HW-Lab-Hardware-Design-Agency/jetson-orin-baseboard/3Dlib/PCM12SMTR.step

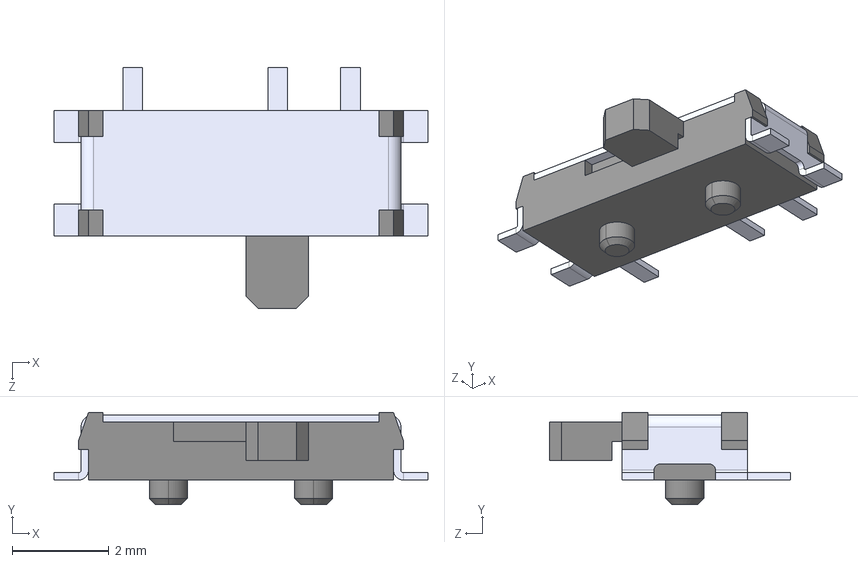
[picture p1: CAD file, 2025-03-19]
3Dlib/PCM12SMTR.step
7.72 x 1.91 x 4.98 mm
