HW-Lab-Hardware-Design-Agency/jetson-orin-baseboard/pulsador.FCStd

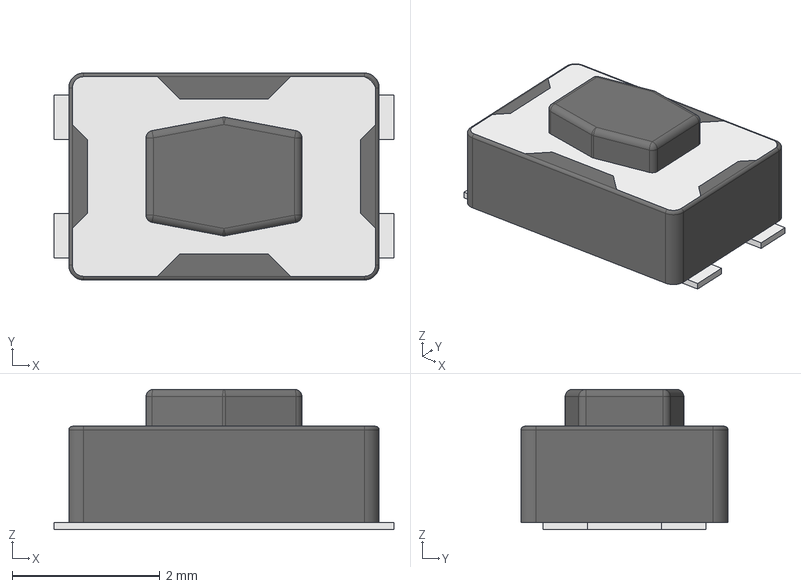
[picture p2: CAD file, 2025-02-21]
pulsador.FCStd
4.60 x 2.80 x 1.90 mm
