HW-Lab-Hardware-Design-Agency/jetson-orin-baseboard/3Dlib/USB4105-GF-A.STEP

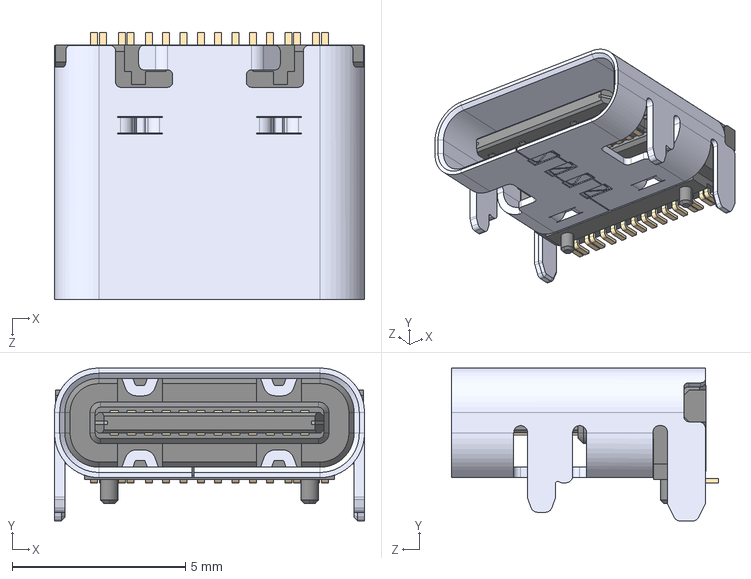
[picture p3: CAD file, 2025-03-05]
3Dlib/USB4105-GF-A.STEP
8.94 x 4.41 x 7.71 mm
