HW-Lab-Hardware-Design-Agency/jetson-orin-baseboard/3Dlib/TUSB1046-DCIRNQT.STEP

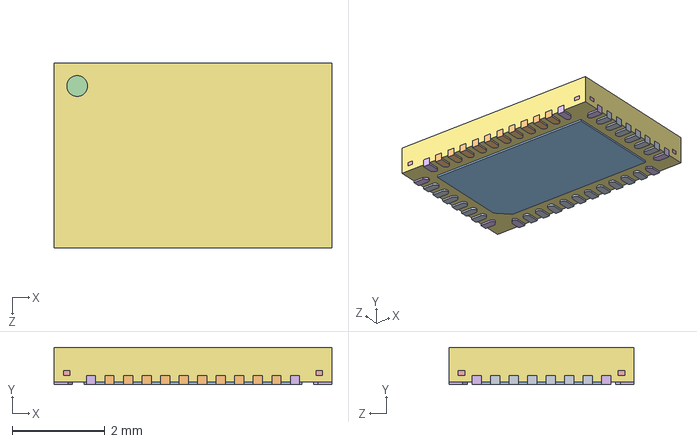
[picture p4: CAD file, 2025-03-05]
3Dlib/TUSB1046-DCIRNQT.STEP
6.00 x 0.8 x 4.00 mm
