HW-Lab-Hardware-Design-Agency/jetson-orin-baseboard/3Dlib/NTS0102GT,115.stp

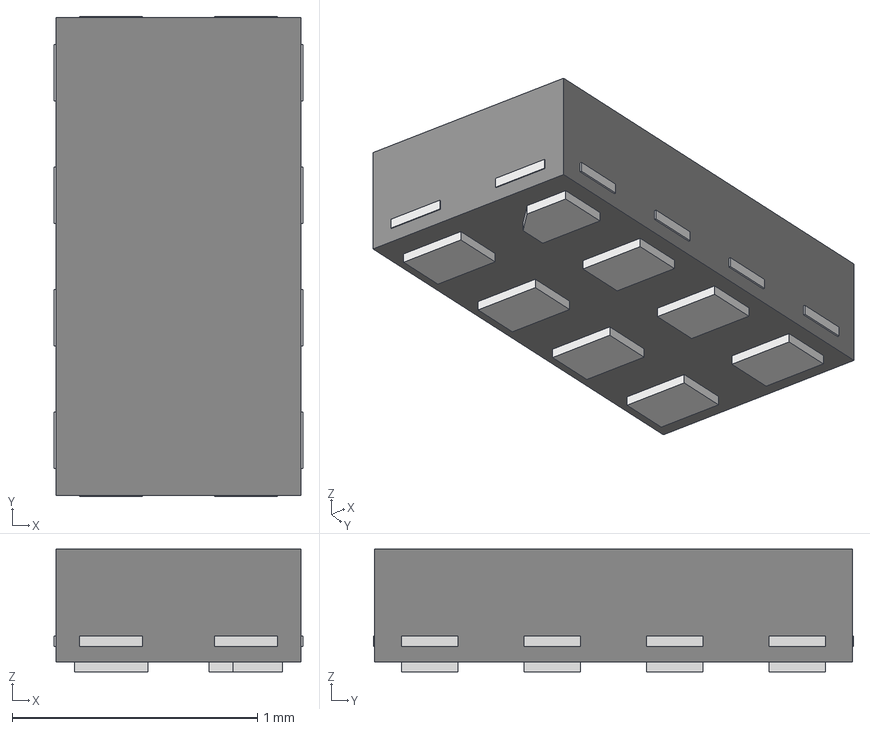
[picture p5: CAD file, 2025-02-21]
3Dlib/NTS0102GT,115.stp
1.02 x 1.96 x 0.5 mm
