HW-Lab-Hardware-Design-Agency/jetson-orin-baseboard/3Dlib/33FXRH-SM1-GAN-TF.STEP

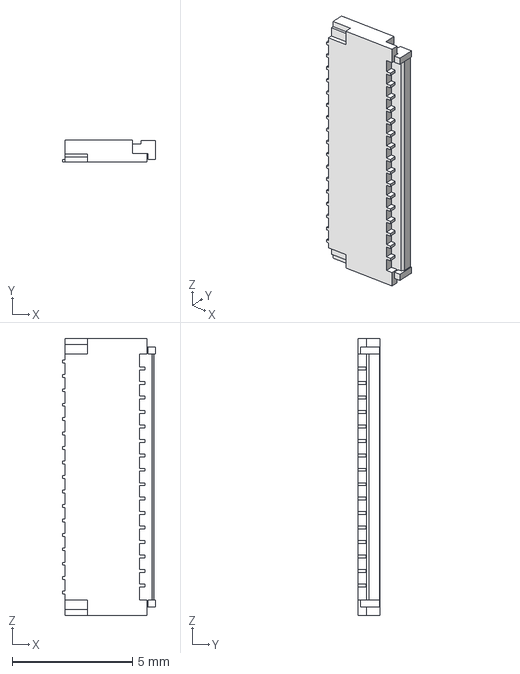
[picture p6: CAD file, 2025-02-21]
3Dlib/33FXRH-SM1-GAN-TF.STEP
3.85 x 0.9 x 11.5 mm
