HW-Lab-Hardware-Design-Agency/jetson-orin-baseboard/3Dlib/Crystal_SMD_3225-4Pin_3.2x2.5mm.step

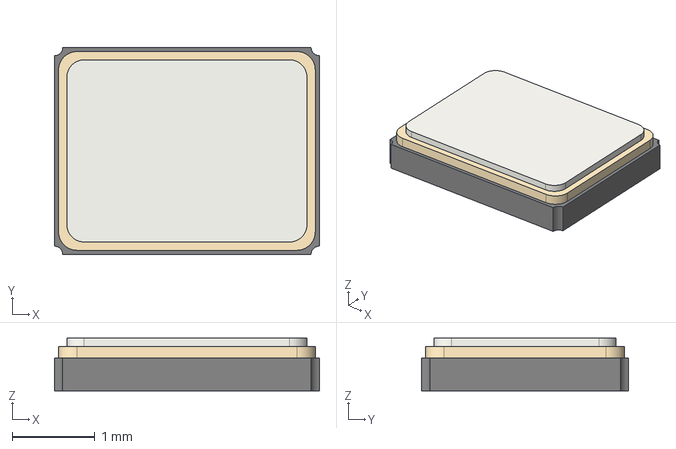
[picture p7: CAD file, 2025-02-21]
3Dlib/Crystal_SMD_3225-4Pin_3.2x2.5mm.step
3.20 x 2.50 x 0.64 mm
