HW-Lab-Hardware-Design-Agency/jetson-orin-baseboard/3Dlib/5-2337992-8.stp

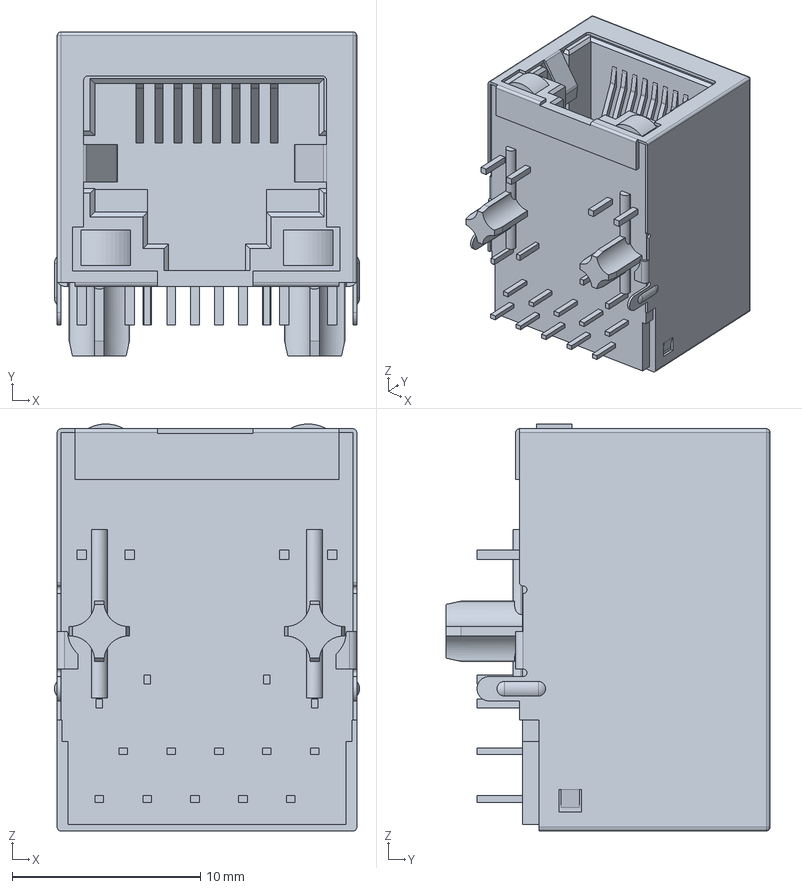
[picture p8: CAD file, 2025-02-21]
3Dlib/5-2337992-8.stp
16.2 x 17.2 x 21.6 mm
