HW-Lab-Hardware-Design-Agency/jetson-orin-baseboard/3Dlib/D_SMA.step

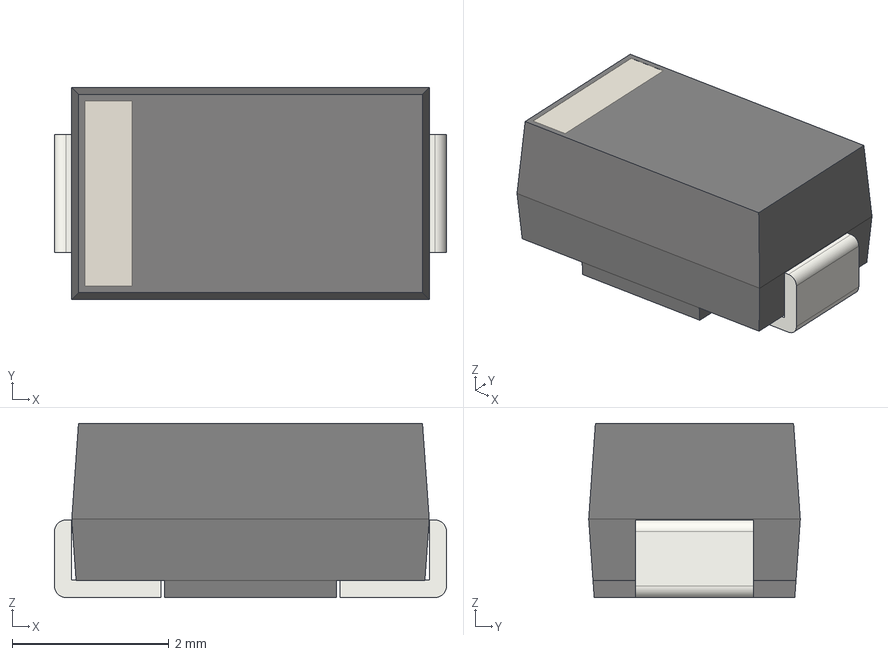
[picture p9: CAD file, 2025-02-21]
3Dlib/D_SMA.step
5.00 x 2.70 x 2.22 mm
