HW-Lab-Hardware-Design-Agency/jetson-orin-baseboard/3Dlib/ESP32-S3R8.stp

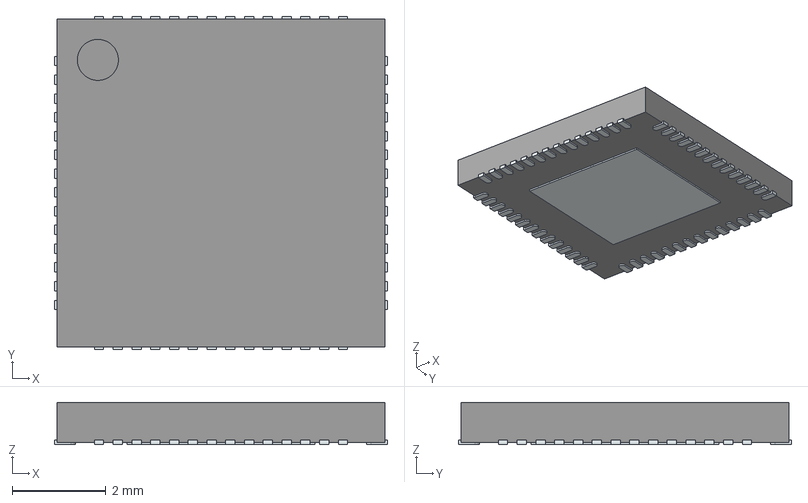
[picture p10: CAD file, 2025-02-21]
3Dlib/ESP32-S3R8.stp
7.10 x 7.10 x 0.9 mm
ThermalPin
PinsArrayLR
PinsArrayTB
