HW-Lab-Hardware-Design-Agency/jetson-orin-baseboard/3Dlib/L_1206_3216Metric.step

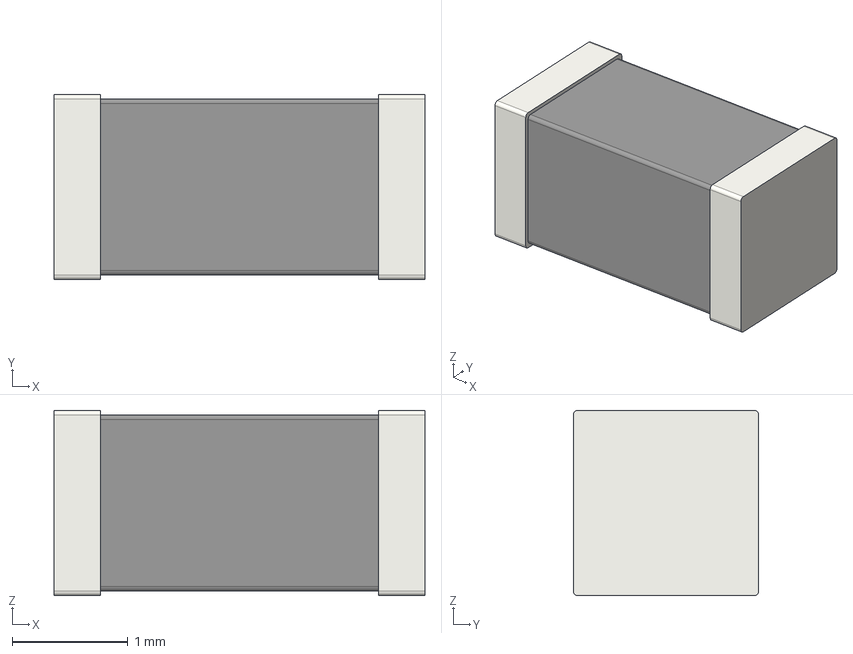
[picture p11: CAD file, 2025-02-21]
3Dlib/L_1206_3216Metric.step
3.20 x 1.60 x 1.60 mm
