HW-Lab-Hardware-Design-Agency/jetson-orin-baseboard/3Dlib/r_0402_h040.step

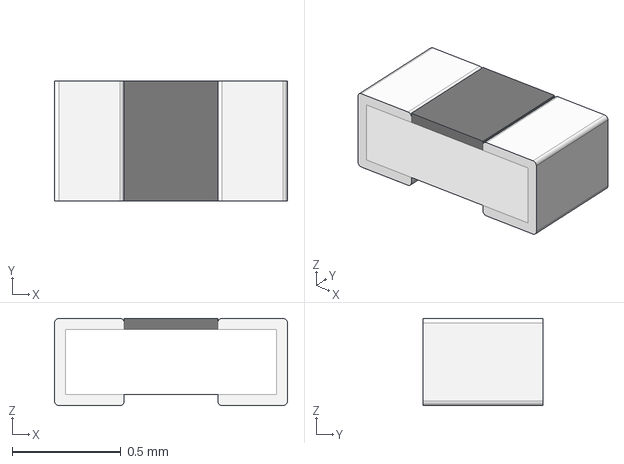
[picture p12: CAD file, 2025-02-21]
3Dlib/r_0402_h040.step
1.07 x 0.55 x 0.4 mm
