HW-Lab-Hardware-Design-Agency/jetson-orin-baseboard/3Dlib/SOT-23-6.step

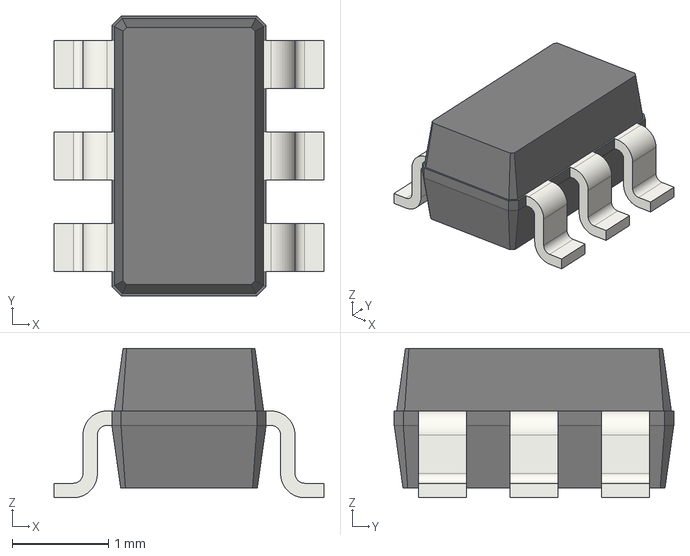
[picture p13: CAD file, 2025-02-21]
3Dlib/SOT-23-6.step
2.80 x 2.90 x 1.55 mm
