HW-Lab-Hardware-Design-Agency/jetson-orin-baseboard/3Dlib/c_1206_h078.step

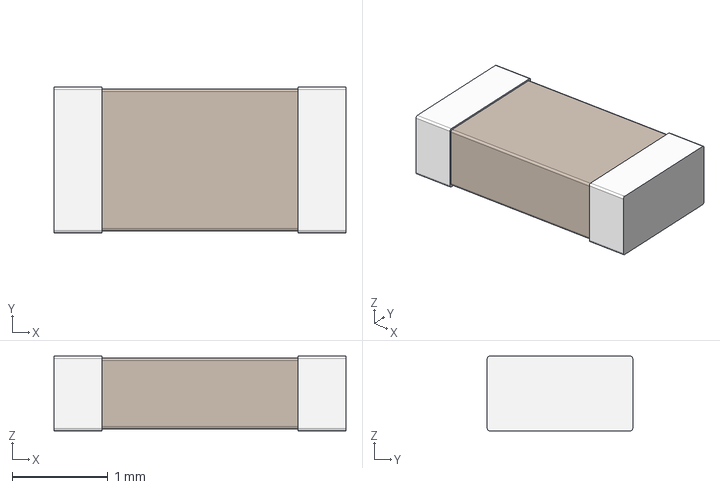
[picture p14: CAD file, 2025-02-21]
3Dlib/c_1206_h078.step
3.05 x 1.52 x 0.78 mm
