HW-Lab-Hardware-Design-Agency/jetson-orin-baseboard/3Dlib/USB_C_HC019-1E1H1A103-0HR.step

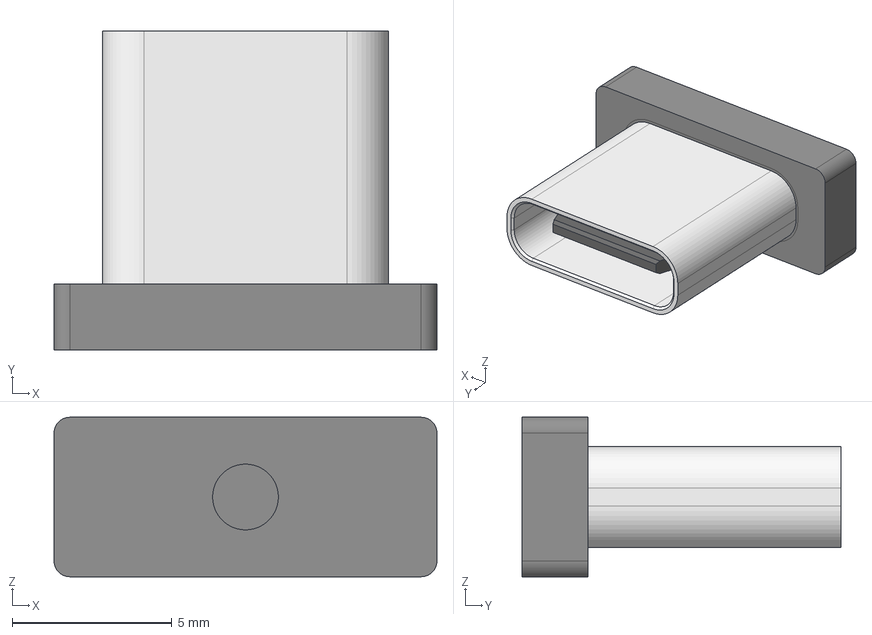
[picture p15: CAD file, 2025-02-21]
3Dlib/USB_C_HC019-1E1H1A103-0HR.step
12.0 x 10.0 x 5.00 mm
