HW-Lab-Hardware-Design-Agency/jetson-orin-baseboard/3Dlib/L_0402_1005Metric.step

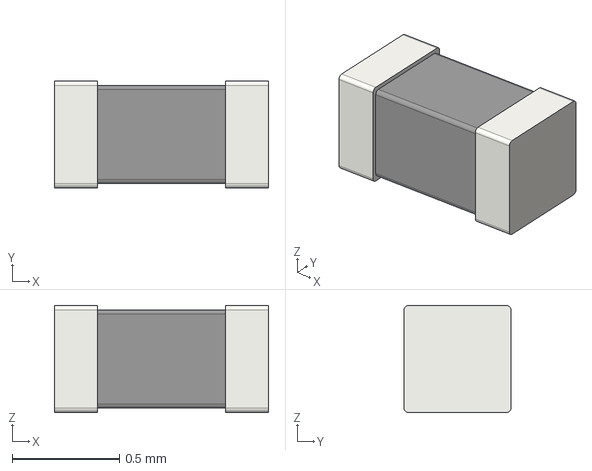
[picture p16: CAD file, 2025-02-21]
3Dlib/L_0402_1005Metric.step
1.00 x 0.5 x 0.5 mm
