HW-Lab-Hardware-Design-Agency/jetson-orin-baseboard/3Dlib/D_SOD-523.step

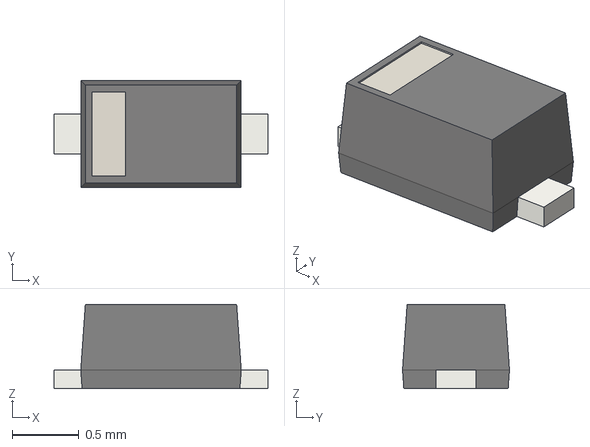
[picture p17: CAD file, 2025-02-21]
3Dlib/D_SOD-523.step
1.60 x 0.8 x 0.63 mm
