HW-Lab-Hardware-Design-Agency/jetson-orin-baseboard/3Dlib/SOT-223.step

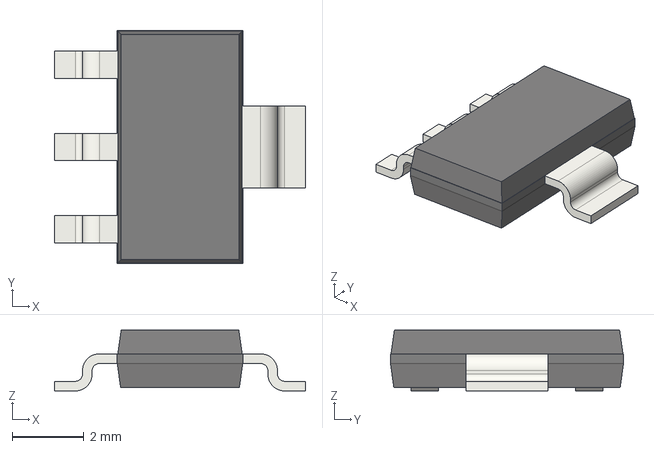
[picture p18: CAD file, 2025-02-21]
3Dlib/SOT-223.step
7.00 x 6.50 x 1.70 mm
