HW-Lab-Hardware-Design-Agency/jetson-orin-baseboard/3Dlib/TPD1E0B04DPYR.STEP

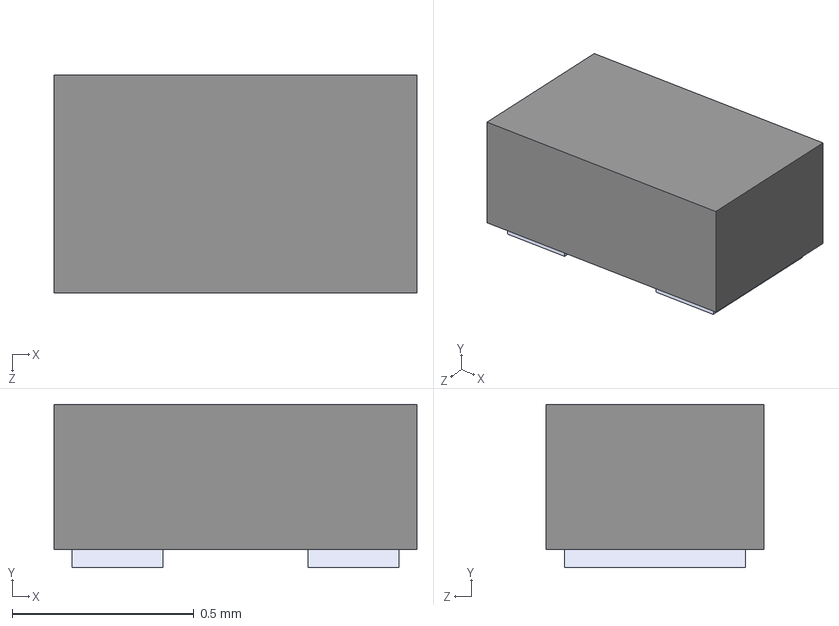
[picture p19: CAD file, 2025-02-21]
3Dlib/TPD1E0B04DPYR.STEP
1.00 x 0.45 x 0.6 mm
