HW-Lab-Hardware-Design-Agency/jetson-orin-baseboard/3Dlib/MS621FE-FL11E--3DModel-STEP-510211.STEP

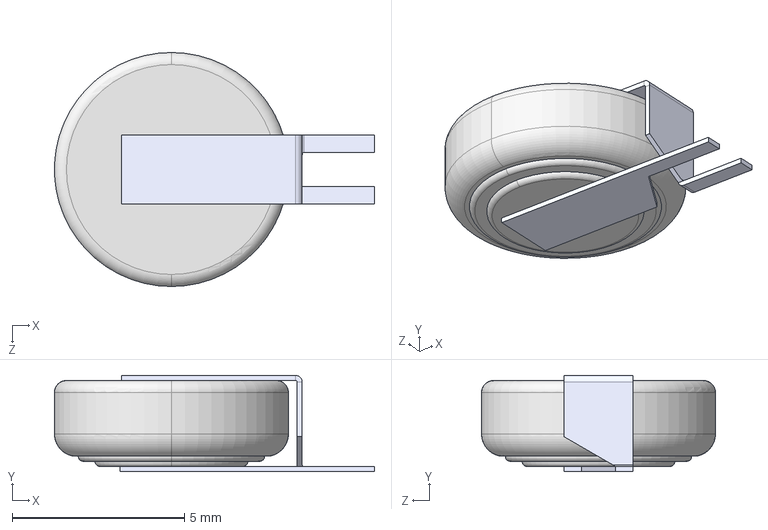
[picture p20: CAD file, 2025-02-21]
3Dlib/MS621FE-FL11E--3DModel-STEP-510211.STEP
9.30 x 2.80 x 6.80 mm
