HW-Lab-Hardware-Design-Agency/jetson-orin-baseboard/3Dlib/c_1210.step

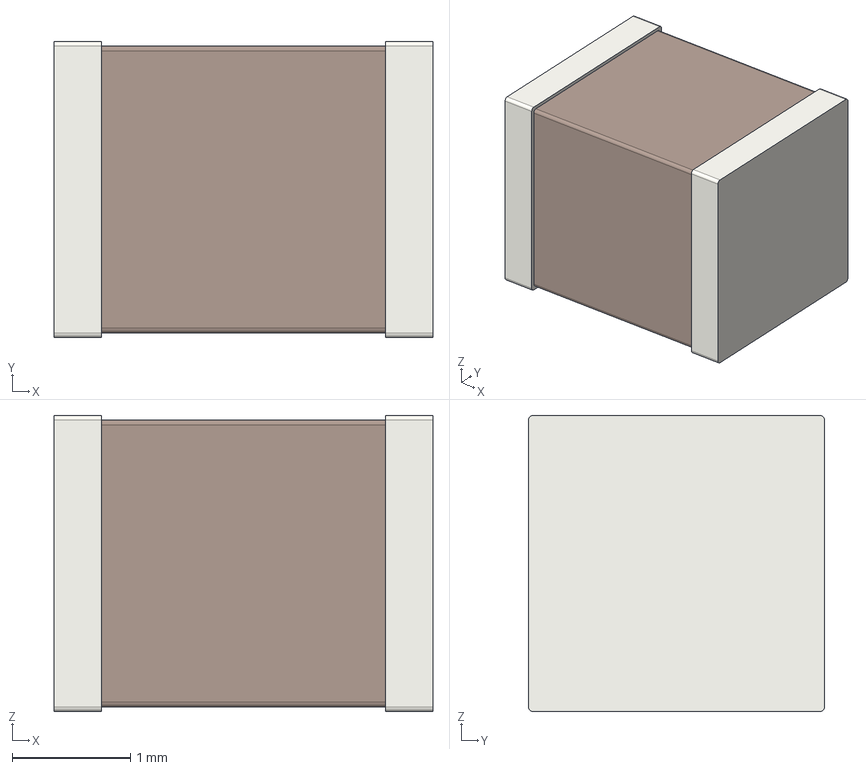
[picture p21: CAD file, 2025-02-21]
3Dlib/c_1210.step
3.20 x 2.50 x 2.50 mm
