HW-Lab-Hardware-Design-Agency/jetson-orin-baseboard/3Dlib/soic_8_39x49_p127.step

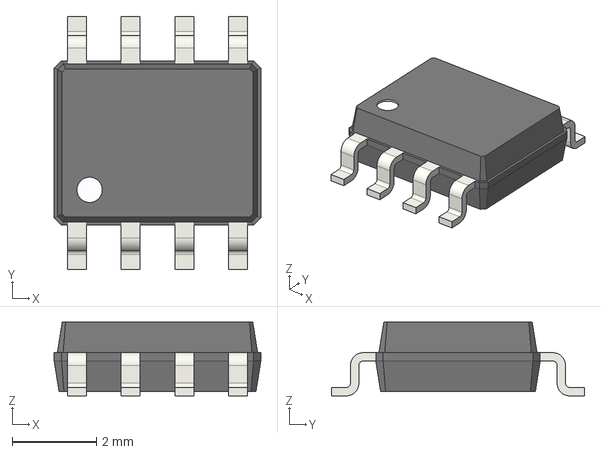
[picture p22: CAD file, 2025-02-21]
3Dlib/soic_8_39x49_p127.step
4.90 x 6.00 x 1.75 mm
