HW-Lab-Hardware-Design-Agency/jetson-orin-baseboard/3Dlib/MDA7030-220M.step

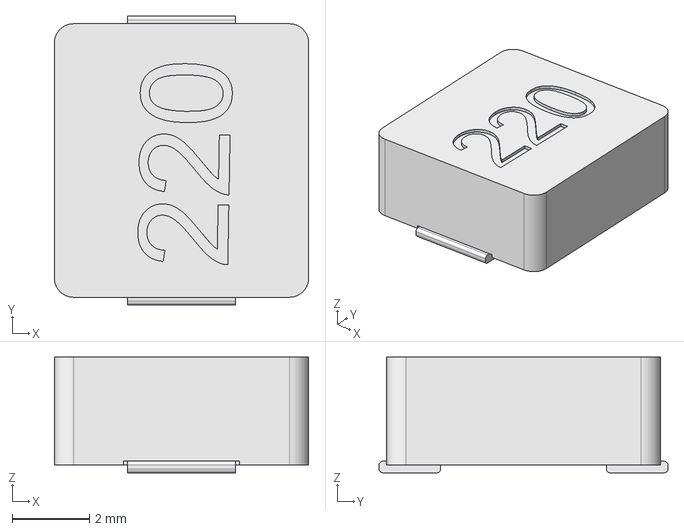
[picture p23: CAD file, 2025-02-21]
3Dlib/MDA7030-220M.step
6.60 x 7.50 x 3.00 mm
