HW-Lab-Hardware-Design-Agency/jetson-orin-baseboard/3Dlib/led_0603.step

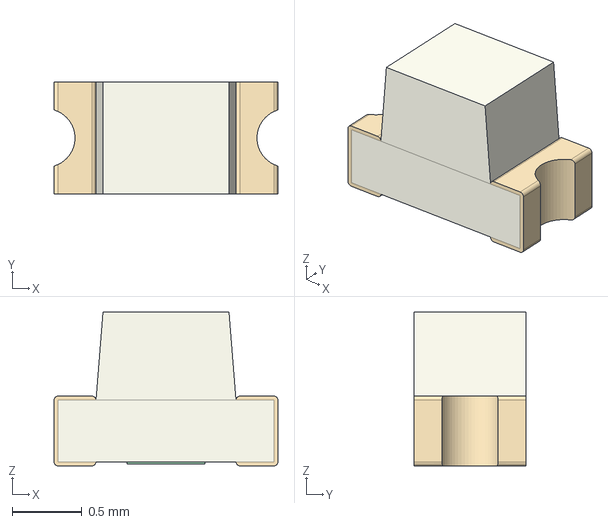
[picture p24: CAD file, 2025-02-21]
3Dlib/led_0603.step
1.60 x 0.8 x 1.10 mm
