HW-Lab-Hardware-Design-Agency/jetson-orin-baseboard/3Dlib/L_0201_0603Metric.step

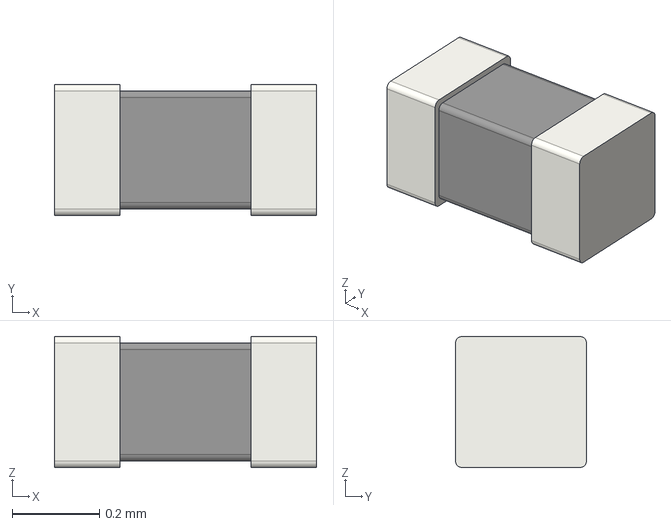
[picture p25: CAD file, 2025-02-21]
3Dlib/L_0201_0603Metric.step
0.6 x 0.3 x 0.3 mm
