HW-Lab-Hardware-Design-Agency/jetson-orin-baseboard/3Dlib/AXPM65611.step

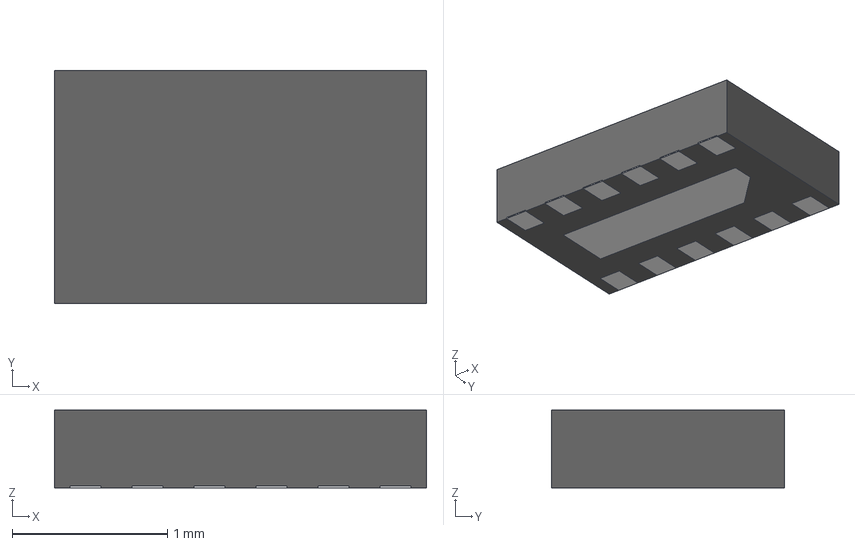
[picture p26: CAD file, 2025-02-21]
3Dlib/AXPM65611.step
2.40 x 1.50 x 0.5 mm
main_Body001
mainPad001
