HW-Lab-Hardware-Design-Agency/jetson-orin-baseboard/3Dlib/B3U_1000P.step

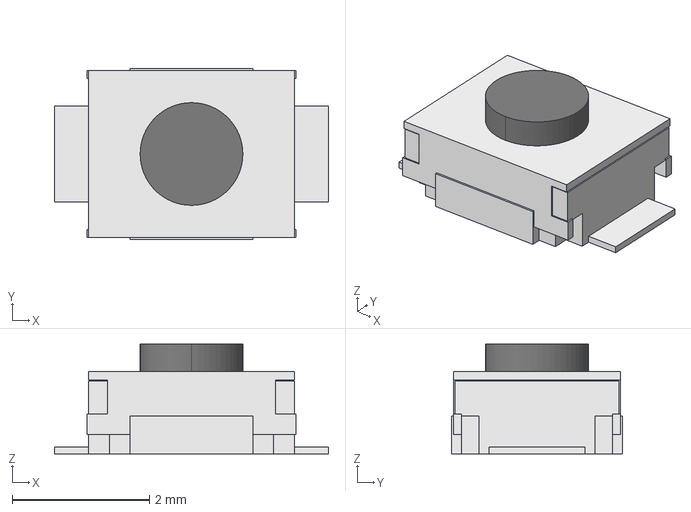
[picture p27: CAD file, 2025-02-21]
3Dlib/B3U_1000P.step
4.00 x 2.50 x 1.60 mm
