HW-Lab-Hardware-Design-Agency/jetson-orin-baseboard/3Dlib/sot23_3_25x30_p095.step

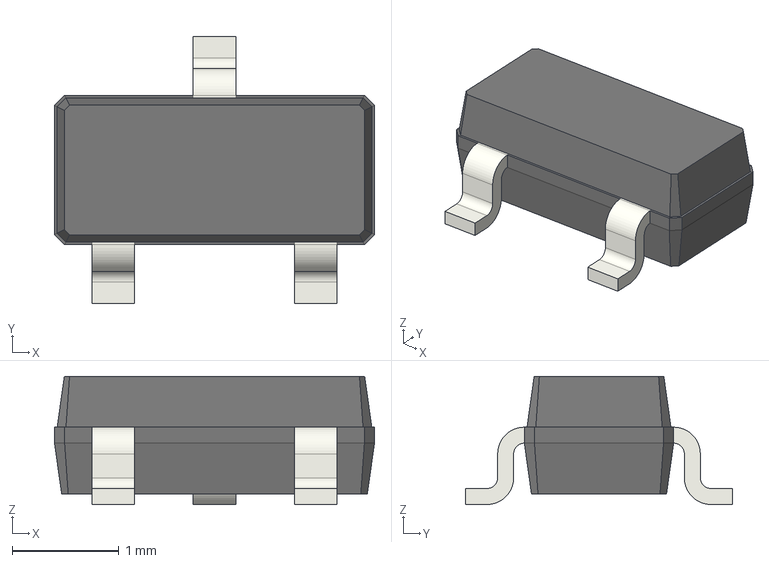
[picture p28: CAD file, 2025-02-21]
3Dlib/sot23_3_25x30_p095.step
3.00 x 2.50 x 1.20 mm
