HW-Lab-Hardware-Design-Agency/jetson-orin-baseboard/3Dlib/D_SOD-123.step

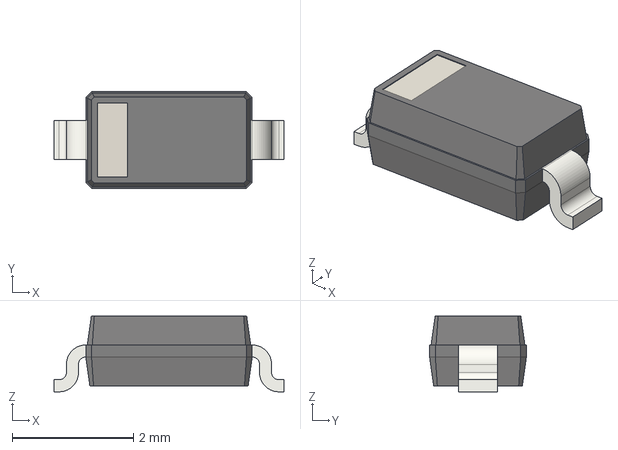
[picture p29: CAD file, 2025-02-21]
3Dlib/D_SOD-123.step
3.80 x 1.60 x 1.25 mm
