HW-Lab-Hardware-Design-Agency/jetson-orin-baseboard/3Dlib/c_0603_h078.step

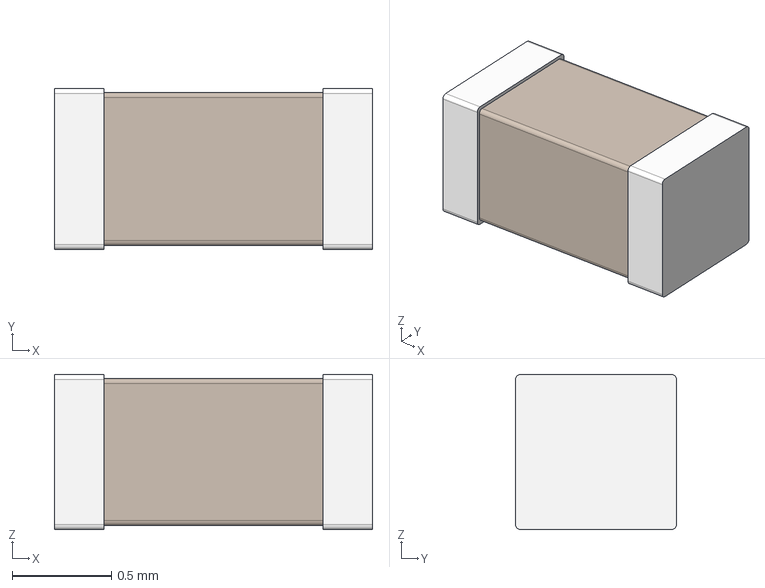
[picture p31: CAD file, 2025-02-21]
3Dlib/c_0603_h078.step
1.60 x 0.81 x 0.78 mm
