HW-Lab-Hardware-Design-Agency/jetson-orin-baseboard/3Dlib/BRFL2518T1R0M.STEP

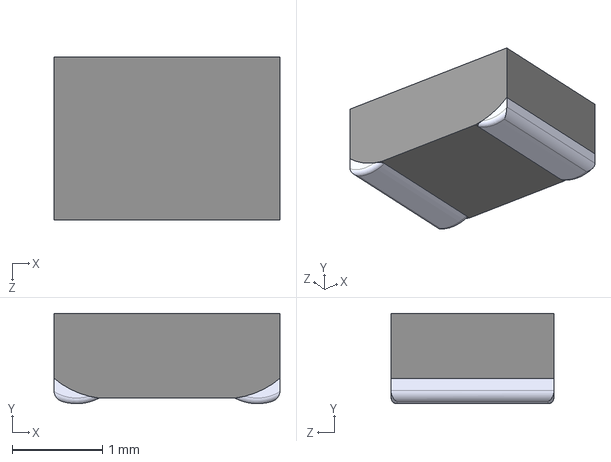
[picture p32: CAD file, 2025-02-21]
3Dlib/BRFL2518T1R0M.STEP
2.50 x 1 x 1.80 mm
