HW-Lab-Hardware-Design-Agency/jetson-orin-baseboard/3Dlib/c_0805_h078.step

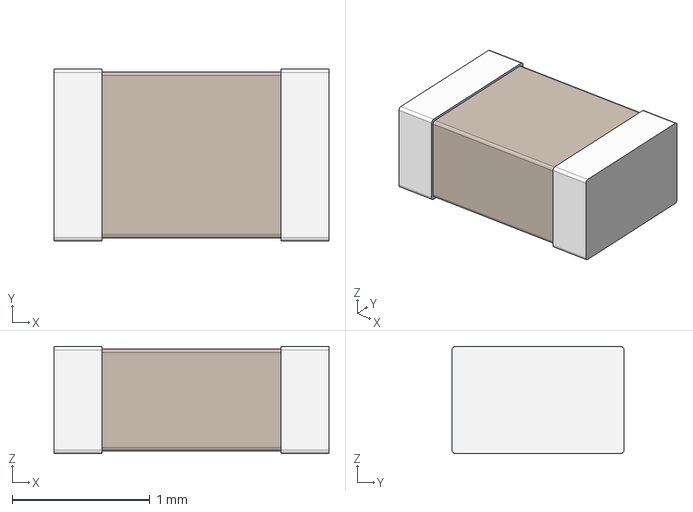
[picture p33: CAD file, 2025-02-21]
3Dlib/c_0805_h078.step
2.00 x 1.25 x 0.78 mm
