HW-Lab-Hardware-Design-Agency/jetson-orin-baseboard/3Dlib/T521D107M025ATE040.step

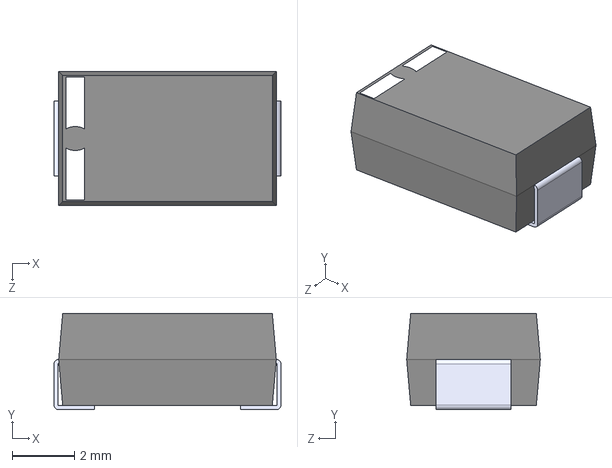
[picture p34: CAD file, 2025-02-21]
3Dlib/T521D107M025ATE040.step
7.30 x 3.10 x 4.30 mm
