HW-Lab-Hardware-Design-Agency/jetson-orin-baseboard/3Dlib/r_0603_h078.step

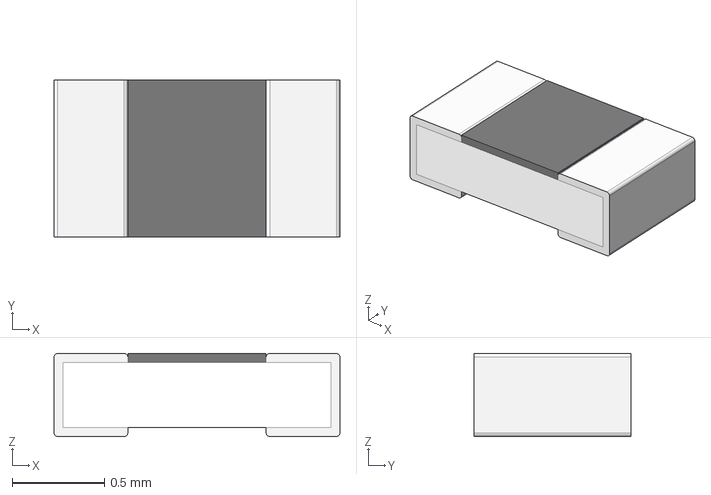
[picture p35: CAD file, 2025-02-21]
3Dlib/r_0603_h078.step
1.55 x 0.85 x 0.45 mm
