HW-Lab-Hardware-Design-Agency/jetson-orin-baseboard/3Dlib/SY8089A1AAC.stp

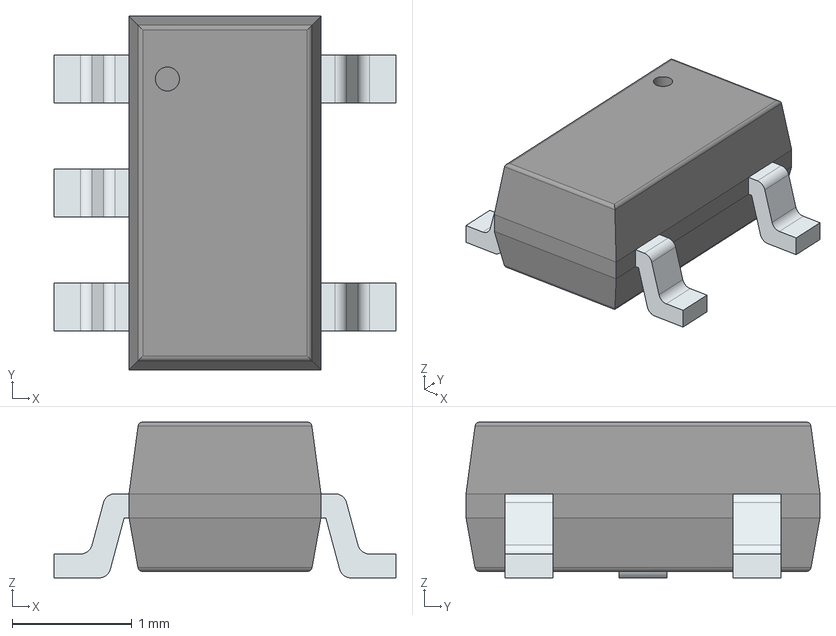
[picture p36: CAD file, 2025-02-21]
3Dlib/SY8089A1AAC.stp
2.85 x 2.95 x 1.30 mm
PinsArrayL
PinsArrayR
