HW-Lab-Hardware-Design-Agency/jetson-orin-baseboard/(list of files, cad)

Other CAD files:
3Dlib/c_1206_h160.step
3Dlib/C_0402_1005Metric.step
3Dlib/KMR211NGLFS.stp
3Dlib/C_0201_0603Metric.step
3Dlib/1054301202.stp
3Dlib/533980471.stp
3Dlib/632723300011.stp
3Dlib/685119136923.stp
3Dlib/68715014522.stp
3Dlib/9774065151.stp
3Dlib/DFE252012P-1R0M=P2.STEP
