HW-Lab-Hardware-Design-Agency/jetson-orin-baseboard/sheets/jetson-orin-baseboard.pdf

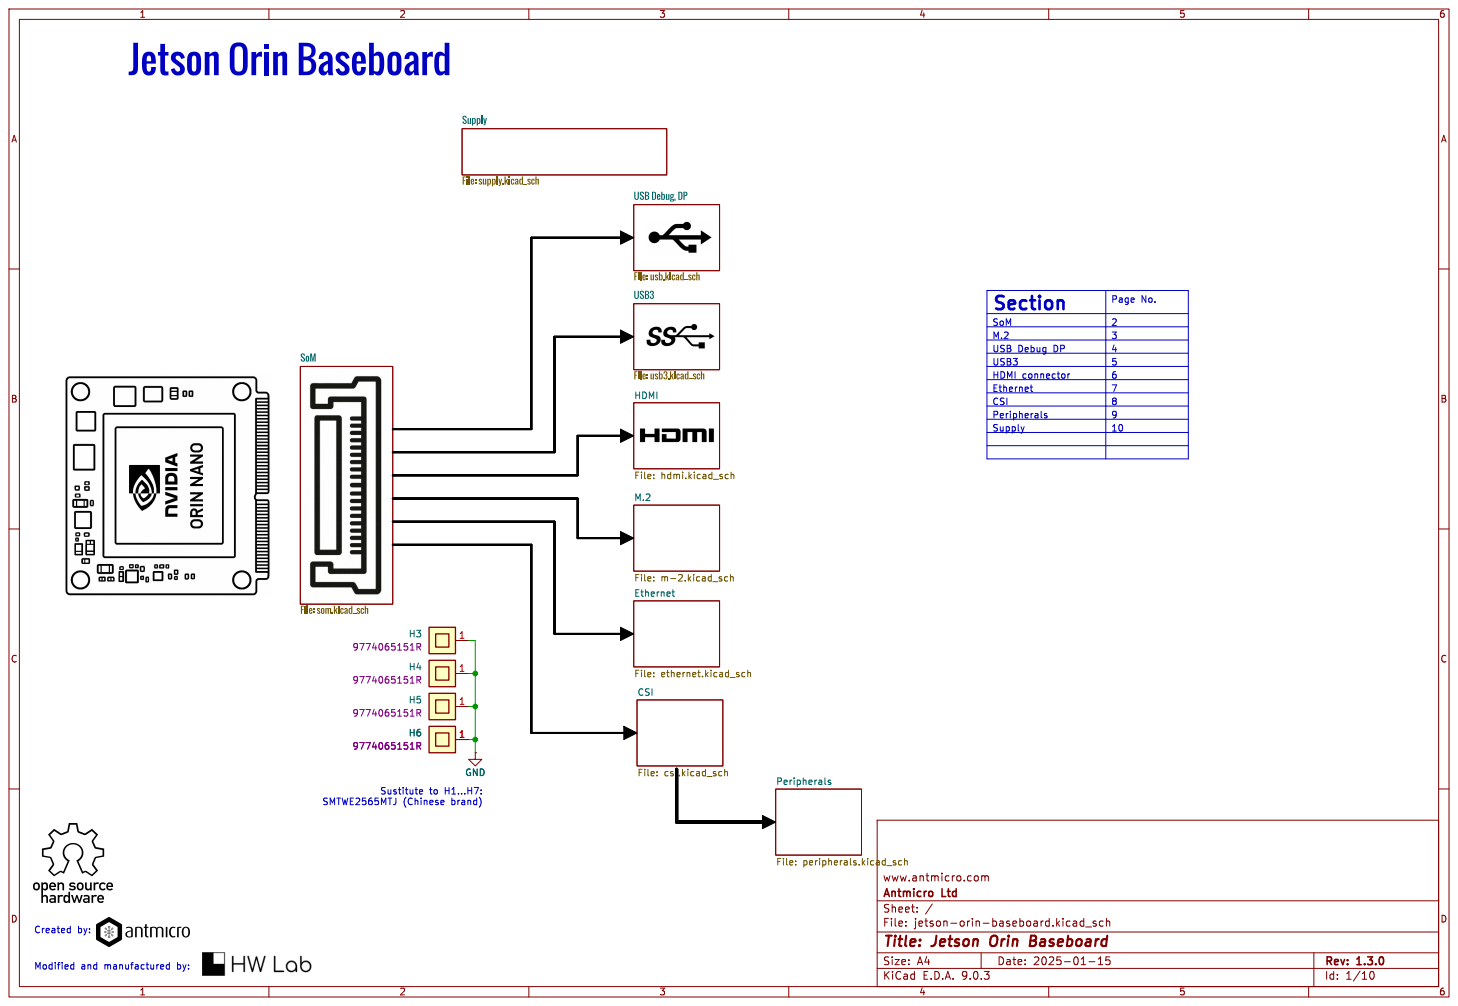
[picture p37: page 1]

Supply File:supply.kicad_sch SoM

Id: 1/10 Title: Jetson Orin Baseboard

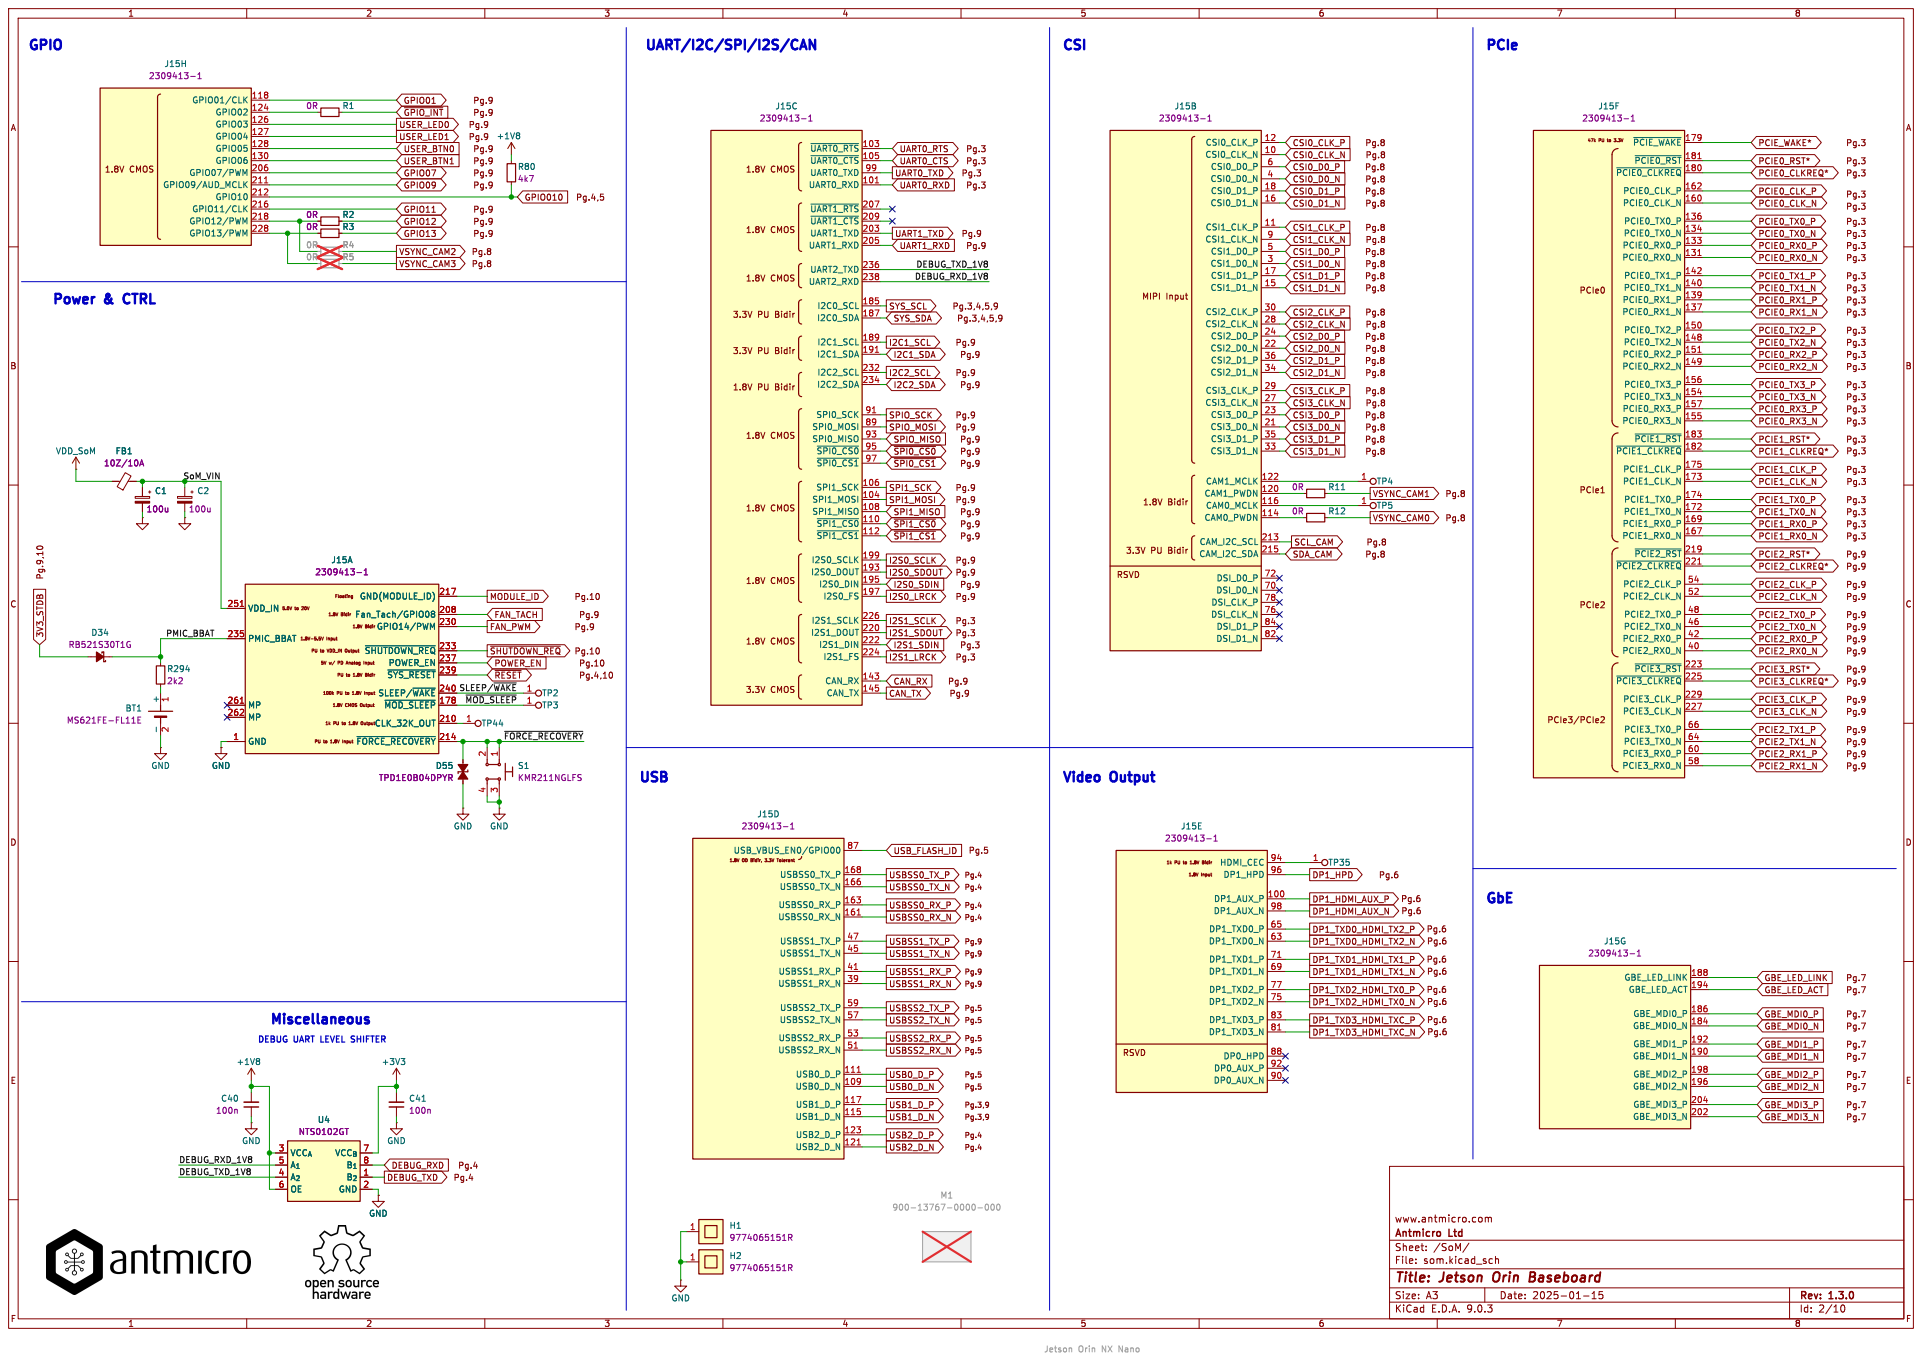
[picture p38: page 2]

1.8V CMOS
3.3V PU Bidir 3.3V PU Bidir 1.8V PU Bidir 1.8V CMOS
I2C2_SDA 234 SPI0_SCK 91 SPI0_MOSI 89 SPI0_MISO 93 ~{SPI0_CS0}95 ~{SPI0_CS1}97 SPI1_SCK 106 SPI1_MOSI 104 SPI1_MISO 108 ~{SPI1_CS0}110 ~{SPI1_CS1}112

DEBUG_RXD_1V8
MIPI Input 1.8V Bidir 3.3V PU Bidir RSVD

Video Output
1k PU to 1.8V Bidir 1.8V Input RSVD

DEBUG UART LEVEL SHIFTER Miscellaneous

Id: 2/10 Title: Jetson Orin Baseboard

Jetson Orin NX Nano

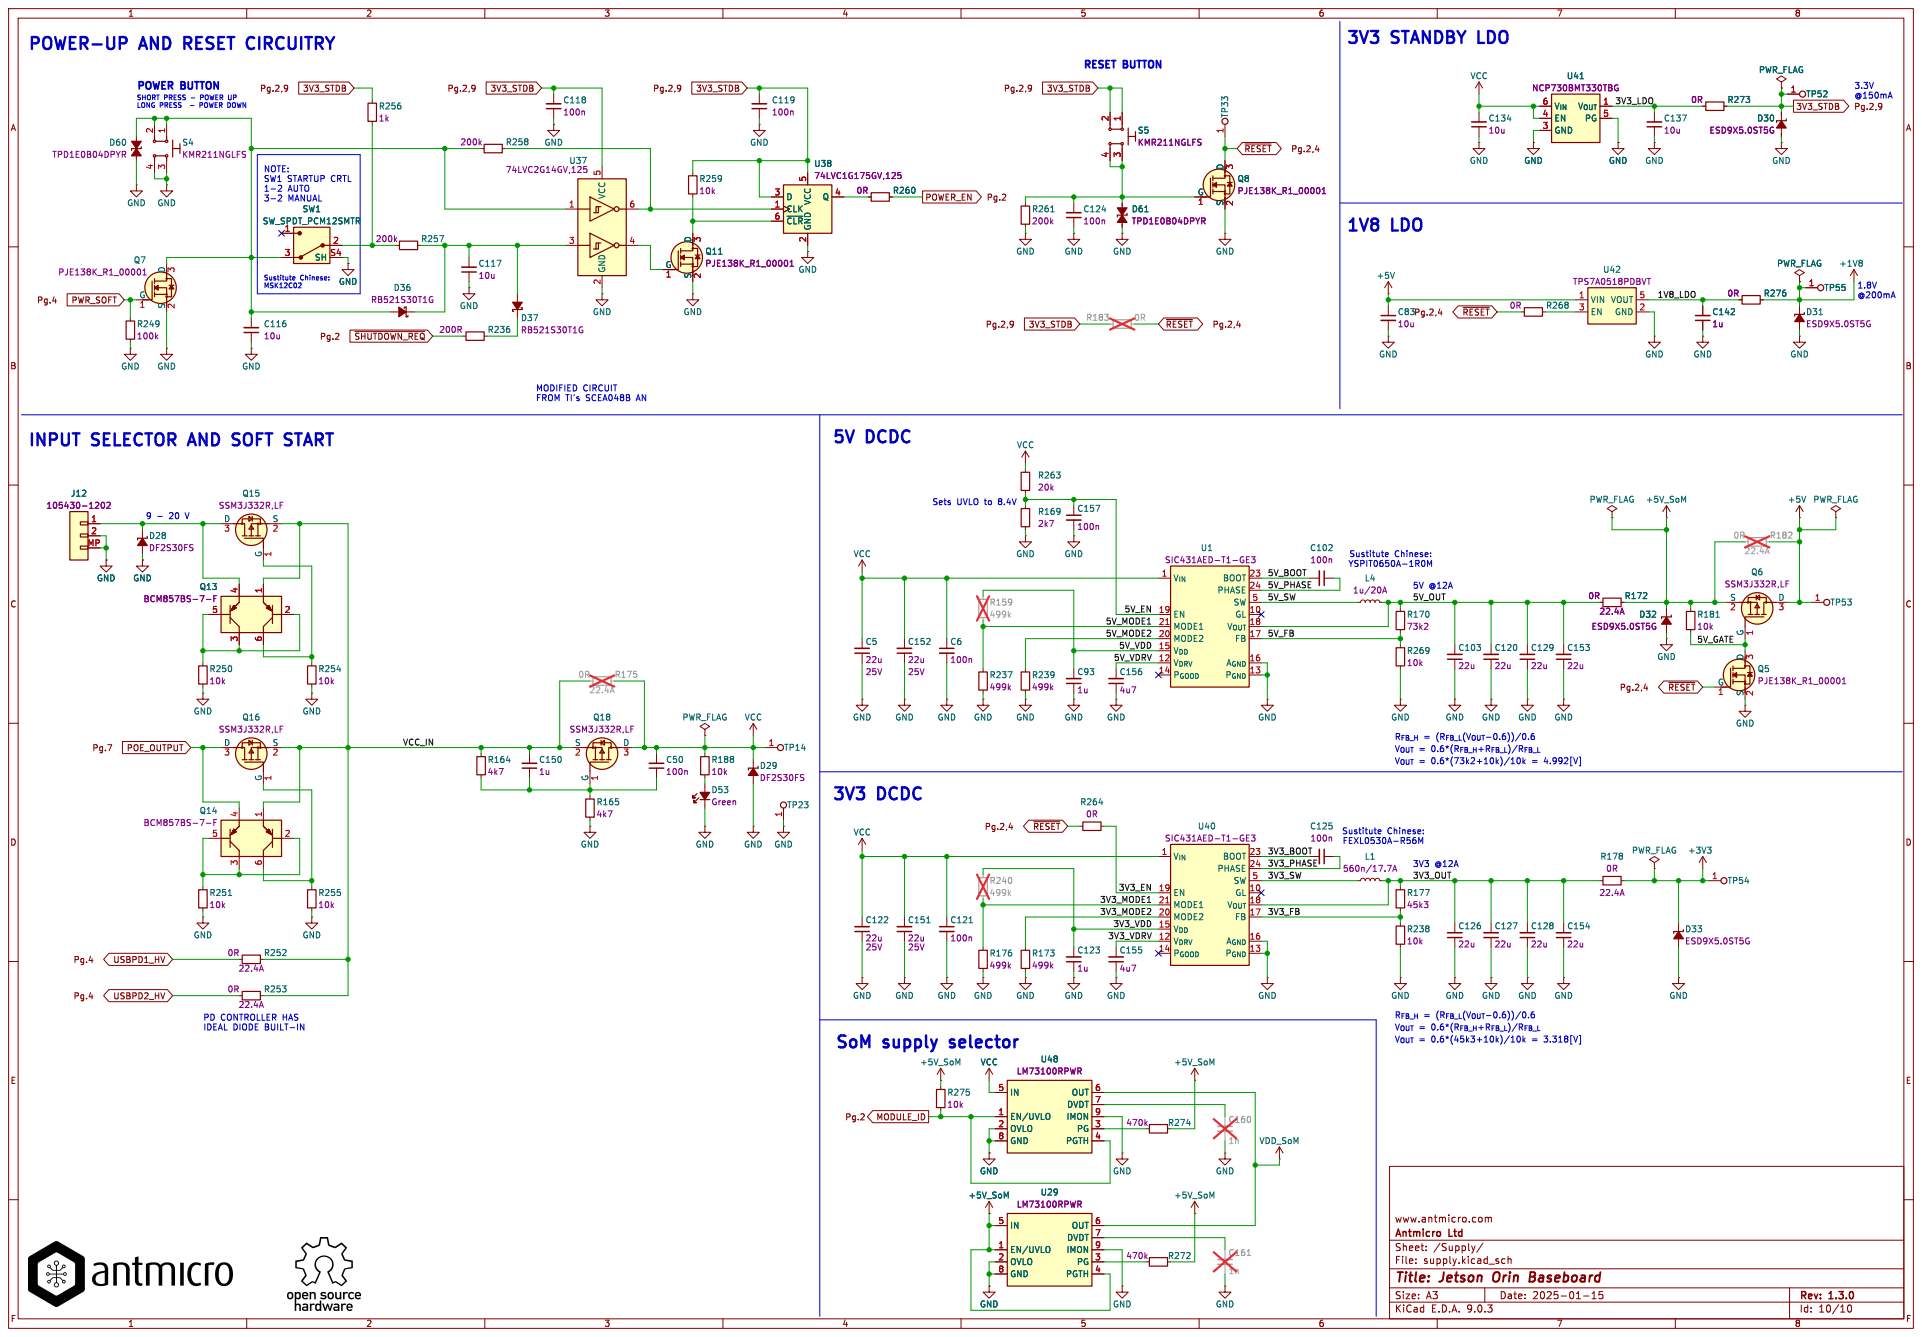
[picture p39: page 3]

POWER-UP AND RESET CIRCUITRY

POWER BUTTON
SHORT PRESS - POWER UP

INPUT SELECTOR AND SOFT START
D28 DF2S30FS GND

PD CONTROLLER HAS
IDEAL DIODE BUILT-IN

IMON 9 PG 3 PGTH 4 GND GND

Id: 10/10 Title: Jetson Orin Baseboard

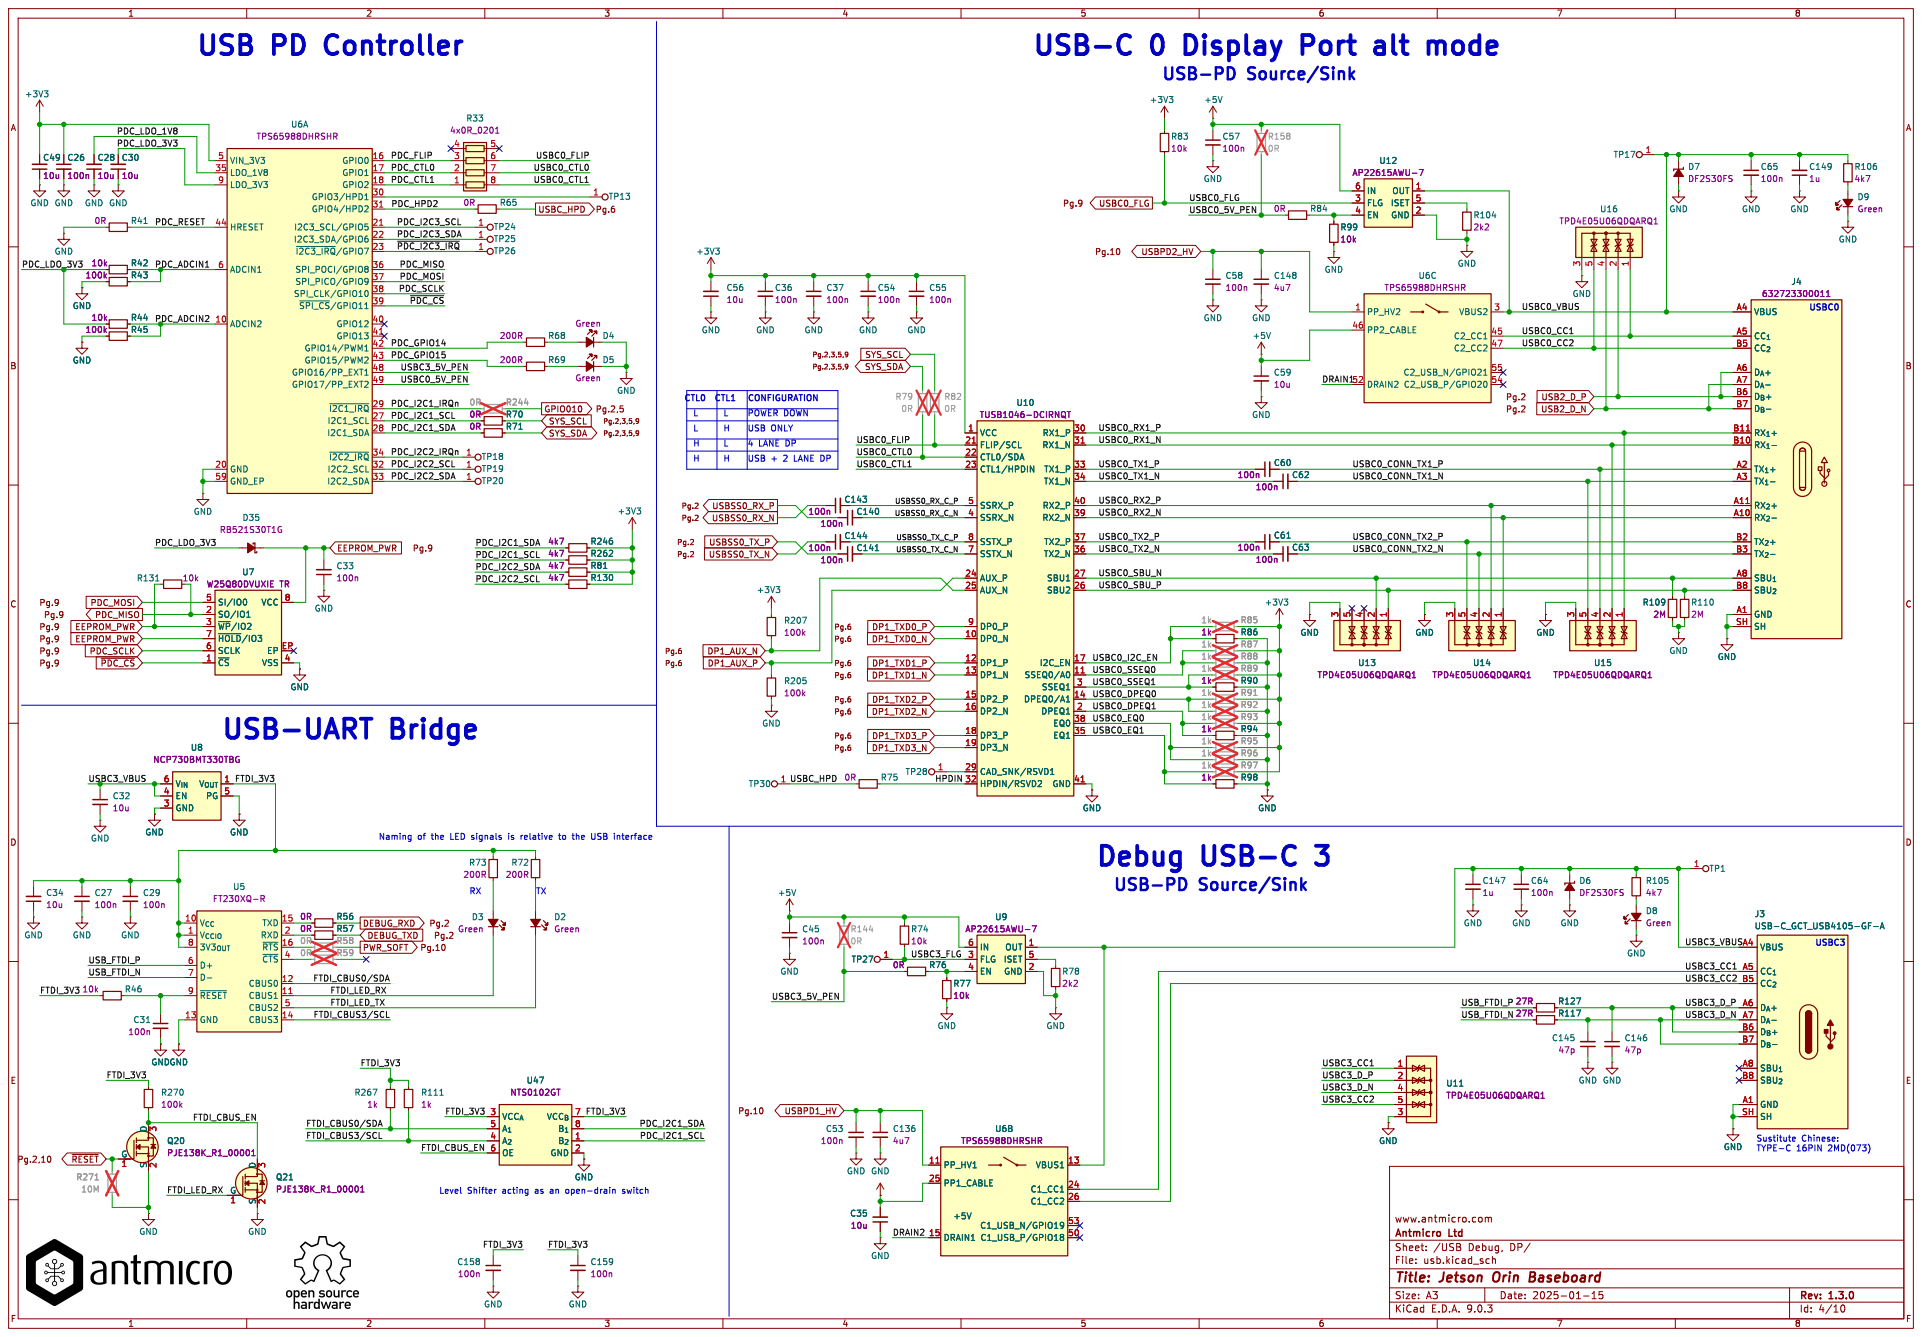
[picture p40: page 4]

Id: 4/10 Title: Jetson Orin Baseboard

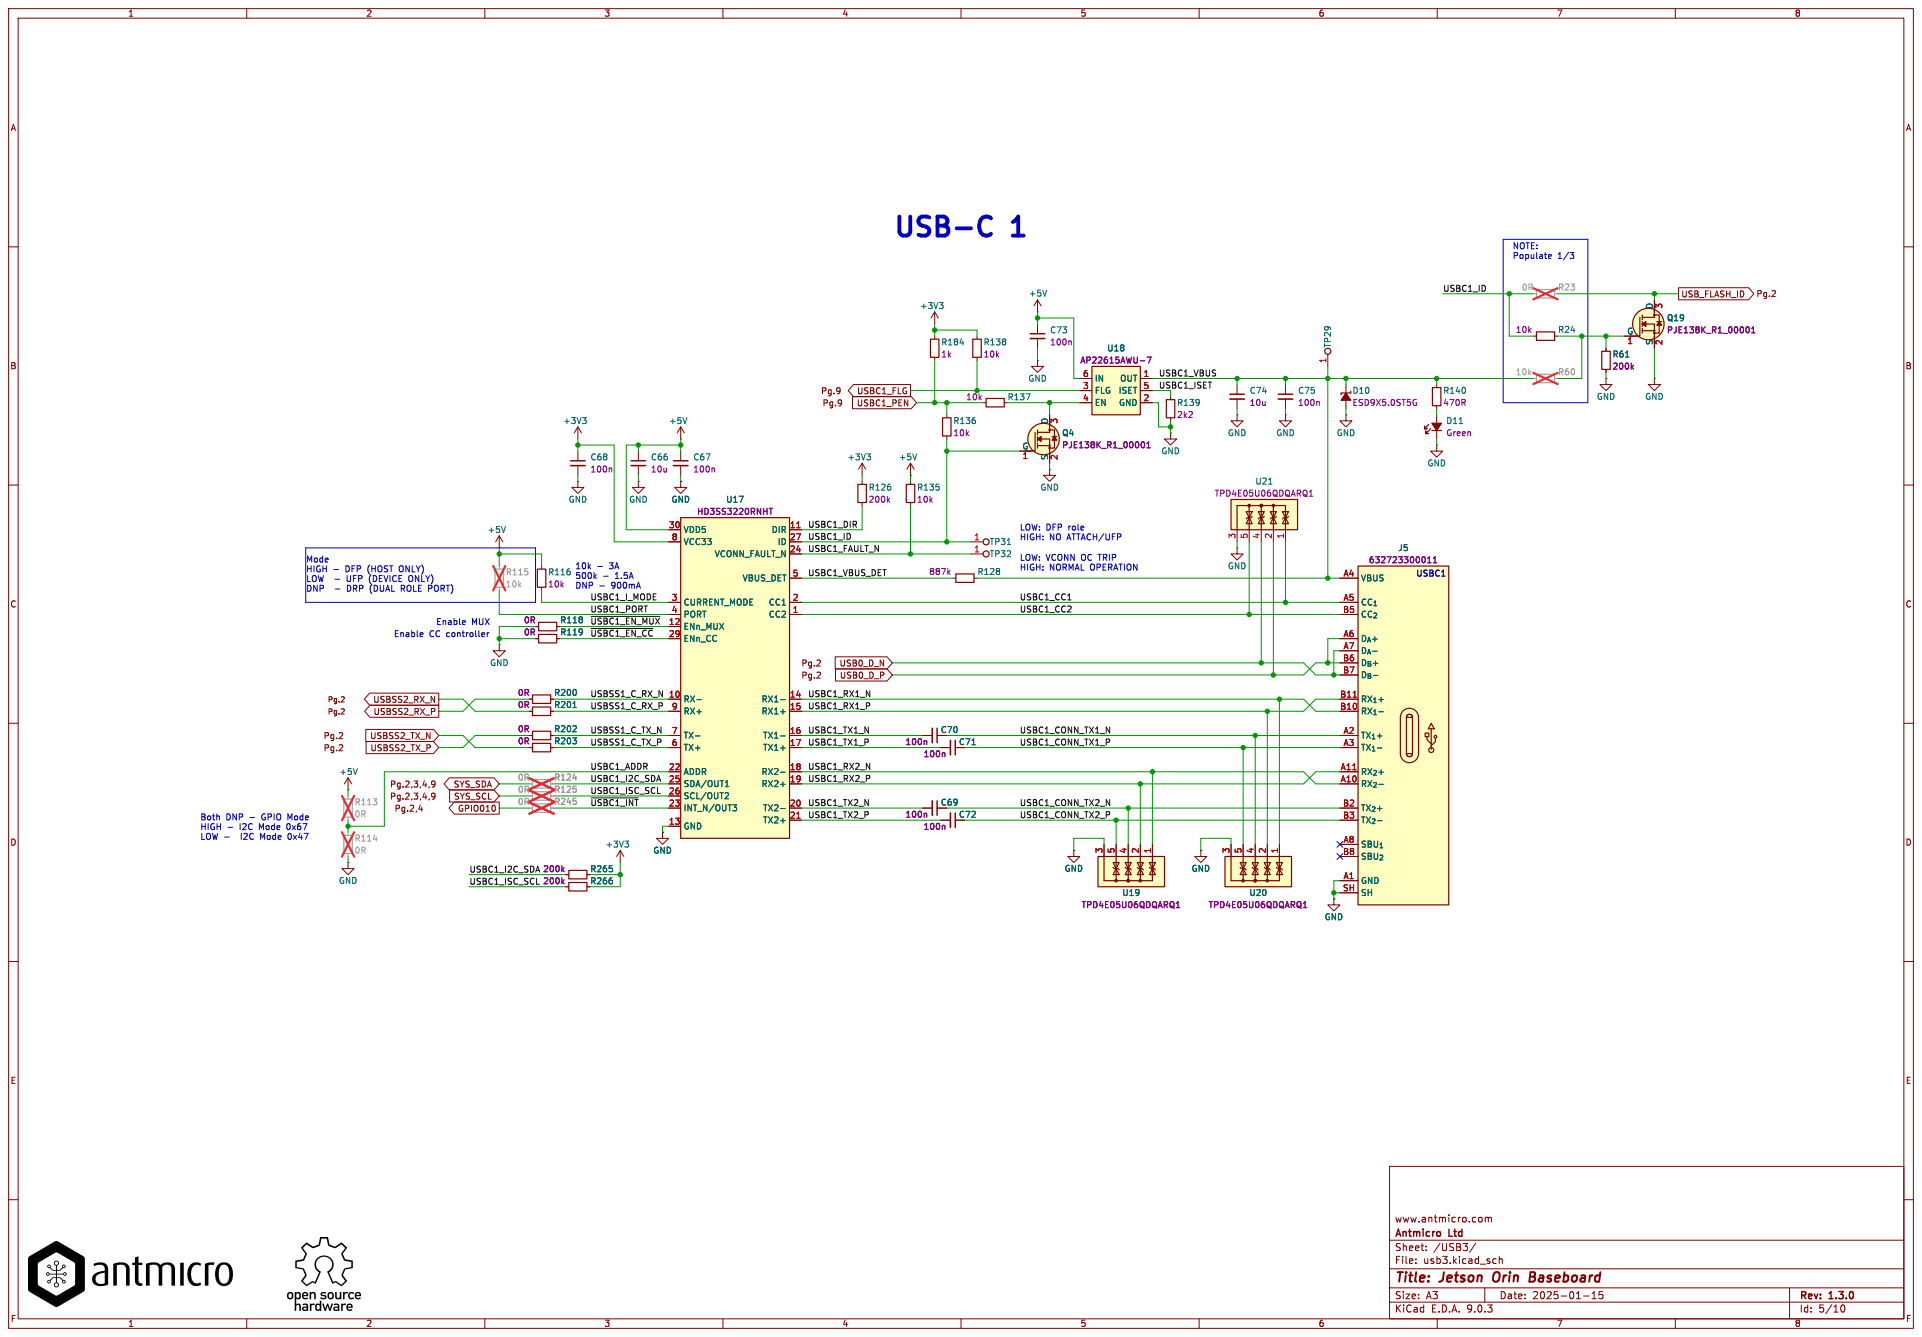
[picture p41: page 5]

LOW: DFP role HIGH: NO ATTACH/UFP

500k - 1.5A DNP - 900mA Mode HIGH - DFP (HOST ONLY) LOW - UFP (DEVICE ONLY) DNP - DRP (DUAL ROLE PORT) Enable MUX

LOW: VCONN OC TRIP HIGH: NORMAL OPERATION

Id: 5/10 Title: Jetson Orin Baseboard

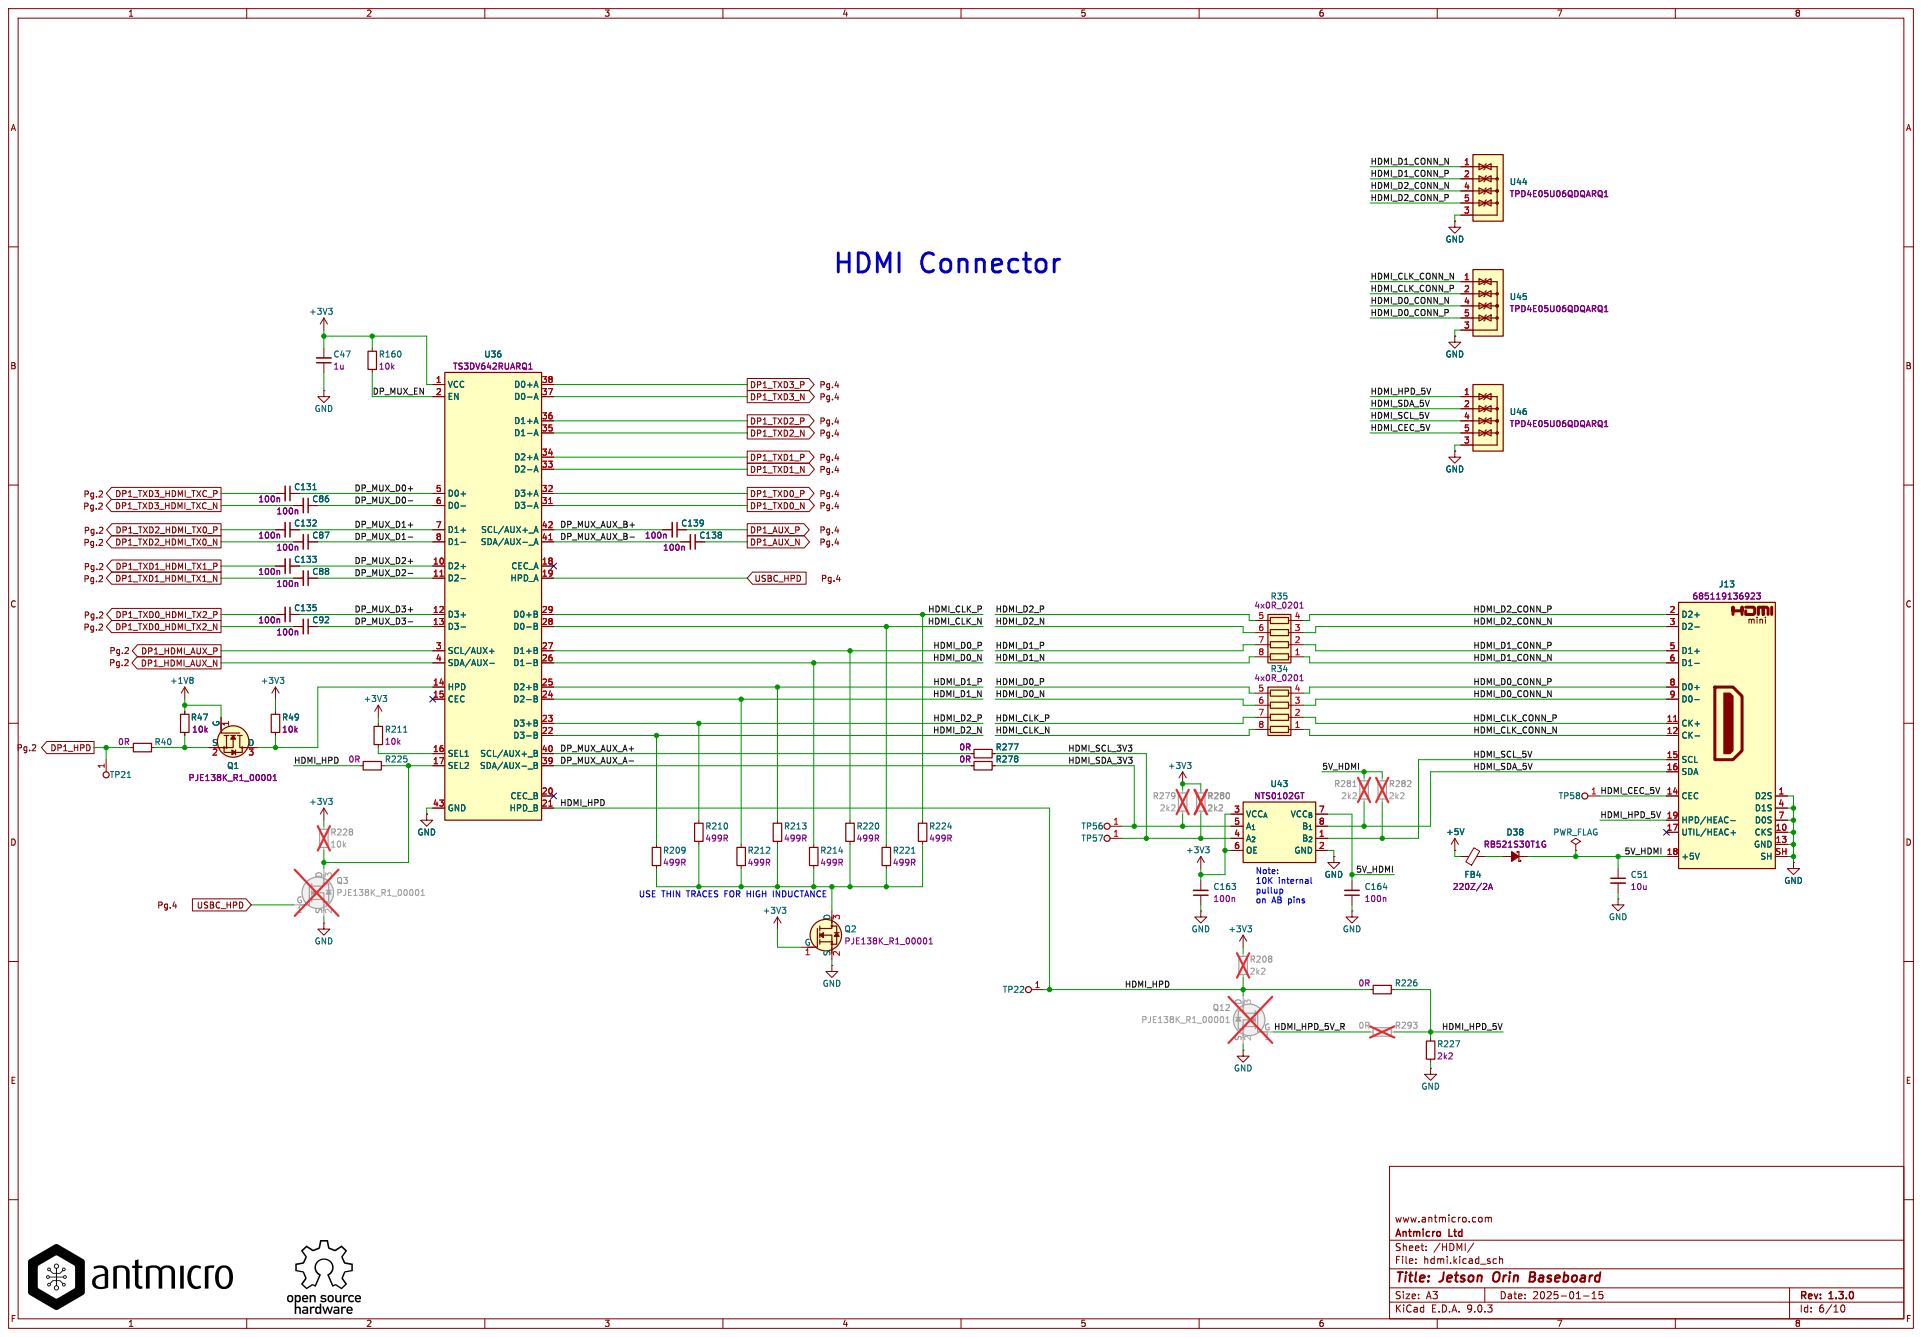
[picture p42: page 6]

on AB pins USE THIN TRACES FOR HIGH INDUCTANCEHDMI Connector

Id: 6/10 Title: Jetson Orin Baseboard

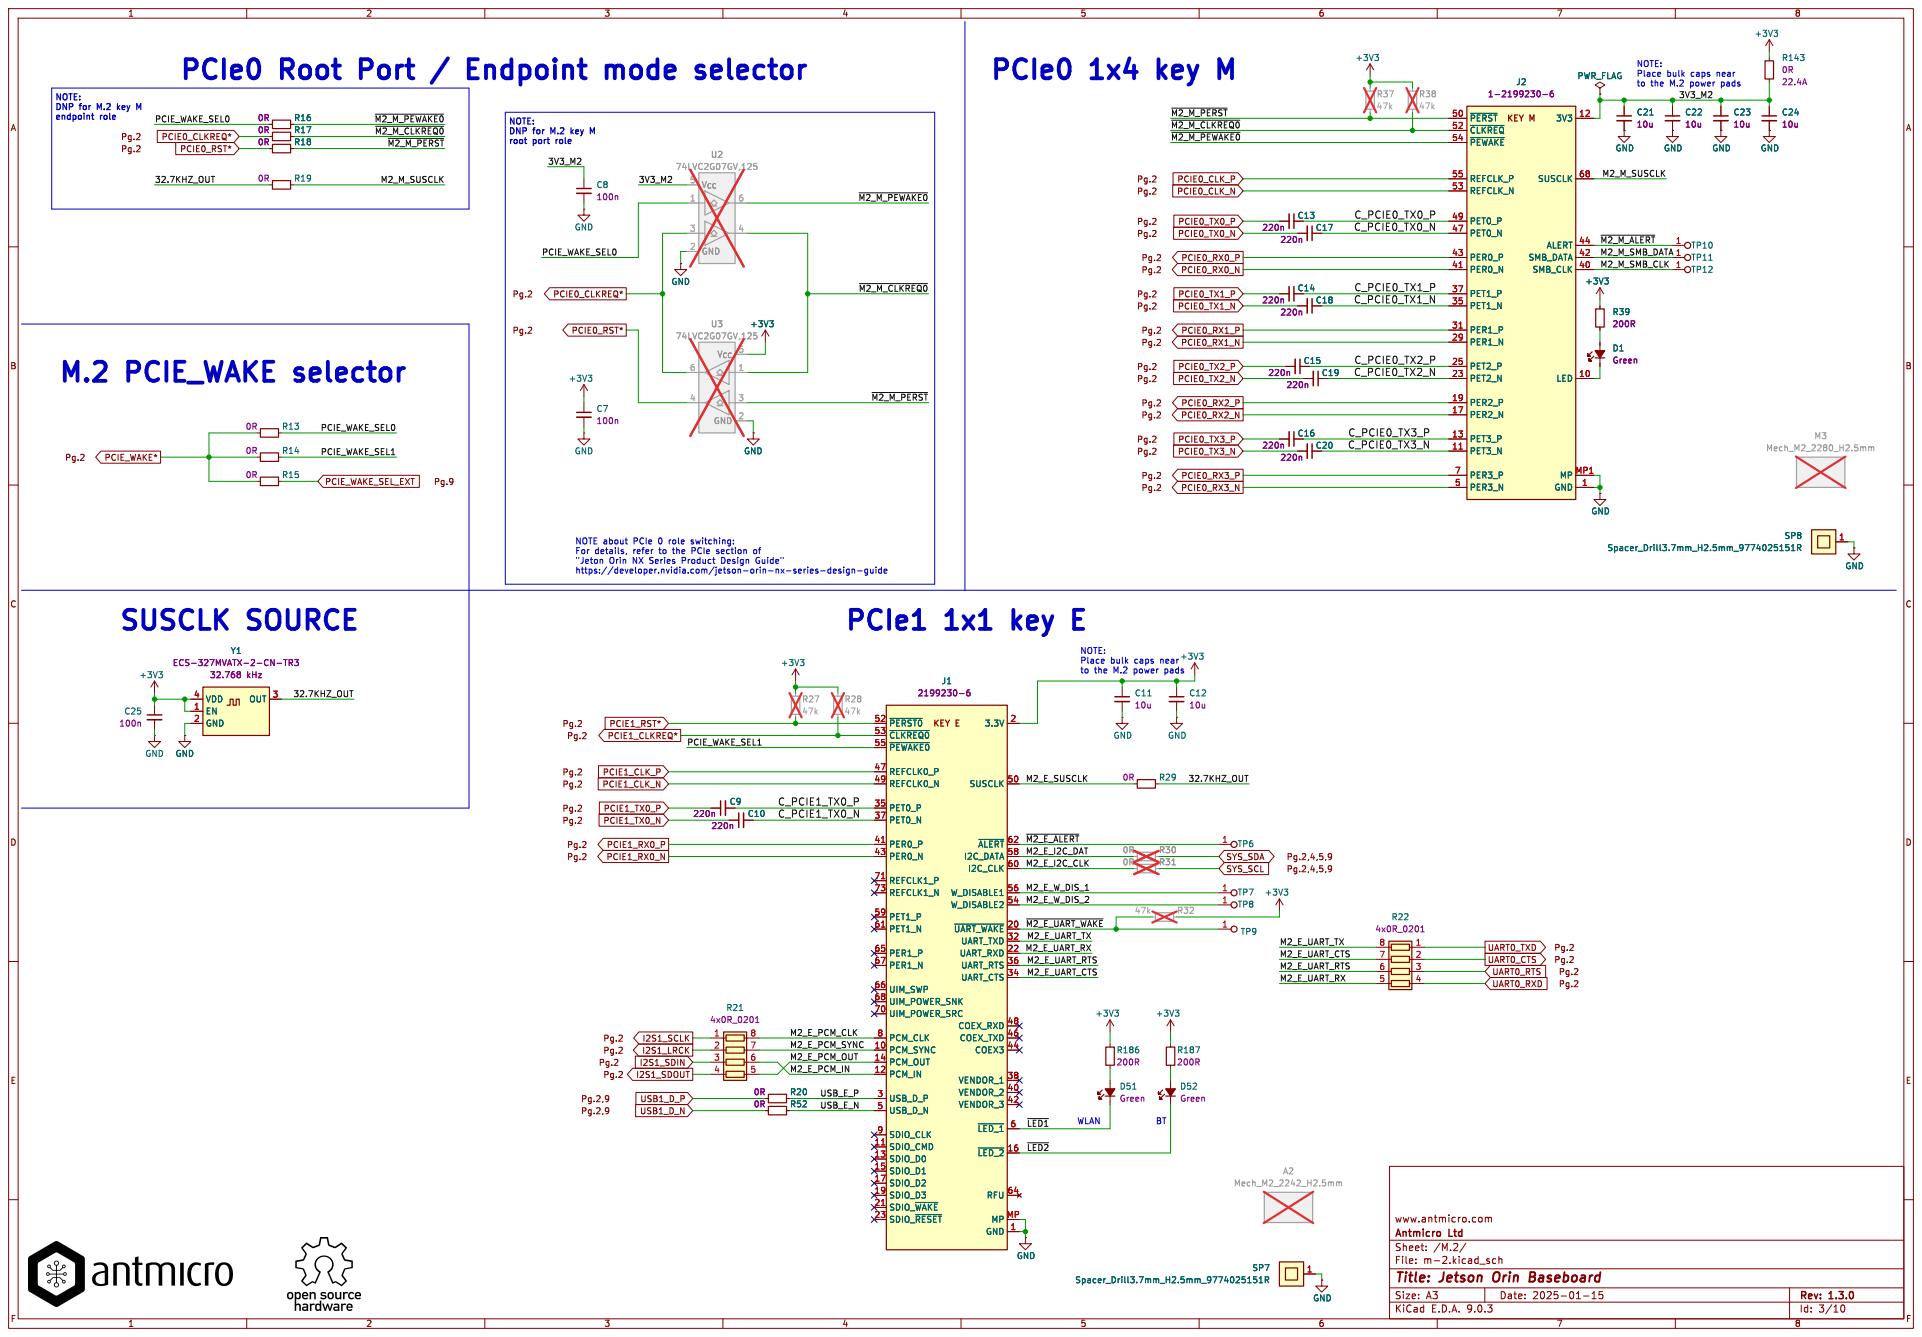
[picture p43: page 7]

NOTE: Place bulk caps near
3V3 12 SUSCLK 68 ALERT 44 SMB_DATA 42 SMB_CLK 40

to the M.2 power pads NOTE: DNP for M.2 key M

NOTE: DNP for M.2 key M

to the M.2 power pads

Id: 3/10 Title: Jetson Orin Baseboard

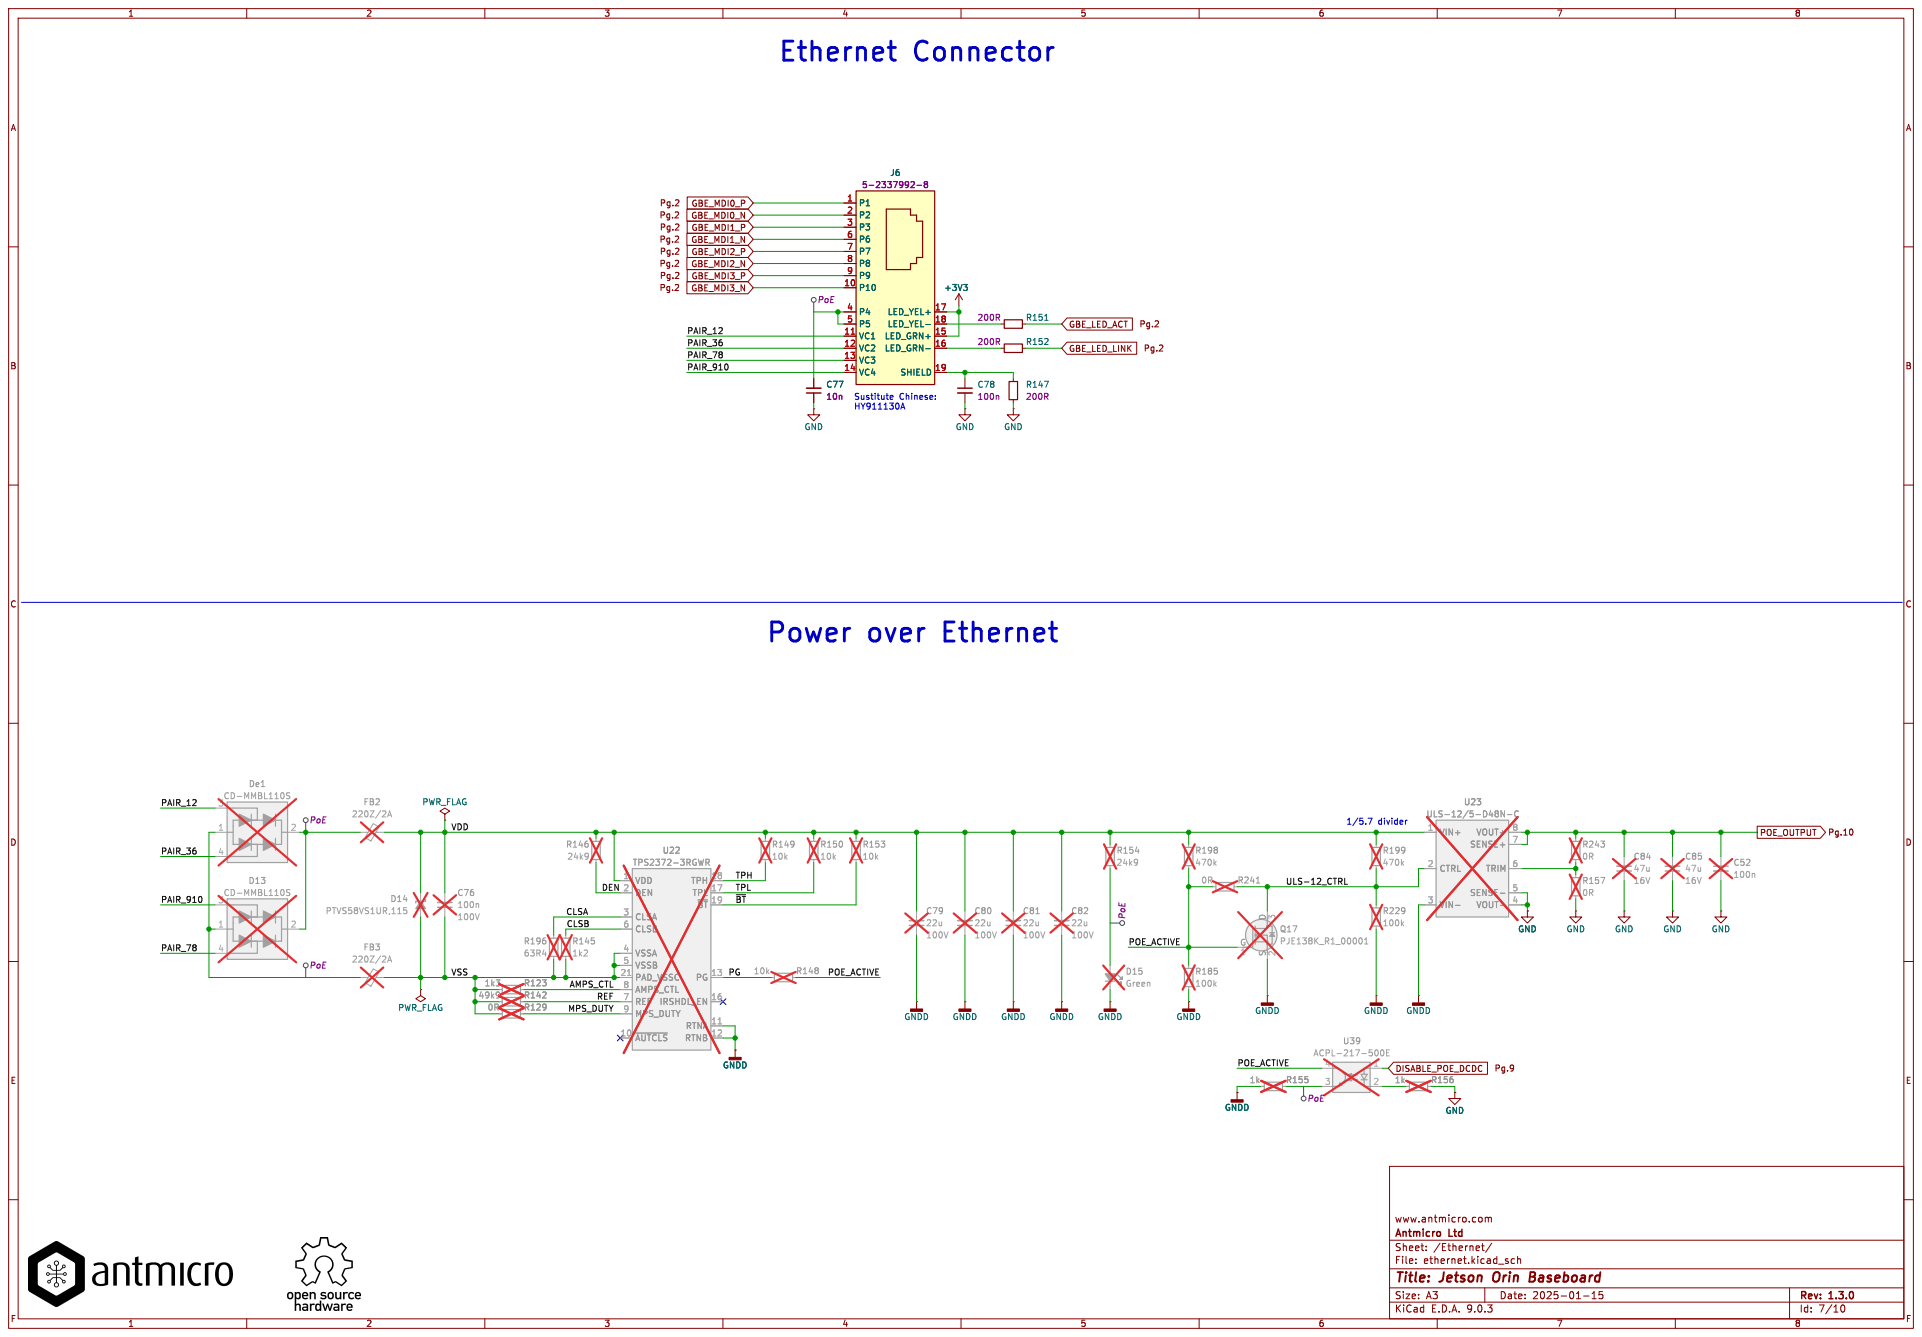
[picture p44: page 8]

Id: 7/10 Title: Jetson Orin Baseboard

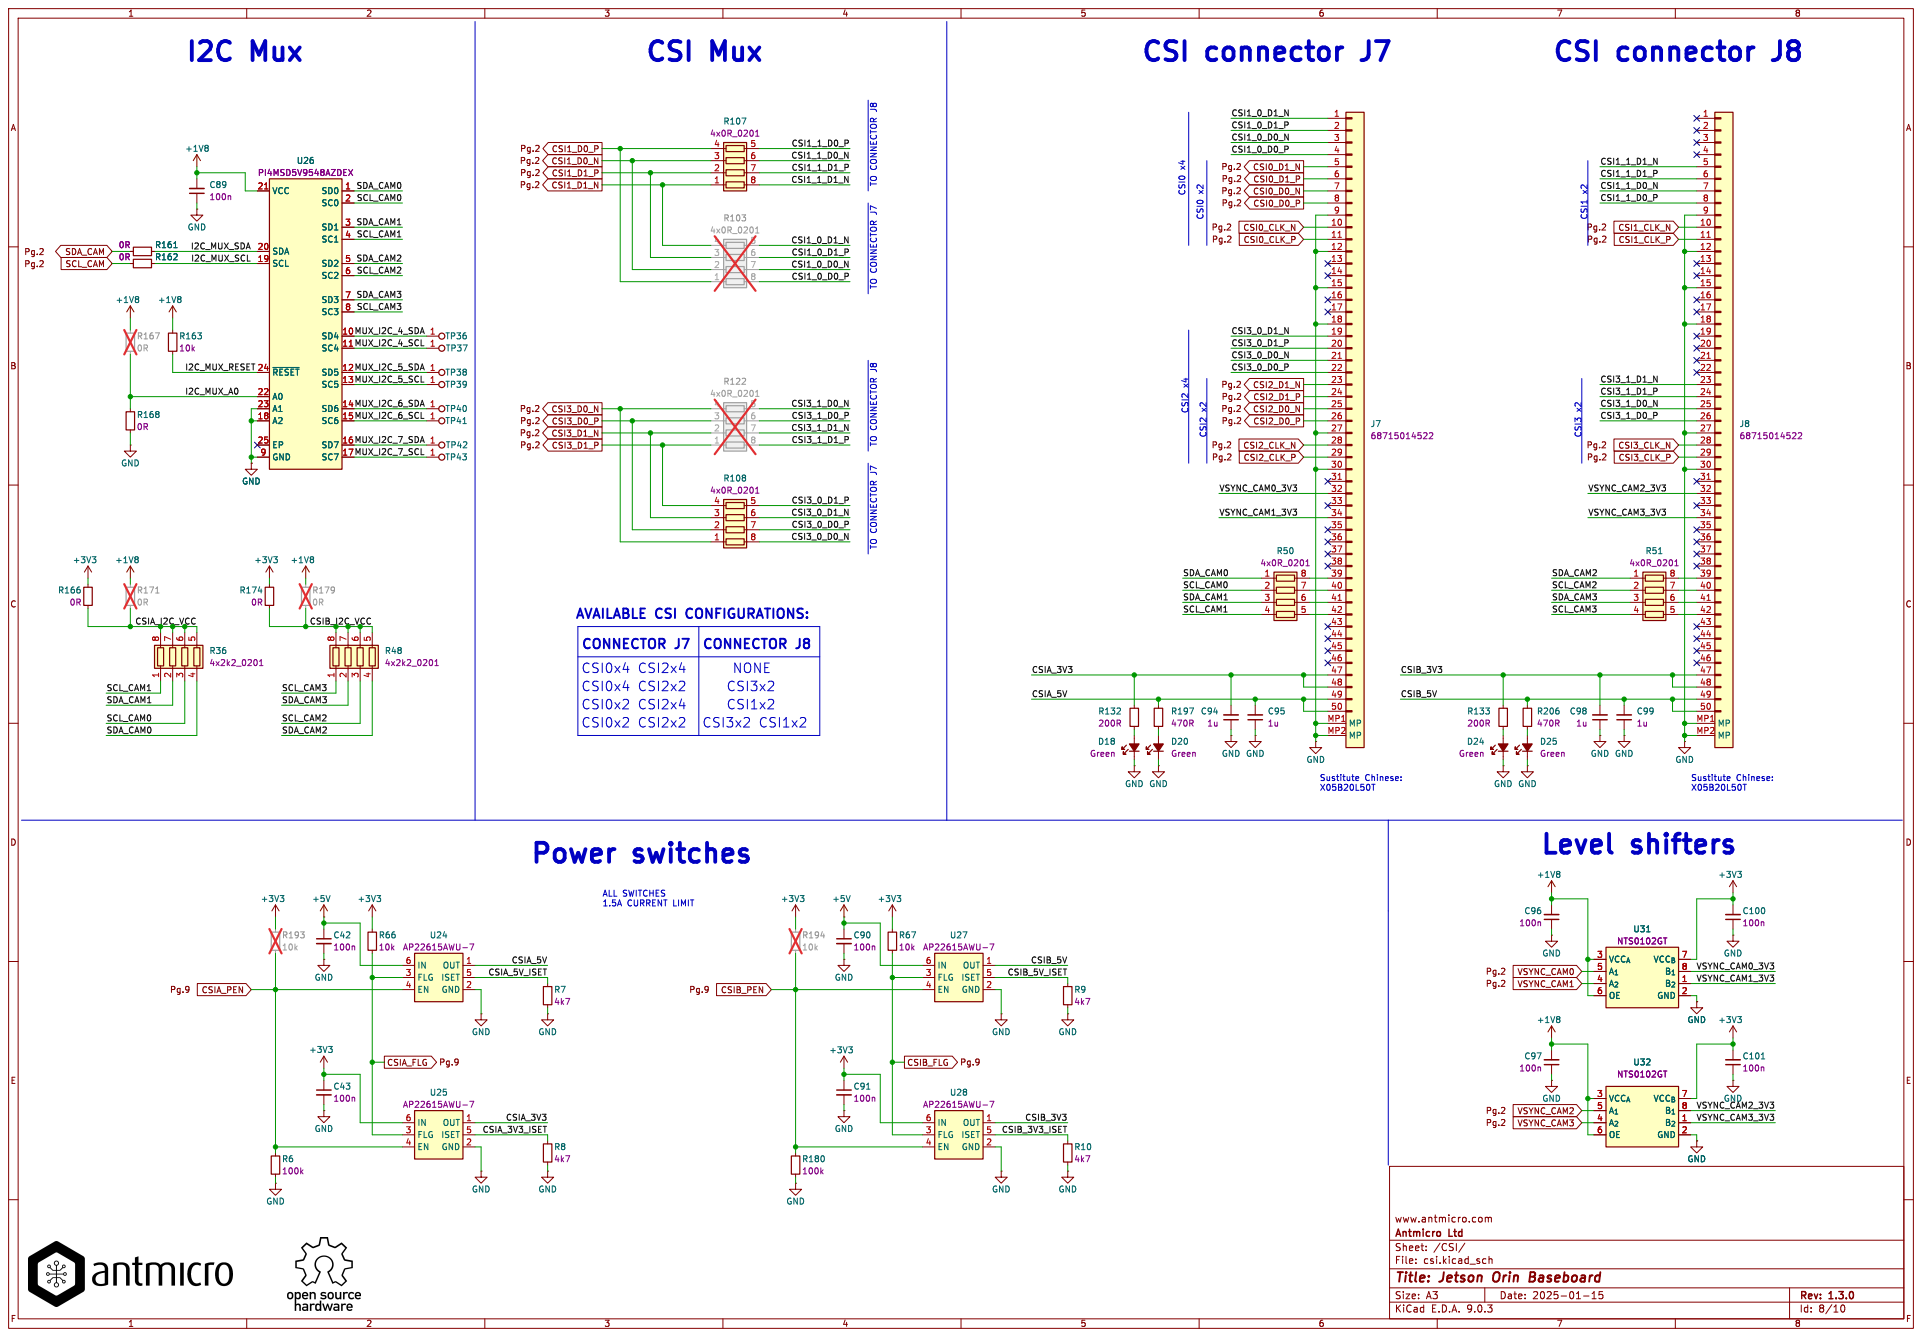
[picture p45: page 9]

Id: 8/10 Title: Jetson Orin Baseboard

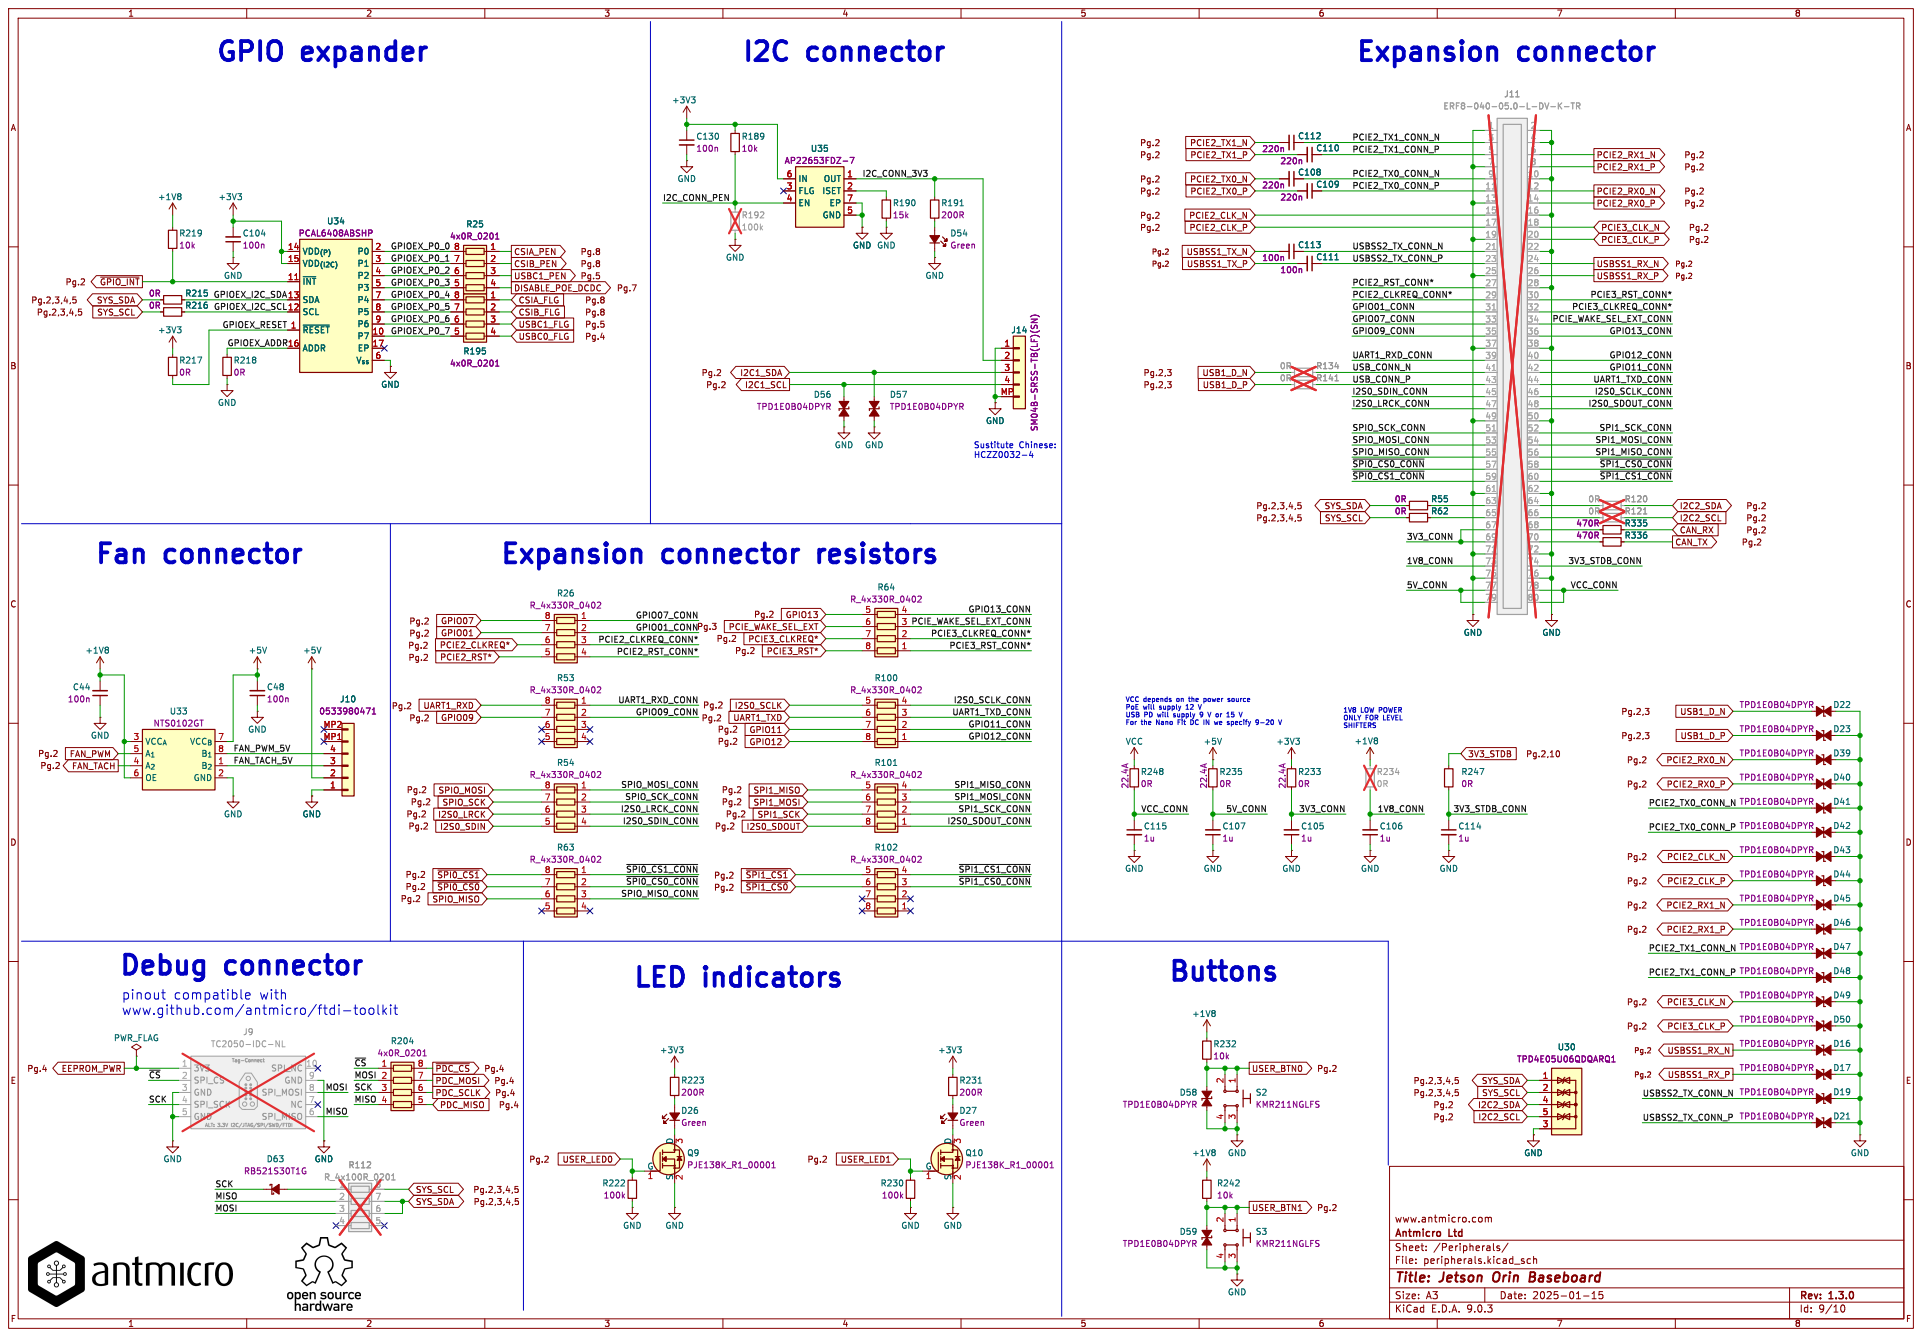
[picture p46: page 10]

J14 SM04B-SRSS-TB(LF)(SN) D57 TPD1E0B04DPYR GND GND GND
GPIOEX_I2C_SCL GPIOEX_RESET GPIOEX_I2C_SDA

VCC depends on the power source PoE will supply 12 V USB PD will supply 9 V or 15 V

1V8 LOW POWER ONLY FOR LEVEL SHIFTERS

www.github.com/antmicro/ftdi-toolkit

Id: 9/10 Title: Jetson Orin Baseboard
