HW-Lab-Hardware-Design-Agency/jetson-orin-baseboard/csi.kicad_sch

## KiCad design csi.kicad_sch (2025-10-24)

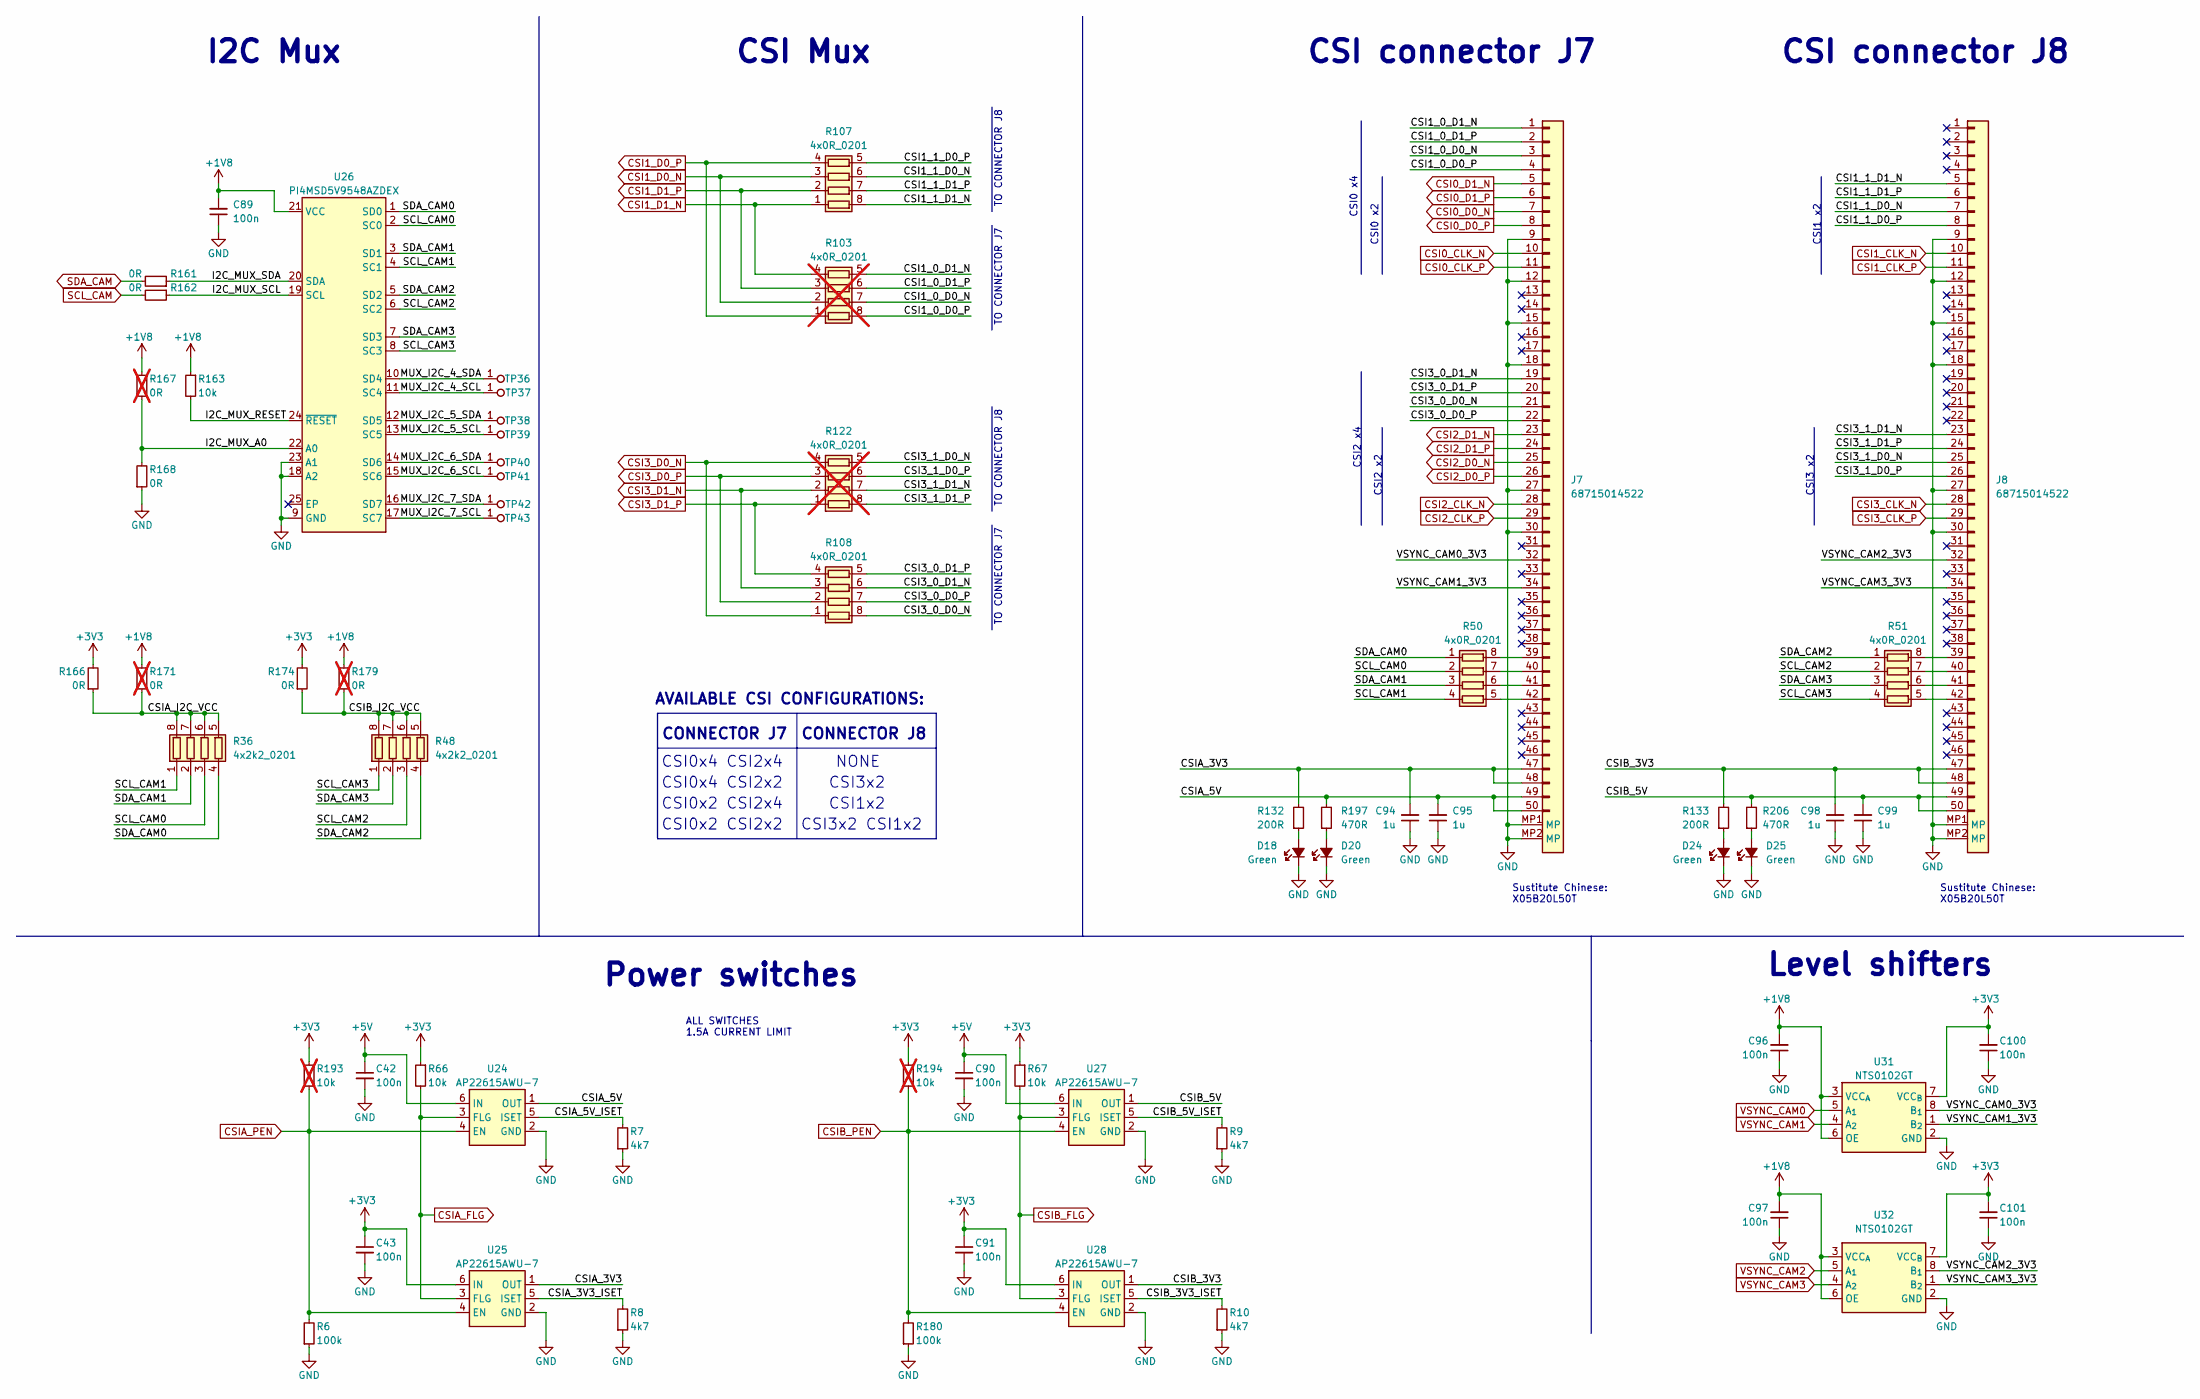
[picture p47: schematic csi.kicad_sch]

Parts:
C42, C43, C89, C90, C91, C96, C97, C100, C101: C_100n_0402; C_0402_1005Metric; Voltage 50V; MPN GRM155R61H104KE14D; LCSC Part # C85960
C94, C95, C98, C99: C_1u_0402; C_0402_1005Metric; MPN C1005X6S1A105K050BC; LCSC Part # C2182694
D18, D20, D24, D25: LED_G_0603_LTST-C190GKT; LED_0603_1608Metric_G; MPN LTST-C190GKT; LCSC Part # C125093
J7, J8: Conn_FFC_WE_68715014522; Conn_FFC_WE_68715014x22; MPN 68715014522; Digikey Part # 732-3522-1-ND
R6, R180: R_100k_0402; R_0402_1005Metric; Tolerance 1%; MPN CR0402-FX-1003GLF; LCSC Part # C2077080
R7, R8, R9, R10: R_4k7_0402; R_0402_1005Metric; Tolerance 1%; MPN CR0402-FX-4701GLF; LCSC Part # C2076851
R36, R48: R_4x2k2_0201_array; R_Array_4x0201_Panasonic_EXB18V; MPN EXB-18V222JX; LCSC Part # C5700382
R50, R51, R107, R108: R_4x0R_0201_array; R_Array_4x0201_Panasonic_EXB18V; MPN EXB-18VR000X; LCSC Part # C1731295
R66, R67, R163: R_10k_0402; R_0402_1005Metric; Tolerance 1%; MPN CR0402-FX-1002GLF; LCSC Part # C202396
R103, R122: R_4x0R_0201_array; R_Array_4x0201_Panasonic_EXB18V; MPN EXB-18VR000X; LCSC Part # C1731295; not fitted
R132, R133: R_200R_0402; R_0402_1005Metric; Tolerance 1%; MPN CR0402-FX-2000GLF; LCSC Part # C19946422
R161, R162, R166, R168, R174: R_0R_0402; R_0402_1005Metric; MPN ERJ2GE0R00X; LCSC Part # C242160
R167, R171, R179: R_0R_0402; R_0402_1005Metric; MPN ERJ2GE0R00X; LCSC Part # C242160; not fitted
R193, R194: R_10k_0402; R_0402_1005Metric; Tolerance 1%; MPN CR0402-FX-1002GLF; LCSC Part # C202396; not fitted
R197, R206: R_470R_0402; R_0402_1005Metric; Tolerance 1%; MPN CR0402-FX-4700GLF; LCSC Part # C2077077
TP36, TP37, TP38, TP39, TP40, TP41, TP42, TP43: TP_0.75mm_SMD; TP_SMD_0.75mm
U24, U25, U27, U28: AP22615A_TSOT26; TSOT23-6; MPN AP22615AWU-7; LCSC Part # C2680357
U26: PI4MSD5V9548AZDEX; VQFN-24-1EP_3.8x3.8x1.0mm_P0.5mm; MPN PI4MSD5V9548AZDEX; LCSC Part # C2674581
U31, U32: NTS0102_XSON; XSON-8_1x1.95mm_P0.5mm; MPN NTS0102GT; LCSC Part # C2687851

Connections:
+1V8: C89.2, C96.2, C97.2, R163.1, R167.2, R171.2, R179.2, U26.21 (VCC), U31.3 (VCC_{A}), U31.6 (OE), U32.3 (VCC_{A}), U32.6 (OE)
+3V3: C43.1, C91.1, C100.2, C101.2, R66.1, R67.1, R166.2, R174.2, R193.2, R194.2, U25.6 (IN), U28.6 (IN), U31.7 (VCC_{B}), U32.7 (VCC_{B})
+5V: C42.1, C90.1, U24.6 (IN), U27.6 (IN)
CSI0_CLK_N: J7.10
CSI0_CLK_P: J7.11
CSI0_D0_N: J7.7
CSI0_D0_P: J7.8
CSI0_D1_N: J7.5
CSI0_D1_P: J7.6
CSI1_0_D0_N: J7.3, R103.7 (R2.2)
CSI1_0_D0_P: J7.4, R103.8 (R1.2)
CSI1_0_D1_N: J7.1, R103.5 (R4.2)
CSI1_0_D1_P: J7.2, R103.6 (R3.2)
CSI1_1_D0_N: J8.7, R107.6 (R3.2)
CSI1_1_D0_P: J8.8, R107.5 (R4.2)
CSI1_1_D1_N: J8.5, R107.8 (R1.2)
CSI1_1_D1_P: J8.6, R107.7 (R2.2)
CSI1_CLK_N: J8.10
CSI1_CLK_P: J8.11
CSI1_D0_N: R103.2 (R2.1), R107.3 (R3.1)
CSI1_D0_P: R103.1 (R1.1), R107.4 (R4.1)
CSI1_D1_N: R103.4 (R4.1), R107.1 (R1.1)
CSI1_D1_P: R103.3 (R3.1), R107.2 (R2.1)
CSI2_CLK_N: J7.28
CSI2_CLK_P: J7.29
CSI2_D0_N: J7.25
CSI2_D0_P: J7.26
CSI2_D1_N: J7.23
CSI2_D1_P: J7.24
CSI3_0_D0_N: J7.21, R108.8 (R1.2)
CSI3_0_D0_P: J7.22, R108.7 (R2.2)
CSI3_0_D1_N: J7.19, R108.6 (R3.2)
CSI3_0_D1_P: J7.20, R108.5 (R4.2)
CSI3_1_D0_N: J8.25, R122.5 (R4.2)
CSI3_1_D0_P: J8.26, R122.6 (R3.2)
CSI3_1_D1_N: J8.23, R122.7 (R2.2)
CSI3_1_D1_P: J8.24, R122.8 (R1.2)
CSI3_CLK_N: J8.28
CSI3_CLK_P: J8.29
CSI3_D0_N: R108.1 (R1.1), R122.4 (R4.1)
CSI3_D0_P: R108.2 (R2.1), R122.3 (R3.1)
CSI3_D1_N: R108.3 (R3.1), R122.2 (R2.1)
CSI3_D1_P: R108.4 (R4.1), R122.1 (R1.1)
CSIA_3V3: C94.2, J7.47, J7.48, R132.2, U25.1 (OUT)
CSIA_3V3_ISET: R8.2, U25.5 (ISET)
CSIA_5V: C95.2, J7.49, J7.50, R197.2, U24.1 (OUT)
CSIA_5V_ISET: R7.2, U24.5 (ISET)
CSIA_FLG: R66.2, U24.3 (FLG), U25.3 (FLG)
CSIA_I2C_VCC: R36.5 (R4.2), R36.6 (R3.2), R36.7 (R2.2), R36.8 (R1.2), R166.1, R171.1
CSIA_PEN: R6.2, R193.1, U24.4 (EN), U25.4 (EN)
CSIB_3V3: C98.2, J8.47, J8.48, R133.2, U28.1 (OUT)
CSIB_3V3_ISET: R10.2, U28.5 (ISET)
CSIB_5V: C99.2, J8.49, J8.50, R206.2, U27.1 (OUT)
CSIB_5V_ISET: R9.2, U27.5 (ISET)
CSIB_FLG: R67.2, U27.3 (FLG), U28.3 (FLG)
CSIB_I2C_VCC: R48.5 (R4.2), R48.6 (R3.2), R48.7 (R2.2), R48.8 (R1.2), R174.1, R179.1
CSIB_PEN: R180.2, R194.1, U27.4 (EN), U28.4 (EN)
GND: C42.2, C43.2, C89.1, C90.2, C91.2, C94.1, C95.1, C96.1, C97.1, C98.1, C99.1, C100.1, C101.1, D18.1 (C), D20.1 (C), D24.1 (C), D25.1 (C), J7.9, J7.12, J7.15, J7.18, J7.27, J7.30, J7.MP1 (MP), J7.MP2 (MP), J8.9, J8.12, J8.15, J8.18, J8.27, J8.30, J8.MP1 (MP), J8.MP2 (MP), R6.1, R7.1, R8.1, R9.1, R10.1, R168.1, R180.1, U24.2 (GND), U25.2 (GND), U26.9 (GND), U26.18 (A2), U26.23 (A1), U27.2 (GND), U28.2 (GND), U31.2 (GND), U32.2 (GND)
I2C_MUX_A0: R167.1, R168.2, U26.22 (A0)
I2C_MUX_RESET: R163.2, U26.24 (~RESET)
I2C_MUX_SCL: R162.1, U26.19 (SCL)
I2C_MUX_SDA: R161.1, U26.20 (SDA)
MUX_I2C_4_SCL: TP37.1, U26.11 (SC4)
MUX_I2C_4_SDA: TP36.1, U26.10 (SD4)
MUX_I2C_5_SCL: TP39.1, U26.13 (SC5)
MUX_I2C_5_SDA: TP38.1, U26.12 (SD5)
MUX_I2C_6_SCL: TP41.1, U26.15 (SC6)
MUX_I2C_6_SDA: TP40.1, U26.14 (SD6)
MUX_I2C_7_SCL: TP43.1, U26.17 (SC7)
MUX_I2C_7_SDA: TP42.1, U26.16 (SD7)
unnamed: D18.2 (A), R132.1
unnamed: D20.2 (A), R197.1
unnamed: D24.2 (A), R133.1
unnamed: D25.2 (A), R206.1
unnamed: J7.39, R50.8 (R1.2)
unnamed: J7.40, R50.7 (R2.2)
unnamed: J7.41, R50.6 (R3.2)
unnamed: J7.42, R50.5 (R4.2)
unnamed: J8.39, R51.8 (R1.2)
unnamed: J8.40, R51.7 (R2.2)
unnamed: J8.41, R51.6 (R3.2)
unnamed: J8.42, R51.5 (R4.2)
SCL_CAM: R162.2
SCL_CAM0: R36.3 (R3.1), R50.2 (R2.1), U26.2 (SC0)
SCL_CAM1: R36.1 (R1.1), R50.4 (R4.1), U26.4 (SC1)
SCL_CAM2: R48.3 (R3.1), R51.2 (R2.1), U26.6 (SC2)
SCL_CAM3: R48.1 (R1.1), R51.4 (R4.1), U26.8 (SC3)
SDA_CAM: R161.2
SDA_CAM0: R36.4 (R4.1), R50.1 (R1.1), U26.1 (SD0)
SDA_CAM1: R36.2 (R2.1), R50.3 (R3.1), U26.3 (SD1)
SDA_CAM2: R48.4 (R4.1), R51.1 (R1.1), U26.5 (SD2)
SDA_CAM3: R48.2 (R2.1), R51.3 (R3.1), U26.7 (SD3)
VSYNC_CAM0: U31.5 (A_{1})
VSYNC_CAM0_3V3: J7.32, U31.8 (B_{1})
VSYNC_CAM1: U31.4 (A_{2})
VSYNC_CAM1_3V3: J7.34, U31.1 (B_{2})
VSYNC_CAM2: U32.5 (A_{1})
VSYNC_CAM2_3V3: J8.32, U32.8 (B_{1})
VSYNC_CAM3: U32.4 (A_{2})
VSYNC_CAM3_3V3: J8.34, U32.1 (B_{2})

Notes on the sheet:
CONNECTOR J8
CSI2 x2
CSI0x2 CSI2x2
Sustitute Chinese: X05B20L50T
CONNECTOR J7
CSI1x2
NONE
CSI3x2
TO CONNECTOR J7
CSI3x2 CSI1x2
CSI0 x2
CSI3 x2
TO CONNECTOR J8
CSI0x4 CSI2x2
Power switches
CSI2 x4
CSI0x4 CSI2x4
CSI1 x2
AVAILABLE CSI CONFIGURATIONS:
CSI Mux
CSI connector J7
CSI0x2 CSI2x4
CSI0 x4
I2C Mux
CSI connector J8
ALL SWITCHES 1.5A CURRENT LIMIT
Level shifters
