HW-Lab-Hardware-Design-Agency/jetson-orin-baseboard/ethernet.kicad_sch

## KiCad design ethernet.kicad_sch (2025-10-24)

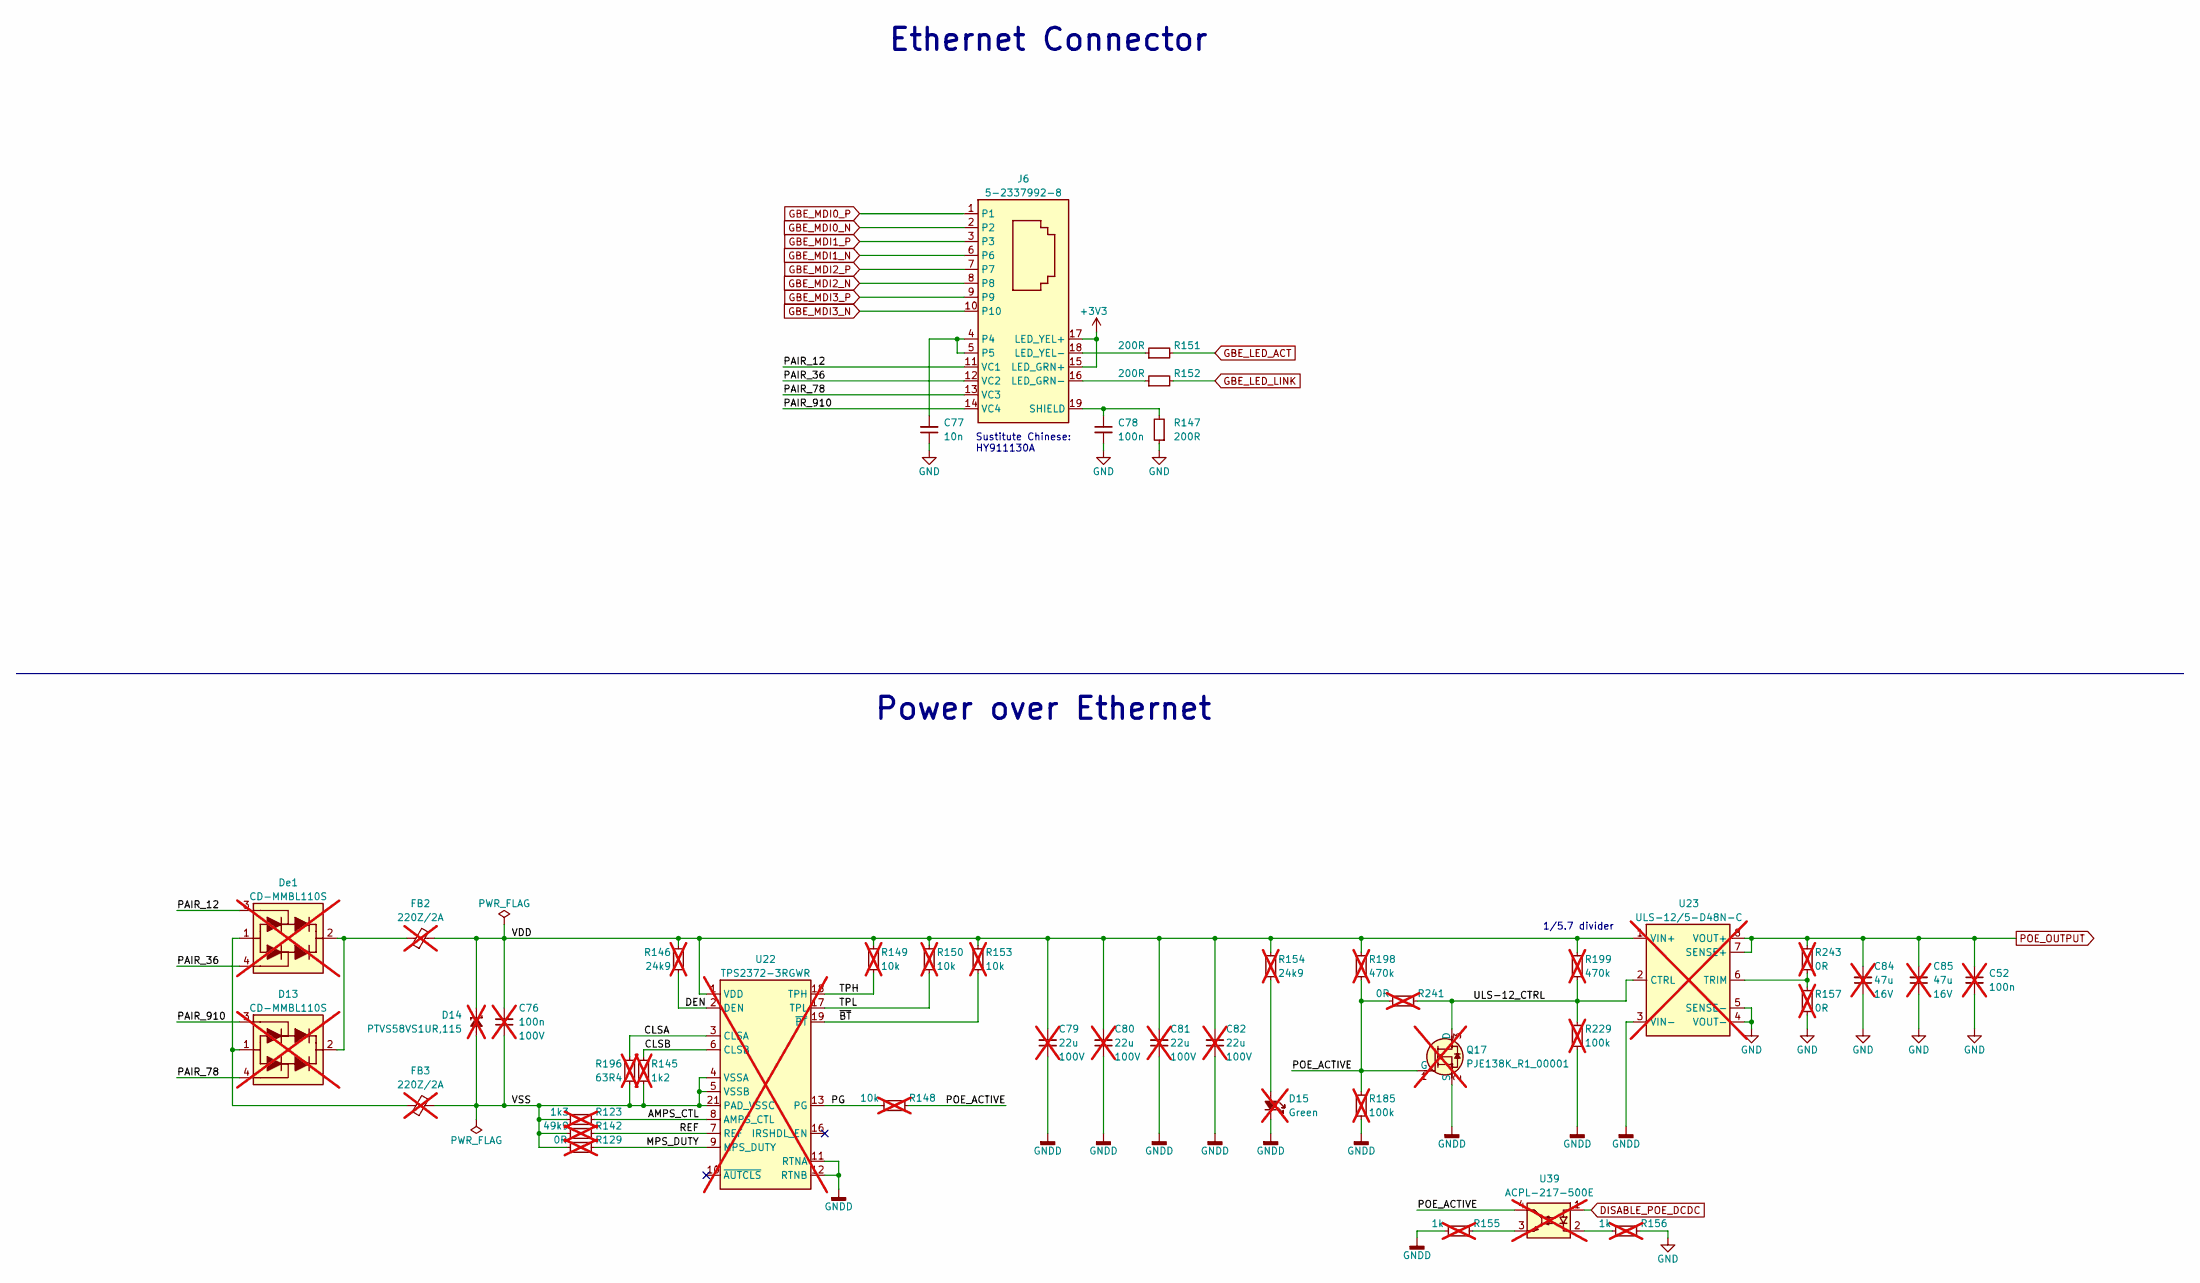
[picture p48: schematic ethernet.kicad_sch]

Parts:
C52: C_100n_0402; C_0402_1005Metric; Voltage 50V; MPN GRM155R61H104KE14D; LCSC Part # C85960; not fitted
C76: C_100n_100V_0805; C_0805_2012Metric; Voltage 100V; MPN CL21B104KCFNNNE; LCSC Part # C28233; not fitted
C77: C_10n_0603; C_0603_1608Metric; MPN 06031C103JAT2A; LCSC Part # C597086
C78: C_100n_0402; C_0402_1005Metric; Voltage 50V; MPN GRM155R61H104KE14D; LCSC Part # C85960
C79, C80, C81, C82: C_22u_100V_2220; C_2220_5650Metric; Voltage 100V; MPN C5750X7S2A226M280KB; LCSC Part # C529057; not fitted
C84, C85: C_47u_16V_1206; C_1206_3216Metric; Voltage 16V; MPN C3216X5R1C476M160AB; LCSC Part # C2167809; not fitted
D13: CD-MMBL110S; DFN3538; MPN CD-MMBL110S; LCSC Part # C3151657; not fitted
D14: PTVS58VS1UR,115; D_SOD-123F; MPN PTVS58VS1UR,115; LCSC Part # C272849; not fitted
D15: LED_G_0603_LTST-C190GKT; LED_0603_1608Metric_G; MPN LTST-C190GKT; LCSC Part # C125093; not fitted
De1: CD-MMBL110S; DFN3538; MPN CD-MMBL110S; LCSC Part # C3151657; not fitted
FB2, FB3: FB_220Z_2A_Murata-BLM21PG_0805; FB_0805_2012Metric; MPN BLM21PG221SN1D; LCSC Part # C85840; not fitted
J6: Bus_RJ45_5-2337992-8; RJ45_X-2337992-8_Horizontal; MPN 5-2337992-8; LCSC Part # C6393472
Q17: PJE138K; SOT-523; MPN PJE138K_R1_00001; LCSC Part # C391643; not fitted
R123: R_1k3_0402; R_0402_1005Metric; Tolerance 1%; MPN CR0402-FX-1301GLF; Digikey Part # CR0402-FX-1301GLFCT-ND; not fitted
R129, R241: R_0R_0402; R_0402_1005Metric; MPN ERJ2GE0R00X; LCSC Part # C242160; not fitted
R142: R_49k9_0402; R_0402_1005Metric; Tolerance 1%; MPN CR0402-FX-4992GLF; LCSC Part # C2076619; not fitted
R145: R_1k2_0402; R_0402_1005Metric; Tolerance 1%; MPN CR0402-FX-1201GLF; LCSC Part # C2089885; not fitted
R146, R154: R_24k9_0402; R_0402_1005Metric; Tolerance 1%; MPN CR0402-FX-2492GLF; Digikey Part # CR0402-FX-2492GLFCT-ND; not fitted
R147, R151, R152: R_200R_0402; R_0402_1005Metric; Tolerance 1%; MPN CR0402-FX-2000GLF; LCSC Part # C19946422
R148, R149, R150, R153: R_10k_0402; R_0402_1005Metric; Tolerance 1%; MPN CR0402-FX-1002GLF; LCSC Part # C202396; not fitted
R155, R156: R_1k_0402; R_0402_1005Metric; Tolerance 1%; MPN CR0402-FX-1001GLF; LCSC Part # C202394; not fitted
R157, R243: R_0R_0603; R_0603_1608Metric; MPN CR0603-J/-000ELF; LCSC Part # C512908; not fitted
R185, R229: R_100k_0402; R_0402_1005Metric; Tolerance 1%; MPN CR0402-FX-1003GLF; LCSC Part # C2077080; not fitted
R196: R_63R4_0603; R_0603_1608Metric; Tolerance 1%; MPN CR0603-FX-63R4ELF; Digikey Part # 118-CR0603-FX-63R4ELFCT-ND; not fitted
R198, R199: R_470k_0402; R_0402_1005Metric; Tolerance 1%; MPN CR0402-FX-4703GLF; LCSC Part # C2085488; not fitted
U22: TPS2372-3RGWR; VQFN-20_5x5x1mm_P0.65mm; MPN TPS2372-3RGWR; LCSC Part # C2876734; not fitted
U23: ULS-12_5-D48N-C; Conv_Murata_ULS-60W; MPN ULS-12/5-D48N-C; LCSC Part # C7136871; not fitted
U39: ACPL-217-500E; SOIC-4_4.55x2.6mm_P1.27mm; MPN ACPL-217-500E; LCSC Part # C2939626; not fitted

Connections:
+3V3: J6.15 (LED_GRN+), J6.17 (LED_YEL+)
AMPS_CTL: R123.2, U22.8 (AMPS_CTL)
CLSA: R196.2, U22.3 (CLSA)
CLSB: R145.2, U22.6 (CLSB)
DEN: R146.1, U22.2 (DEN)
DISABLE_POE_DCDC: U39.1
GBE_LED_ACT: R151.2
GBE_LED_LINK: R152.2
GBE_MDI0_N: J6.2
GBE_MDI0_P: J6.1
GBE_MDI1_N: J6.6
GBE_MDI1_P: J6.3
GBE_MDI2_N: J6.8
GBE_MDI2_P: J6.7
GBE_MDI3_N: J6.10
GBE_MDI3_P: J6.9
GND: C52.2, C77.1, C78.2, C84.1, C85.1, R147.1, R156.2, R157.1, U23.4 (VOUT-), U23.5 (SENSE-)
GNDD: C79.1, C80.1, C81.1, C82.1, D15.1 (C), Q17.2 (S), R155.1, R185.1, R229.1, U22.11 (RTNA), U22.12 (RTNB), U23.3 (VIN-)
MPS_DUTY: R129.1, U22.9 (MPS_DUTY)
unnamed: C77.2, J6.4, J6.5
unnamed: C78.1, J6.19 (SHIELD), J6.20 (SHIELD), R147.2
unnamed: D13.1, De1.1, FB3.1
unnamed: D13.2, De1.2, FB2.1
unnamed: D15.2 (A), R154.1
unnamed: J6.16 (LED_GRN-), R152.1
unnamed: J6.18 (LED_YEL-), R151.1
unnamed: R155.2, U39.3
unnamed: R156.1, U39.2
unnamed: R157.2, R243.2, U23.6 (TRIM)
PAIR_12: De1.3, J6.11 (VC1)
PAIR_36: De1.4, J6.12 (VC2)
PAIR_78: D13.4, J6.13 (VC3)
PAIR_910: D13.3, J6.14 (VC4)
PG: R148.2, U22.13 (PG)
POE_ACTIVE: Q17.1 (G), R148.1, R185.2, R198.1, R241.2, U39.4
POE_OUTPUT: C52.1, C84.2, C85.2, R243.1, U23.7 (SENSE+), U23.8 (VOUT+)
REF: R142.2, U22.7 (REF)
TPH: R149.1, U22.18 (TPH)
TPL: R150.1, U22.17 (TPL)
ULS-12_CTRL: Q17.3 (D), R199.1, R229.2, R241.1, U23.2 (CTRL)
VDD: C76.2, C79.2, C80.2, C81.2, C82.2, D14.1 (C), FB2.2, R146.2, R149.2, R150.2, R153.2, R154.2, R198.2, R199.2, U22.1 (VDD), U23.1 (VIN+)
VSS: C76.1, D14.2 (A), FB3.2, R123.1, R129.2, R142.1, R145.1, R196.1, U22.4 (VSSA), U22.5 (VSSB), U22.21 (PAD_VSSC)
~BT: R153.1, U22.19 (~BT)

Notes on the sheet:
Power over Ethernet
Sustitute Chinese: HY911130A
Ethernet Connector
1/5.7 divider
