HW-Lab-Hardware-Design-Agency/jetson-orin-baseboard/hdmi.kicad_sch

## KiCad design hdmi.kicad_sch (2025-10-24)

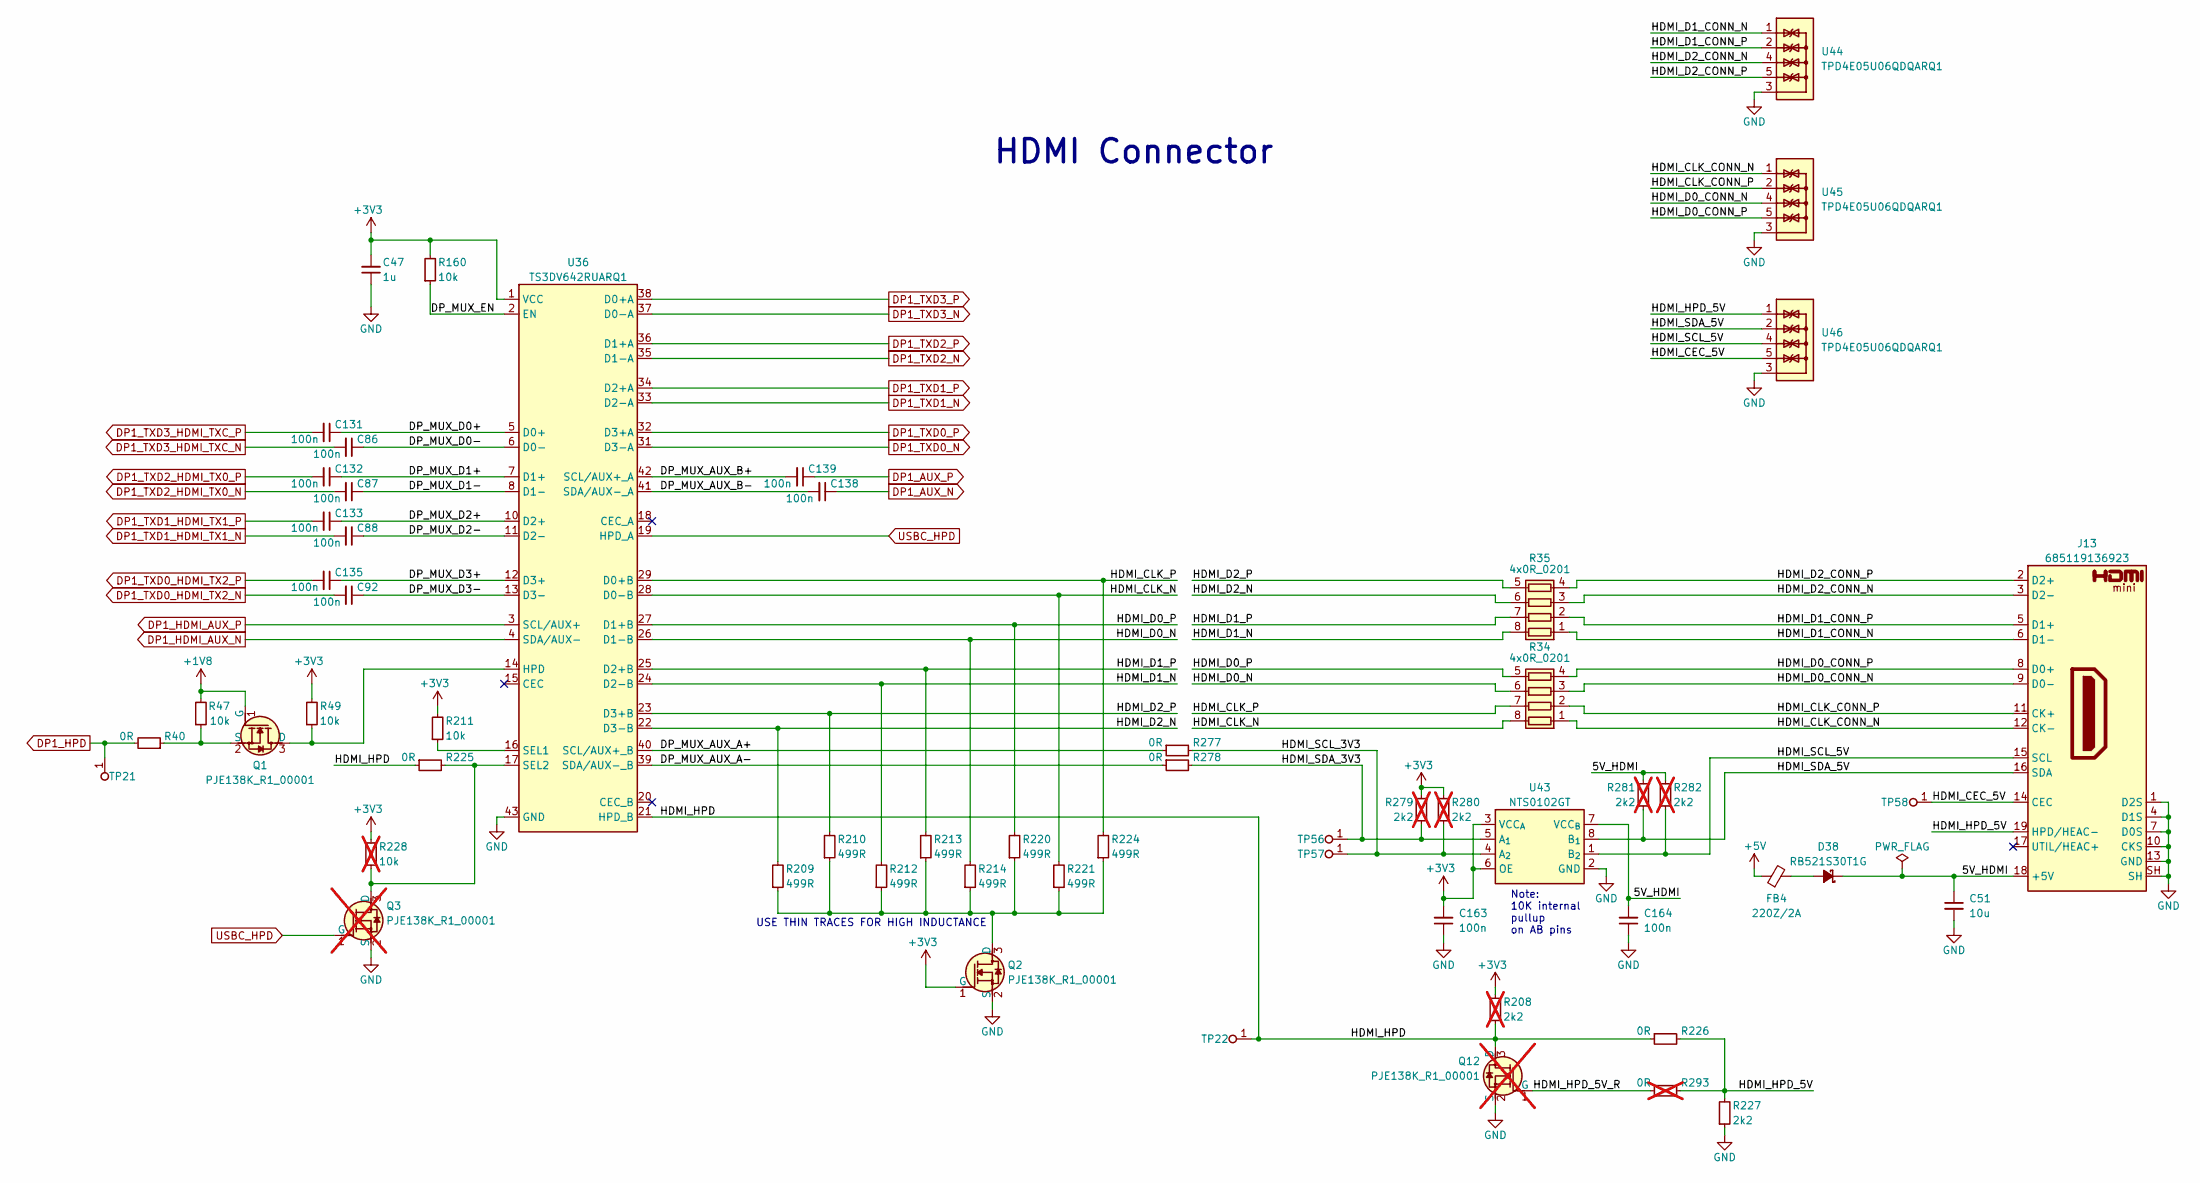
[picture p49: schematic hdmi.kicad_sch]

Parts:
C47: C_1u_0402; C_0402_1005Metric; MPN C1005X6S1A105K050BC; LCSC Part # C2182694
C51: C_10u_0603; C_0603_1608Metric; MPN GRM188R61A106KE69D; LCSC Part # C77044
C86, C87, C88, C92, C131, C132, C133, C135, C138, C139, C163, C164: C_100n_0402; C_0402_1005Metric; Voltage 50V; MPN GRM155R61H104KE14D; LCSC Part # C85960
D38: RB521S30T1G; SOD-523; MPN RB521S30T1G; LCSC Part # C145179
FB4: FB_220Z_2A_Murata-BLM21PG_0805; FB_0805_2012Metric; MPN BLM21PG221SN1D; LCSC Part # C85840
J13: HDMI-Mini-C_WE_685119136923; HDMI-Mini-C_Receptacle_WE_685119136923; MPN 685119136923; Digikey Part # 732-2739-1-ND
Q1, Q2: PJE138K; SOT-523; MPN PJE138K_R1_00001; LCSC Part # C391643
Q3, Q12: PJE138K; SOT-523; MPN PJE138K_R1_00001; LCSC Part # C391643; not fitted
R34, R35: R_4x0R_0201_array; R_Array_4x0201_Panasonic_EXB18V; MPN EXB-18VR000X; LCSC Part # C1731295
R40, R225, R226, R277, R278: R_0R_0402; R_0402_1005Metric; MPN ERJ2GE0R00X; LCSC Part # C242160
R47, R49, R160, R211: R_10k_0402; R_0402_1005Metric; Tolerance 1%; MPN CR0402-FX-1002GLF; LCSC Part # C202396
R208, R279, R280, R281, R282: R_2k2_0402; R_0402_1005Metric; Tolerance 1%; MPN CR0402-FX-2201GLF; LCSC Part # C2076845; not fitted
R209, R210, R212, R213, R214, R220, R221, R224: R_499R_0402; R_0402_1005Metric; Tolerance 1%; MPN CR0402-FX-4990GLF; LCSC Part # C2077209
R227: R_2k2_0402; R_0402_1005Metric; Tolerance 1%; MPN CR0402-FX-2201GLF; LCSC Part # C2076845
R228: R_10k_0402; R_0402_1005Metric; Tolerance 1%; MPN CR0402-FX-1002GLF; LCSC Part # C202396; not fitted
R293: R_0R_0402; R_0402_1005Metric; MPN ERJ2GE0R00X; LCSC Part # C242160; not fitted
TP21, TP22, TP56, TP57, TP58: TP_0.75mm_SMD; TP_SMD_0.75mm
U36: TS3DV642RUARQ1; WQFN-42-1EP_3.5x9mm_P0.5mm; MPN TS3DV642RUARQ1; LCSC Part # C3226205
U43: NTS0102_XSON; XSON-8_1x1.95mm_P0.5mm; MPN NTS0102GT; LCSC Part # C2687851
U44, U45, U46: TPD4E05U06QDQARQ1; USON-10_2.5x1mm_P0.5mm; MPN TPD4E05U06QDQARQ1; LCSC Part # C81353

Connections:
5V_HDMI: C51.1, C164.2, D38.1 (C), J13.18 (+5V), R281.2, R282.2, U43.7 (VCC_{B})
+1V8: Q1.1 (G), R47.2
+3V3: C47.2, C163.2, Q2.1 (G), R49.2, R160.2, R208.2, R211.2, R228.2, R279.2, R280.2, U36.1 (VCC), U43.3 (VCC_{A}), U43.6 (OE)
+5V: FB4.1
DP1_AUX_N: C138.1
DP1_AUX_P: C139.1
DP1_HDMI_AUX_N: U36.4 (SDA/AUX-)
DP1_HDMI_AUX_P: U36.3 (SCL/AUX+)
DP1_HPD: R40.2, TP21.1
DP1_TXD0_HDMI_TX2_N: C92.2
DP1_TXD0_HDMI_TX2_P: C135.2
DP1_TXD0_N: U36.31 (D3-A)
DP1_TXD0_P: U36.32 (D3+A)
DP1_TXD1_HDMI_TX1_N: C88.2
DP1_TXD1_HDMI_TX1_P: C133.2
DP1_TXD1_N: U36.33 (D2-A)
DP1_TXD1_P: U36.34 (D2+A)
DP1_TXD2_HDMI_TX0_N: C87.2
DP1_TXD2_HDMI_TX0_P: C132.2
DP1_TXD2_N: U36.35 (D1-A)
DP1_TXD2_P: U36.36 (D1+A)
DP1_TXD3_HDMI_TXC_N: C86.2
DP1_TXD3_HDMI_TXC_P: C131.2
DP1_TXD3_N: U36.37 (D0-A)
DP1_TXD3_P: U36.38 (D0+A)
DP_MUX_AUX_A+: R277.1, U36.40 (SCL/AUX+_B)
DP_MUX_AUX_A-: R278.1, U36.39 (SDA/AUX-_B)
DP_MUX_AUX_B+: C139.2, U36.42 (SCL/AUX+_A)
DP_MUX_AUX_B-: C138.2, U36.41 (SDA/AUX-_A)
DP_MUX_D0+: C131.1, U36.5 (D0+)
DP_MUX_D0-: C86.1, U36.6 (D0-)
DP_MUX_D1+: C132.1, U36.7 (D1+)
DP_MUX_D1-: C87.1, U36.8 (D1-)
DP_MUX_D2+: C133.1, U36.10 (D2+)
DP_MUX_D2-: C88.1, U36.11 (D2-)
DP_MUX_D3+: C135.1, U36.12 (D3+)
DP_MUX_D3-: C92.1, U36.13 (D3-)
DP_MUX_EN: R160.1, U36.2 (EN)
GND: C47.1, C51.2, C163.1, C164.1, J13.1 (D2S), J13.4 (D1S), J13.7 (D0S), J13.10 (CKS), J13.13 (GND), J13.SH, Q2.2 (S), Q3.2 (S), Q12.2 (S), R227.1, U36.43 (GND), U43.2 (GND), U44.3, U44.8, U45.3, U45.8, U46.3, U46.8
HDMI_CEC_5V: J13.14 (CEC), TP58.1, U46.5, U46.6
HDMI_CLK_CONN_N: J13.12 (CK-), R34.1 (R1.1), U45.1, U45.10
HDMI_CLK_CONN_P: J13.11 (CK+), R34.2 (R2.1), U45.2, U45.9
HDMI_CLK_N: R34.8 (R1.2), R221.2, U36.28 (D0-B)
HDMI_CLK_P: R34.7 (R2.2), R224.2, U36.29 (D0+B)
HDMI_D0_CONN_N: J13.9 (D0-), R34.3 (R3.1), U45.4, U45.7
HDMI_D0_CONN_P: J13.8 (D0+), R34.4 (R4.1), U45.5, U45.6
HDMI_D0_N: R34.6 (R3.2), R214.2, U36.26 (D1-B)
HDMI_D0_P: R34.5 (R4.2), R220.2, U36.27 (D1+B)
HDMI_D1_CONN_N: J13.6 (D1-), R35.1 (R1.1), U44.1, U44.10
HDMI_D1_CONN_P: J13.5 (D1+), R35.2 (R2.1), U44.2, U44.9
HDMI_D1_N: R35.8 (R1.2), R212.2, U36.24 (D2-B)
HDMI_D1_P: R35.7 (R2.2), R213.2, U36.25 (D2+B)
HDMI_D2_CONN_N: J13.3 (D2-), R35.3 (R3.1), U44.4, U44.7
HDMI_D2_CONN_P: J13.2 (D2+), R35.4 (R4.1), U44.5, U44.6
HDMI_D2_N: R35.6 (R3.2), R209.2, U36.22 (D3-B)
HDMI_D2_P: R35.5 (R4.2), R210.2, U36.23 (D3+B)
HDMI_HPD: Q12.3 (D), R208.1, R225.1, R226.1, TP22.1, U36.21 (HPD_B)
HDMI_HPD_5V: J13.19 (HPD/HEAC-), R226.2, R227.2, R293.2, U46.1, U46.10
HDMI_HPD_5V_R: Q12.1 (G), R293.1
HDMI_SCL_3V3: R277.2, R280.1, TP57.1, U43.4 (A_{2})
HDMI_SCL_5V: J13.15 (SCL), R282.1, U43.1 (B_{2}), U46.4, U46.7
HDMI_SDA_3V3: R278.2, R279.1, TP56.1, U43.5 (A_{1})
HDMI_SDA_5V: J13.16 (SDA), R281.1, U43.8 (B_{1}), U46.2, U46.9
unnamed: D38.2 (A), FB4.2
unnamed: Q1.2 (S), R40.1, R47.1
unnamed: Q1.3 (D), R49.1, U36.14 (HPD)
unnamed: Q2.3 (D), R209.1, R210.1, R212.1, R213.1, R214.1, R220.1, R221.1, R224.1
unnamed: Q3.3 (D), R225.2, R228.1, U36.17 (SEL2)
unnamed: R211.1, U36.16 (SEL1)
USBC_HPD: Q3.1 (G), U36.19 (HPD_A)

Notes on the sheet:
USE THIN TRACES FOR HIGH INDUCTANCE
Note: 10K internal pullup on AB pins
HDMI Connector
