HW-Lab-Hardware-Design-Agency/jetson-orin-baseboard/jetson-orin-baseboard.kicad_sch

## KiCad design jetson-orin-baseboard.kicad_sch (2025-10-24)

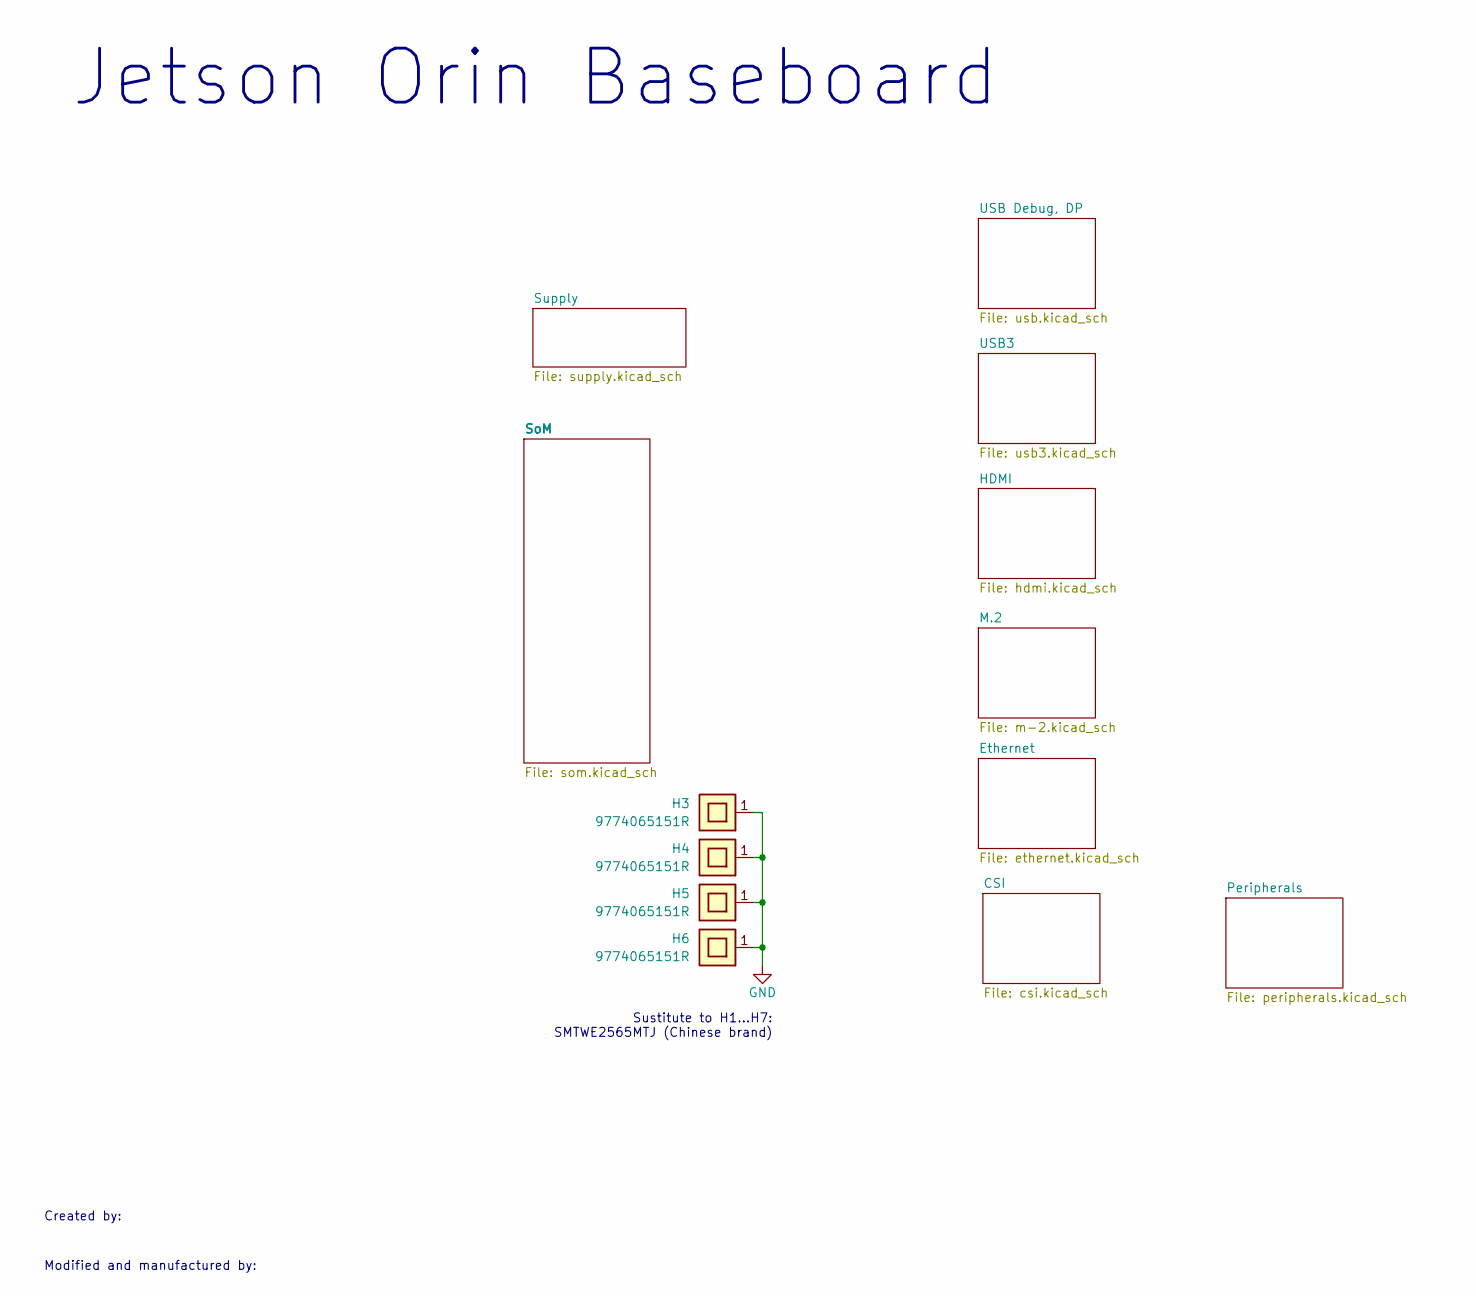
[picture p50: schematic jetson-orin-baseboard.kicad_sch]

Parts:
H3, H4, H5, H6: Spacer_Drill3.7mm_H6.5mm_9774065151R; MPN 9774065151R; Digikey Part # 732-9774065151RCT-ND

Connections:
GND: H3.1, H4.1, H5.1, H6.1

Notes on the sheet:
Sustitute to H1...H7: SMTWE2565MTJ (Chinese brand)
Modified and manufactured by:
Jetson Orin Baseboard
Created by:
