HW-Lab-Hardware-Design-Agency/jetson-orin-baseboard/m-2.kicad_sch

## KiCad design m-2.kicad_sch (2025-10-24)

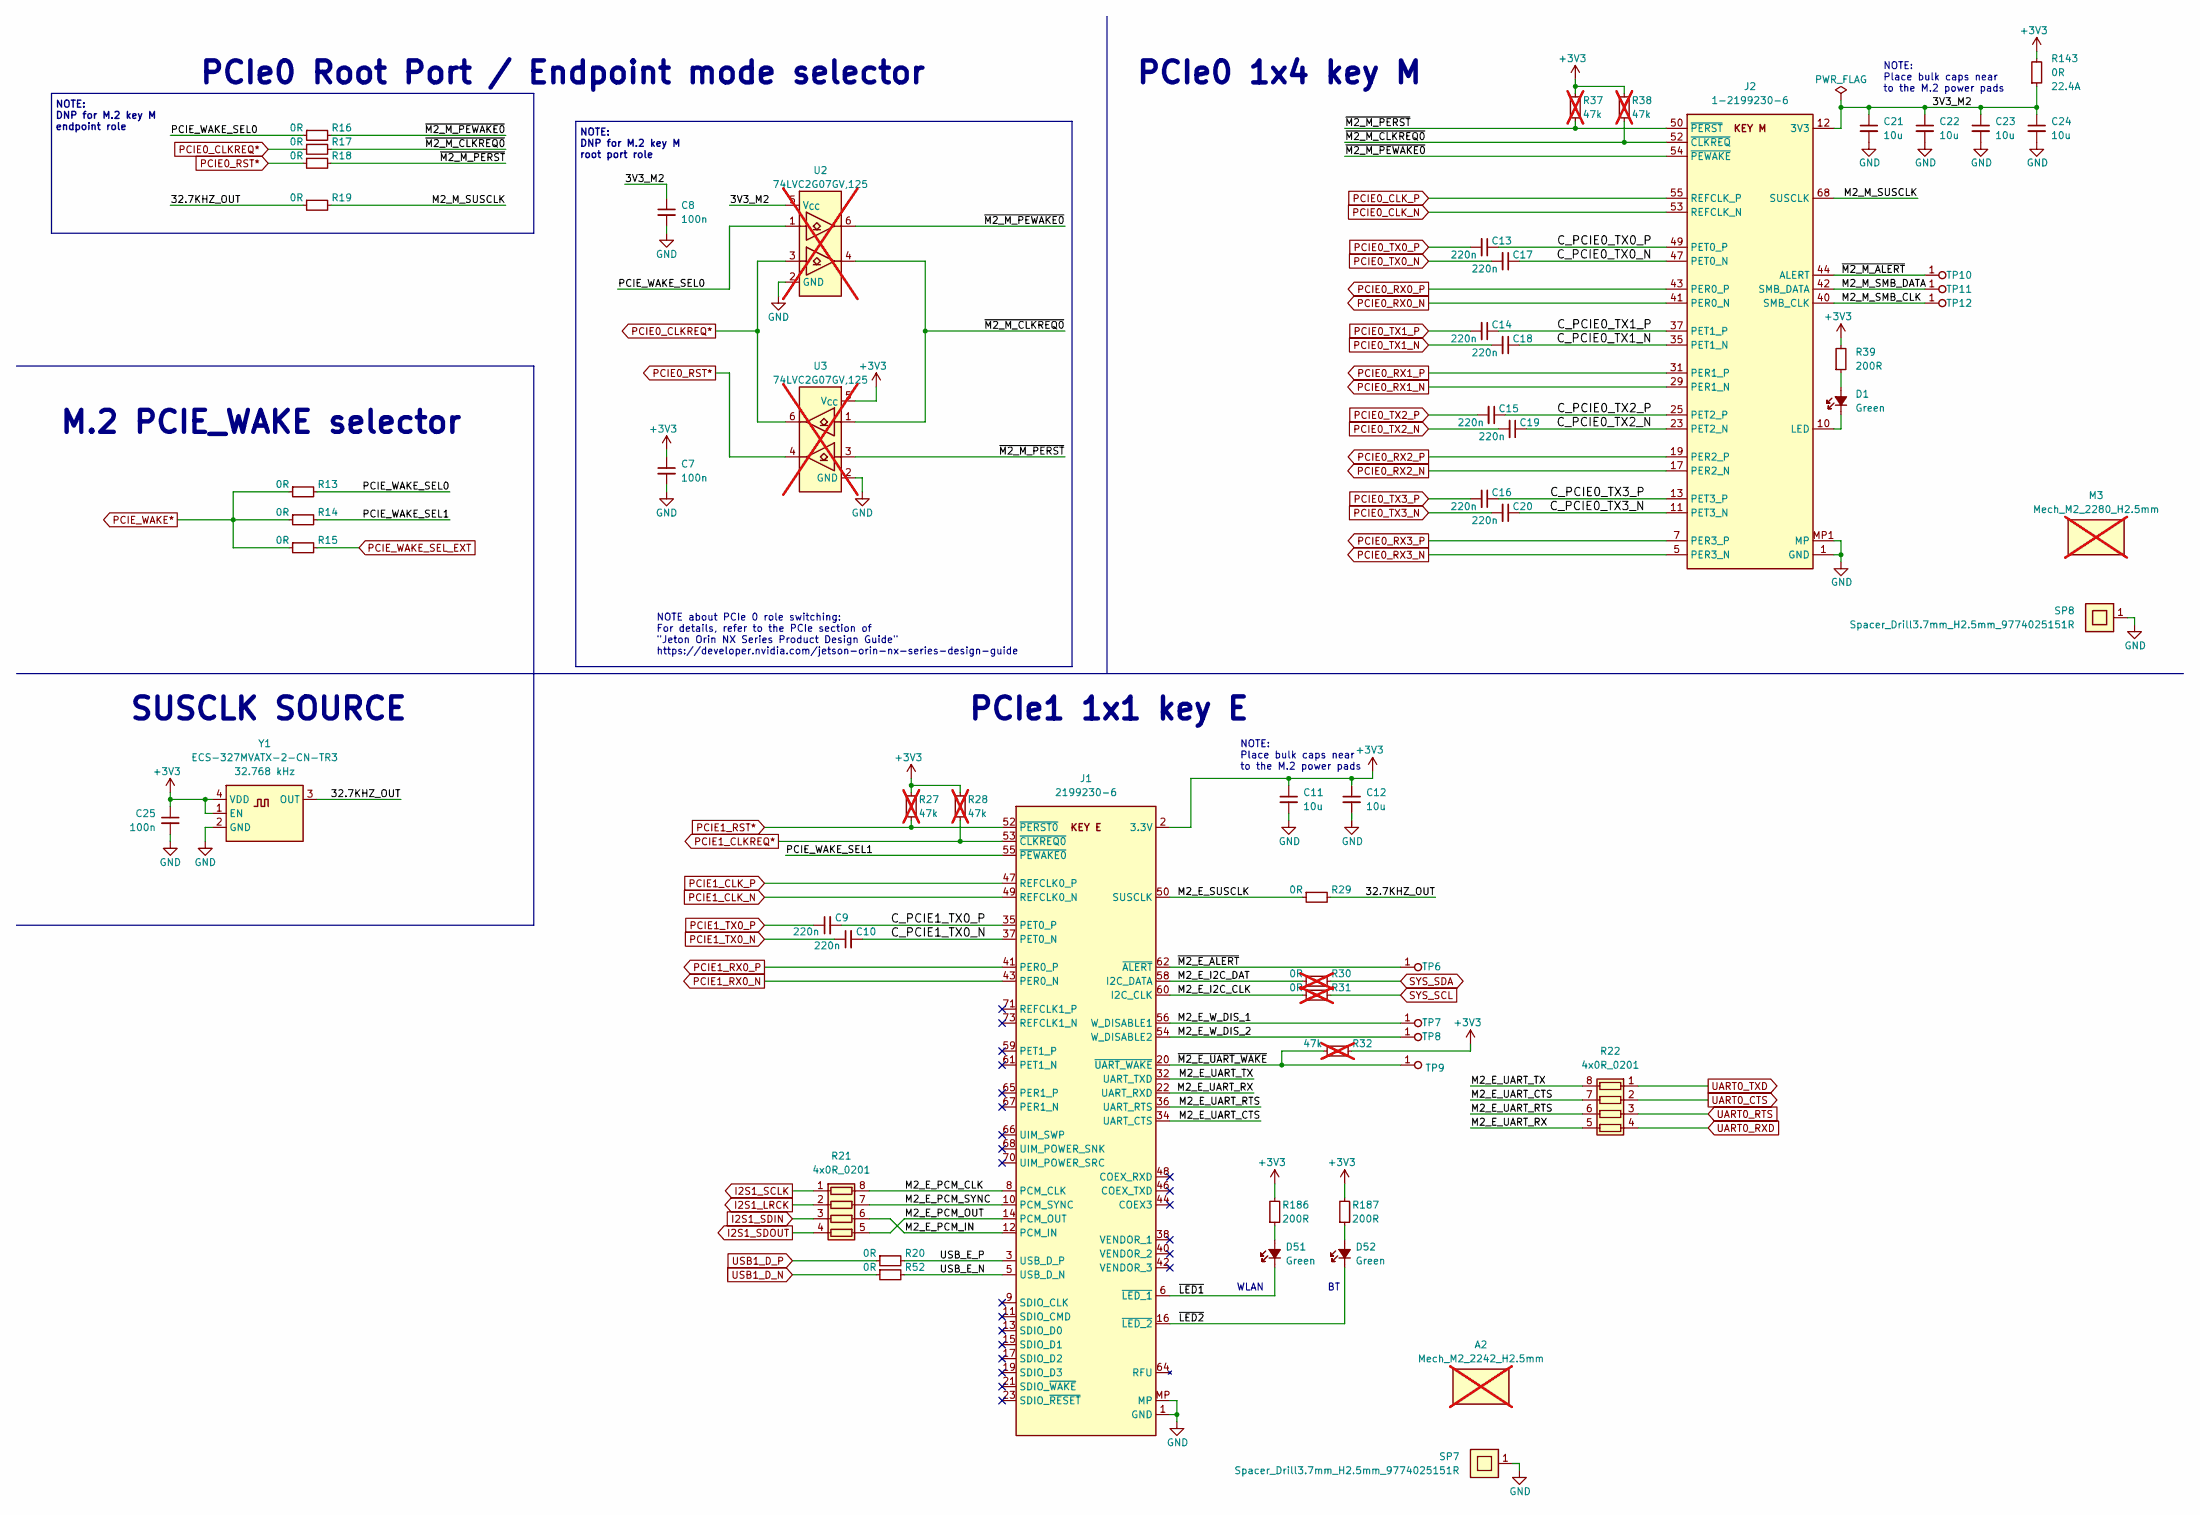
[picture p51: schematic m-2.kicad_sch]

Parts:
A2: Mech_M2_2242_H2.5mm; not fitted
C7, C8, C25: C_100n_0402; C_0402_1005Metric; Voltage 50V; MPN GRM155R61H104KE14D; LCSC Part # C85960
C9, C10, C13, C14, C15, C16, C17, C18, C19, C20: C_220n_0402; C_0402_1005Metric; MPN CC0402KRX5R6BB224; LCSC Part # C106257
C11, C12, C21, C22, C23, C24: C_10u_0603; C_0603_1608Metric; MPN GRM188R61A106KE69D; LCSC Part # C77044
D1, D51, D52: LED_G_0603_LTST-C190GKT; LED_0603_1608Metric_G; MPN LTST-C190GKT; LCSC Part # C125093
J1: Bus_M.2_2199230-6; Bus_M.2_Socket_Key_E_TE_2199230-6; MPN 2199230-6; LCSC Part # C4710843
J2: Bus_M.2_1-2199230-6; Bus_M.2_Socket_Key_M_TE_1-2199230-6; MPN 1-2199230-6; LCSC Part # C4710843
M3: Mech_M2_2280_H2.5mm; not fitted
R13, R14, R15, R16, R17, R18, R19, R20, R29, R52: R_0R_0402; R_0402_1005Metric; MPN ERJ2GE0R00X; LCSC Part # C242160
R21, R22: R_4x0R_0201_array; R_Array_4x0201_Panasonic_EXB18V; MPN EXB-18VR000X; LCSC Part # C1731295
R27, R28, R32, R37, R38: R_47k_0402; R_0402_1005Metric; Tolerance 1%; MPN CR0402-FX-4702GLF; LCSC Part # C2091678; not fitted
R30, R31: R_0R_0402; R_0402_1005Metric; MPN ERJ2GE0R00X; LCSC Part # C242160; not fitted
R39, R186, R187: R_200R_0402; R_0402_1005Metric; Tolerance 1%; MPN CR0402-FX-2000GLF; LCSC Part # C19946422
R143: R_0R_22.4A_0603; R_0603_1608Metric; Tolerance template_tolerance; MPN PMR03EZPJ000; LCSC Part # C253507
SP7, SP8: Spacer_Drill3.7mm_H2.5mm_9774025151R; MPN 9774025151R; Digikey Part # 732-7078-1-ND
TP6, TP7, TP8, TP9, TP10, TP11, TP12: TP_0.75mm_SMD; TP_SMD_0.75mm
U2, U3: 74LVC2G07_SOT457; SC-74-6_1.5x2.9mm_P0.95mm; MPN 74LVC2G07GV,125; LCSC Part # C548568; not fitted
Y1: Oscillator_32.768kHz_ECS_2520MV; Oscillator_SMD_ECS_2520MV_2.5x2mm; MPN ECS-327MVATX-2-CN-TR3; LCSC Part # C5375606

Connections:
3V3_M2: C8.1, C21.1, C22.1, C23.1, C24.1, J2.2 (3V3), J2.4 (3V3), J2.12 (3V3), J2.14 (3V3), J2.16 (3V3), J2.18 (3V3), J2.70 (3V3), J2.72 (3V3), J2.74 (3V3), R143.1, U2.5 (V_{CC})
32.7KHZ_OUT: R19.1, R29.2, Y1.3 (OUT)
+3V3: C7.1, C11.1, C12.1, C25.1, J1.2 (3.3V), J1.4 (3.3V), J1.72 (3.3V), J1.74 (3.3V), R27.1, R28.1, R32.2, R37.1, R38.1, R39.2, R143.2, R186.2, R187.2, U3.5 (V_{CC}), Y1.1 (EN), Y1.4 (VDD)
C_PCIE0_TX0_N: C17.1, J2.47 (PET0_N)
C_PCIE0_TX0_P: C13.1, J2.49 (PET0_P)
C_PCIE0_TX1_N: C18.1, J2.35 (PET1_N)
C_PCIE0_TX1_P: C14.1, J2.37 (PET1_P)
C_PCIE0_TX2_N: C19.1, J2.23 (PET2_N)
C_PCIE0_TX2_P: C15.1, J2.25 (PET2_P)
C_PCIE0_TX3_N: C20.1, J2.11 (PET3_N)
C_PCIE0_TX3_P: C16.1, J2.13 (PET3_P)
C_PCIE1_TX0_N: C10.2, J1.37 (PET0_N)
C_PCIE1_TX0_P: C9.2, J1.35 (PET0_P)
GND: C7.2, C8.2, C11.2, C12.2, C21.2, C22.2, C23.2, C24.2, C25.2, J1.1 (GND), J1.7 (GND), J1.18 (GND), J1.33 (GND), J1.39 (GND), J1.45 (GND), J1.51 (GND), J1.57 (GND), J1.63 (GND), J1.69 (GND), J1.75 (GND), J1.MP, J2.1 (GND), J2.3 (GND), J2.9 (GND), J2.15 (GND), J2.21 (GND), J2.27 (GND), J2.33 (GND), J2.39 (GND), J2.45 (GND), J2.51 (GND), J2.57 (GND), J2.71 (GND), J2.73 (GND), J2.75 (GND), J2.MP1 (MP), J2.MP2 (MP), SP7.1, SP8.1, U2.2 (GND), U3.2 (GND), Y1.2 (GND)
I2S1_LRCK: R21.2 (R2.1)
I2S1_SCLK: R21.1 (R1.1)
I2S1_SDIN: R21.3 (R3.1)
I2S1_SDOUT: R21.4 (R4.1)
M2_E_I2C_CLK: J1.60 (I2C_CLK), R31.1
M2_E_I2C_DAT: J1.58 (I2C_DATA), R30.1
M2_E_PCM_CLK: J1.8 (PCM_CLK), R21.8 (R1.2)
M2_E_PCM_IN: J1.12 (PCM_IN), R21.6 (R3.2)
M2_E_PCM_OUT: J1.14 (PCM_OUT), R21.5 (R4.2)
M2_E_PCM_SYNC: J1.10 (PCM_SYNC), R21.7 (R2.2)
M2_E_SUSCLK: J1.50 (SUSCLK), R29.1
M2_E_UART_CTS: J1.34 (UART_CTS), R22.7 (R2.2)
M2_E_UART_RTS: J1.36 (UART_RTS), R22.6 (R3.2)
M2_E_UART_RX: J1.22 (UART_RXD), R22.5 (R4.2)
M2_E_UART_TX: J1.32 (UART_TXD), R22.8 (R1.2)
M2_E_W_DIS_1: J1.56 (W_DISABLE1), TP7.1
M2_E_W_DIS_2: J1.54 (W_DISABLE2), TP8.1
M2_M_SMB_CLK: J2.40 (SMB_CLK), TP12.1
M2_M_SMB_DATA: J2.42 (SMB_DATA), TP11.1
M2_M_SUSCLK: J2.68 (SUSCLK), R19.2
unnamed: D1.1 (C), J2.10 (LED)
unnamed: D1.2 (A), R39.1
unnamed: D51.2 (A), R186.1
unnamed: D52.2 (A), R187.1
PCIE0_CLKREQ*: R17.1, U2.3, U3.6
PCIE0_CLK_N: J2.53 (REFCLK_N)
PCIE0_CLK_P: J2.55 (REFCLK_P)
PCIE0_RST*: R18.1, U3.4
PCIE0_RX0_N: J2.41 (PER0_N)
PCIE0_RX0_P: J2.43 (PER0_P)
PCIE0_RX1_N: J2.29 (PER1_N)
PCIE0_RX1_P: J2.31 (PER1_P)
PCIE0_RX2_N: J2.17 (PER2_N)
PCIE0_RX2_P: J2.19 (PER2_P)
PCIE0_RX3_N: J2.5 (PER3_N)
PCIE0_RX3_P: J2.7 (PER3_P)
PCIE0_TX0_N: C17.2
PCIE0_TX0_P: C13.2
PCIE0_TX1_N: C18.2
PCIE0_TX1_P: C14.2
PCIE0_TX2_N: C19.2
PCIE0_TX2_P: C15.2
PCIE0_TX3_N: C20.2
PCIE0_TX3_P: C16.2
PCIE1_CLKREQ*: J1.53 (~CLKREQ0), R28.2
PCIE1_CLK_N: J1.49 (REFCLK0_N)
PCIE1_CLK_P: J1.47 (REFCLK0_P)
PCIE1_RST*: J1.52 (~PERST0), R27.2
PCIE1_RX0_N: J1.43 (PER0_N)
PCIE1_RX0_P: J1.41 (PER0_P)
PCIE1_TX0_N: C10.1
PCIE1_TX0_P: C9.1
PCIE_WAKE*: R13.1, R14.1, R15.1
PCIE_WAKE_SEL0: R13.2, R16.1, U2.1
PCIE_WAKE_SEL1: J1.55 (~PEWAKE0), R14.2
PCIE_WAKE_SEL_EXT: R15.2
SYS_SCL: R31.2
SYS_SDA: R30.2
UART0_CTS: R22.2 (R2.1)
UART0_RTS: R22.3 (R3.1)
UART0_RXD: R22.4 (R4.1)
UART0_TXD: R22.1 (R1.1)
USB1_D_N: R52.1
USB1_D_P: R20.1
USB_E_N: J1.5 (USB_D_N), R52.2
USB_E_P: J1.3 (USB_D_P), R20.2
~LED1: D51.1 (C), J1.6 (~LED_1)
~LED2: D52.1 (C), J1.16 (~LED_2)
~M2_E_ALERT: J1.62 (~ALERT), TP6.1
~M2_E_UART_WAKE: J1.20 (~UART_WAKE), R32.1, TP9.1
~M2_M_ALERT: J2.44 (ALERT), TP10.1
~M2_M_CLKREQ0: J2.52 (~CLKREQ), R17.2, R38.2, U2.4, U3.1
~M2_M_PERST: J2.50 (~PERST), R18.2, R37.2, U3.3
~M2_M_PEWAKE0: J2.54 (~PEWAKE), R16.2, U2.6

Notes on the sheet:
PCIe1 1x1 key E
NOTE about PCIe 0 role switching: For details, refer to the PCIe section of "Jeton Orin NX Series Product Design Guide" https://developer.nvidia.com/jetson-orin-nx-series-design-guide
M.2 PCIE_WAKE selector
PCIe0 1x4 key M
NOTE: Place bulk caps near to the M.2 power pads
WLAN
NOTE: DNP for M.2 key M root port role
PCIe0 Root Port / Endpoint mode selector
SUSCLK SOURCE
NOTE: DNP for M.2 key M endpoint role
