HW-Lab-Hardware-Design-Agency/jetson-orin-baseboard/peripherals.kicad_sch

## KiCad design peripherals.kicad_sch (2025-10-24)

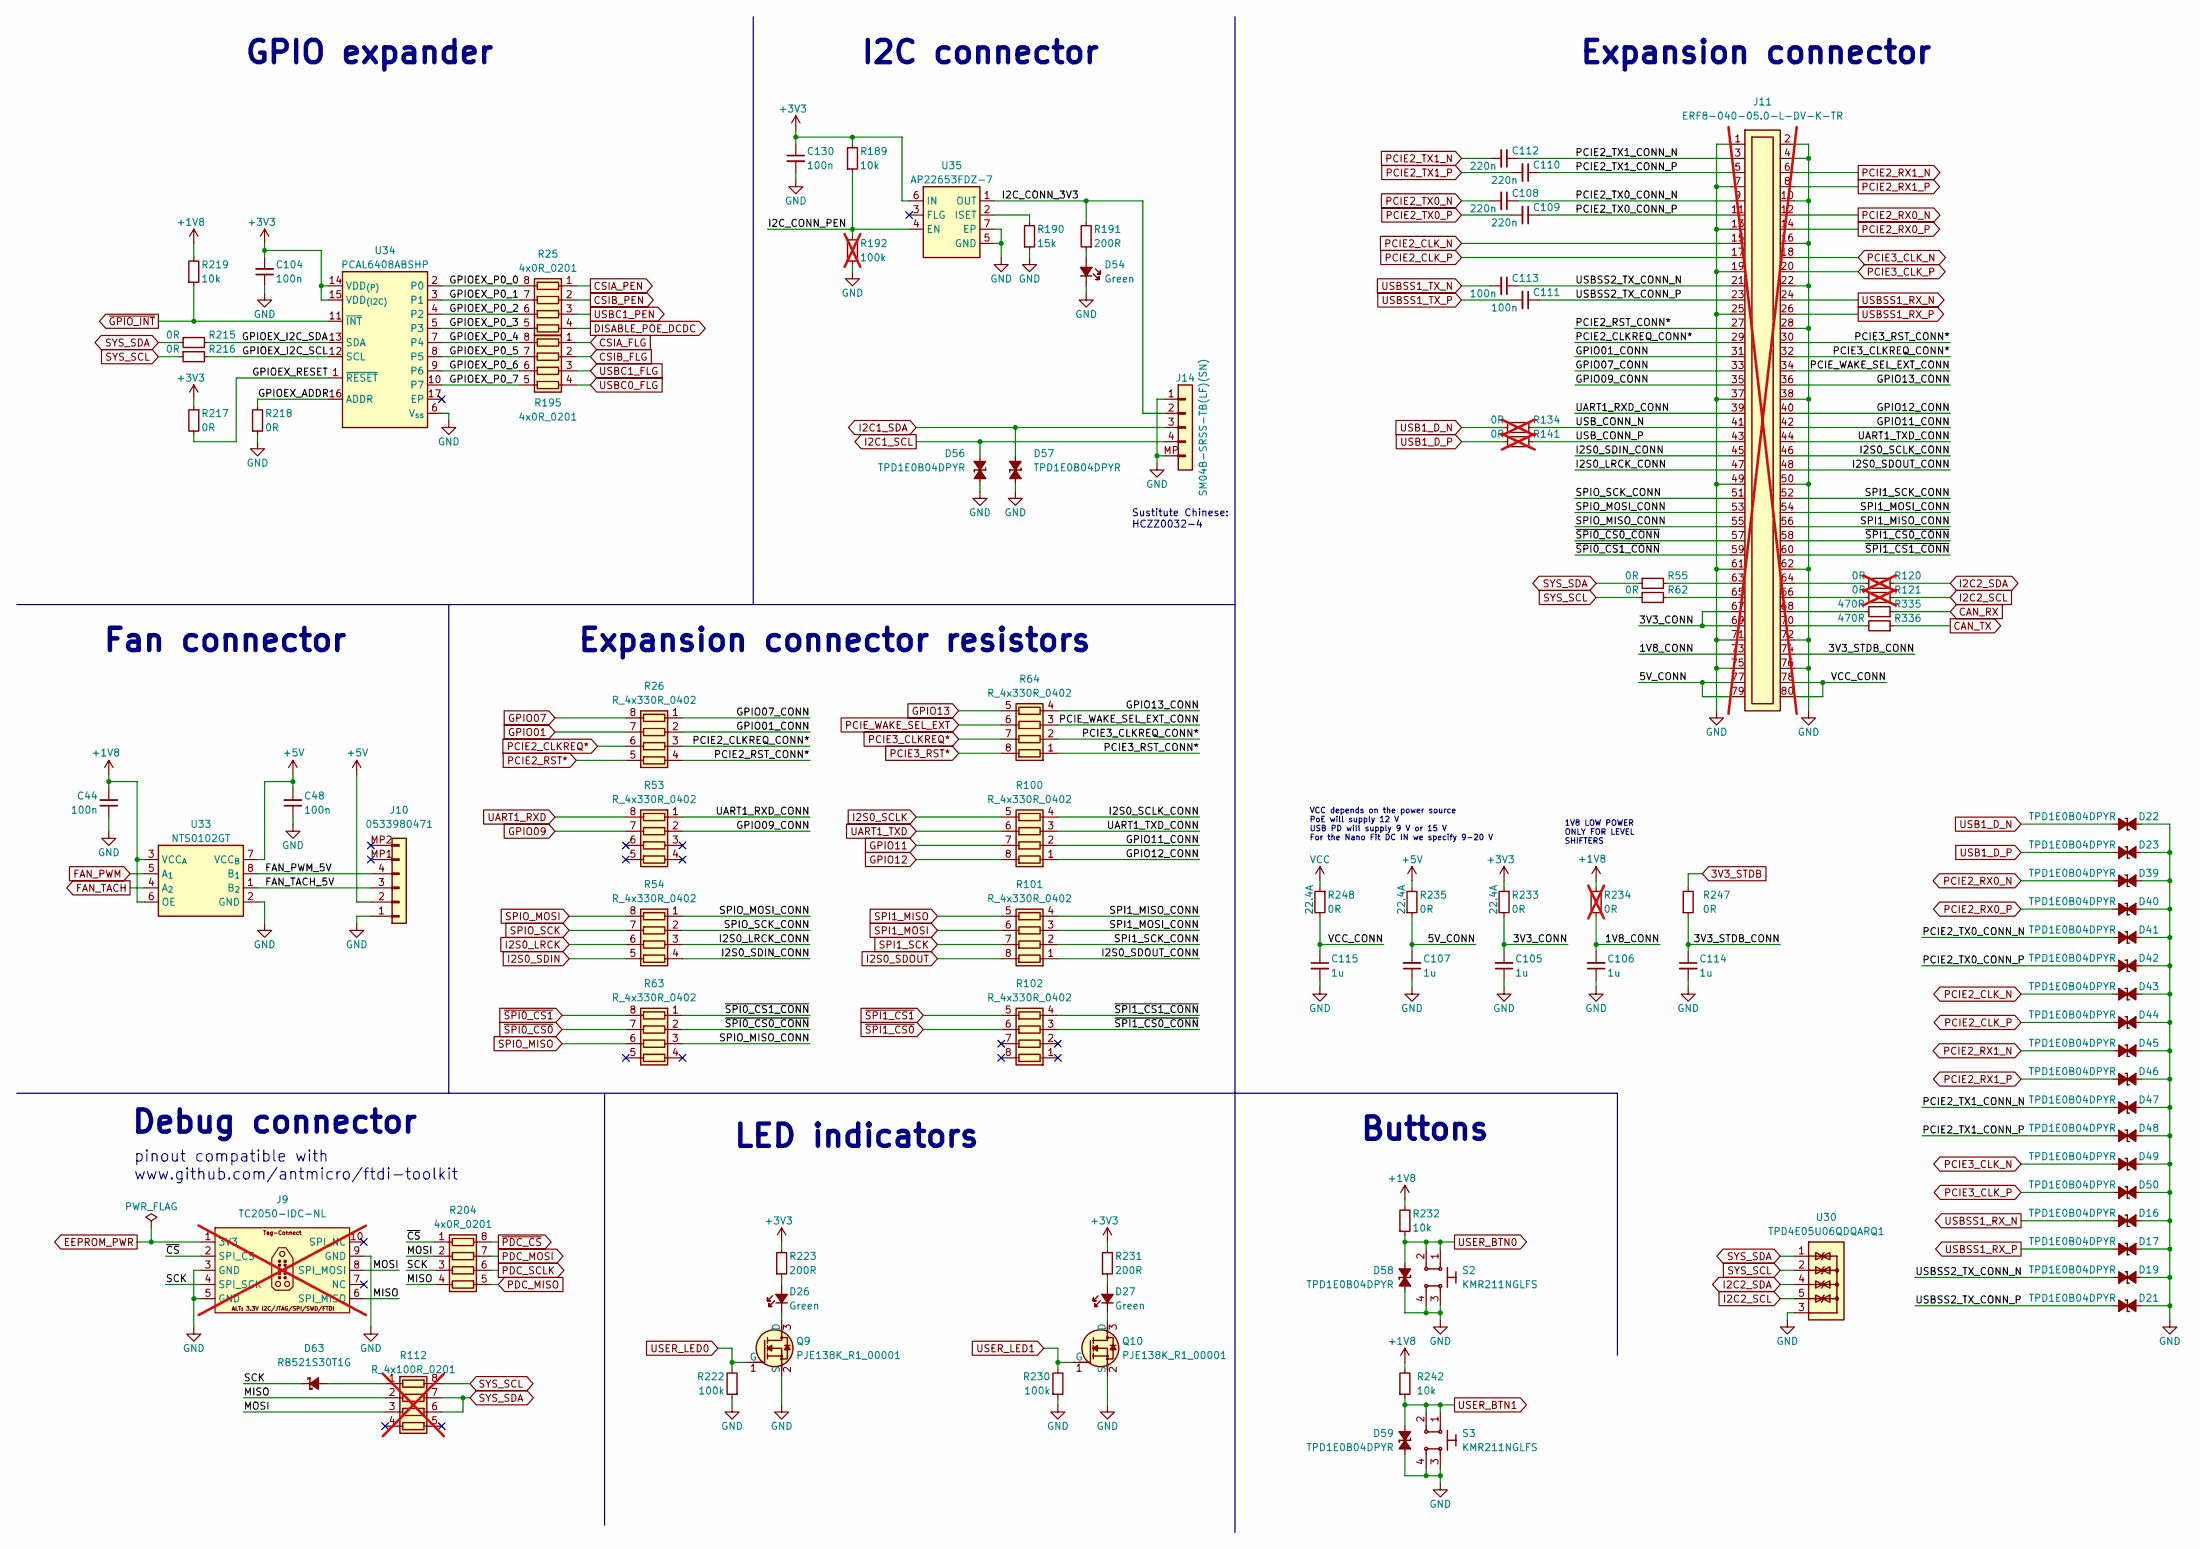
[picture p52: schematic peripherals.kicad_sch]

Parts:
C44, C48, C104, C111, C113, C130: C_100n_0402; C_0402_1005Metric; Voltage 50V; MPN GRM155R61H104KE14D; LCSC Part # C85960
C105, C106, C107, C114, C115: C_1u_0402; C_0402_1005Metric; MPN C1005X6S1A105K050BC; LCSC Part # C2182694
C108, C109, C110, C112: C_220n_0402; C_0402_1005Metric; MPN CC0402KRX5R6BB224; LCSC Part # C106257
D16, D17, D19, D21, D22, D23, D39, D40, D41, D42, D43, D44, D45, D46, D47, D48, D49, D50, D56, D57, D58, D59: TPD1E0B04_XDFN-2; XDFN-2_1x0.60mm; MPN TPD1E0B04DPYR; LCSC Part # C5182093
D26, D27, D54: LED_G_0603_LTST-C190GKT; LED_0603_1608Metric_G; MPN LTST-C190GKT; LCSC Part # C125093
D63: RB521S30T1G; SOD-523; MPN RB521S30T1G; LCSC Part # C145179
J9: Tag-Connect_TC2050-IDC-NL_2x5_P1.27mm; MPN TC2050-IDC-NL; LCSC Part # C4371149; not fitted
J10: Molex_PicoBlade_1x4_0533980471; Conn_Molex_PicoBlade_1x4_0533980471; MPN 0533980471; LCSC Part # C234195
J11: Socket_Samtec_ERF8_2x40_ERF8-040-05.0-L-DV-K-TR; Conn_Socket_Samtec_ERF8_2x40_ERF8-040-05.0-L-DV-K-TR; MPN ERF8-040-05.0-L-DV-K-TR; LCSC Part # C3649331; not fitted
J14: JST_SH_1x4_SM04B-SRSS-TB-LF-SN; Conn_JST_SH_1x4_SM04B-SRSS-TB-LF-SN; MPN SM04B-SRSS-TB(LF)(SN); LCSC Part # C160404
Q9, Q10: PJE138K; SOT-523; MPN PJE138K_R1_00001; LCSC Part # C391643
R25, R195, R204: R_4x0R_0201_array; R_Array_4x0201_Panasonic_EXB18V; MPN EXB-18VR000X; LCSC Part # C1731295
R26, R53, R54, R63, R64, R100, R101, R102: R_4x330R_0402_array; R_Array_4x0402; MPN EXB-28V331JX; LCSC Part # C2654089
R55, R62, R215, R216, R217, R218: R_0R_0402; R_0402_1005Metric; MPN ERJ2GE0R00X; LCSC Part # C242160
R112: R_4x100R_0201_array; R_Array_4x0201_Panasonic_EXB18V; MPN EXB-18V101JX; LCSC Part # C178752; not fitted
R120, R121, R134, R141: R_0R_0402; R_0402_1005Metric; MPN ERJ2GE0R00X; LCSC Part # C242160; not fitted
R189, R219, R232, R242: R_10k_0402; R_0402_1005Metric; Tolerance 1%; MPN CR0402-FX-1002GLF; LCSC Part # C202396
R190: R_15k_0402; R_0402_1005Metric; Tolerance 1%; MPN CR0402-FX-1502GLF; LCSC Part # C19946417
R191, R223, R231: R_200R_0402; R_0402_1005Metric; Tolerance 1%; MPN CR0402-FX-2000GLF; LCSC Part # C19946422
R192: R_100k_0402; R_0402_1005Metric; Tolerance 1%; MPN CR0402-FX-1003GLF; LCSC Part # C2077080; not fitted
R222, R230: R_100k_0402; R_0402_1005Metric; Tolerance 1%; MPN CR0402-FX-1003GLF; LCSC Part # C2077080
R233, R235, R248: R_0R_22.4A_0603; R_0603_1608Metric; Tolerance template_tolerance; MPN PMR03EZPJ000; LCSC Part # C253507
R234: R_0R_0603; R_0603_1608Metric; MPN CR0603-J/-000ELF; LCSC Part # C512908; not fitted
R247: R_0R_0603; R_0603_1608Metric; MPN CR0603-J/-000ELF; LCSC Part # C512908
R335, R336: R_470R_0402; R_0402_1005Metric; Tolerance 1%; MPN CR0402-FX-4700GLF; LCSC Part # C2077077
S2, S3: SW_KMR211NGLFS_SMD; MPN KMR211NGLFS; LCSC Part # C221676
U30: TPD4E05U06QDQARQ1; USON-10_2.5x1mm_P0.5mm; MPN TPD4E05U06QDQARQ1; LCSC Part # C81353
U33: NTS0102_XSON; XSON-8_1x1.95mm_P0.5mm; MPN NTS0102GT; LCSC Part # C2687851
U34: PCAL6408A_VQFN; VQFN-16-1EP_3x3mm_P0.5mm_EP1.68x1.68mm; MPN PCAL6408ABSHP; LCSC Part # C2652332
U35: AP22653_DFN; DFN-6-1EP_2x2mm_P0.65mm_EP1x1.6mm; MPN AP22653FDZ-7; LCSC Part # C3001604

Connections:
1V8_CONN: C106.2, J11.73, R234.2
3V3_CONN: C105.2, J11.67, J11.69, R233.2
3V3_STDB: R247.2
3V3_STDB_CONN: C114.1, J11.74, R247.1
5V_CONN: C107.2, J11.77, J11.79, R235.1
+1V8: C44.2, R219.2, R232.2, R234.1, R242.2, U33.3 (VCC_{A}), U33.6 (OE)
+3V3: C104.2, C130.1, R189.2, R217.1, R223.2, R231.2, R233.1, U34.14 (VDD_{(P)}), U34.15 (VDD_{(I2C)}), U35.6 (IN)
+5V: C48.2, J10.2, R235.2, U33.7 (VCC_{B})
CAN_RX: R335.1
CAN_TX: R336.1
CSIA_FLG: R195.1 (R1.1)
CSIA_PEN: R25.1 (R1.1)
CSIB_FLG: R195.2 (R2.1)
CSIB_PEN: R25.2 (R2.1)
DISABLE_POE_DCDC: R25.4 (R4.1)
EEPROM_PWR: J9.1
FAN_PWM: U33.5 (A_{1})
FAN_PWM_5V: J10.4, U33.8 (B_{1})
FAN_TACH: U33.4 (A_{2})
FAN_TACH_5V: J10.3, U33.1 (B_{2})
GND: C44.1, C48.1, C104.1, C105.1, C106.1, C107.1, C114.2, C115.2, C130.2, D16.2 (A), D17.2 (A), D19.2 (A), D21.2 (A), D22.2 (A), D23.2 (A), D39.2 (A), D40.2 (A), D41.2 (A), D42.2 (A), D43.2 (A), D44.2 (A), D45.2 (A), D46.2 (A), D47.2 (A), D48.2 (A), D49.2 (A), D50.2 (A), D54.1 (C), D56.1 (C), D57.1 (C), D58.1 (C), D59.1 (C), J9.3, J9.5, J9.9, J10.1, J11.1, J11.2, J11.4, J11.7, J11.10, J11.13, J11.16, J11.19, J11.22, J11.25, J11.28, J11.37, J11.38, J11.49, J11.50, J11.61, J11.62, J11.71, J11.72, J11.75, J11.76, J14.1, J14.MP, Q9.2 (S), Q10.2 (S), R190.1, R192.1, R218.1, R222.1, R230.1, S2.3, S2.4, S3.3, S3.4, U30.3, U30.8, U33.2 (GND), U34.6 (V_{ss}), U35.5 (GND), U35.7 (EP)
GPIO01: R26.7 (R2.2)
GPIO01_CONN: J11.31, R26.2 (R2.1)
GPIO07: R26.8 (R1.2)
GPIO07_CONN: J11.33, R26.1 (R1.1)
GPIO09: R53.7 (R2.2)
GPIO09_CONN: J11.35, R53.2 (R2.1)
GPIO11: R100.7 (R2.2)
GPIO11_CONN: J11.42, R100.2 (R2.1)
GPIO12: R100.8 (R1.2)
GPIO12_CONN: J11.40, R100.1 (R1.1)
GPIO13: R64.5 (R4.2)
GPIO13_CONN: J11.36, R64.4 (R4.1)
GPIOEX_ADDR: R218.2, U34.16 (ADDR)
GPIOEX_I2C_SCL: R216.2, U34.12 (SCL)
GPIOEX_I2C_SDA: R215.2, U34.13 (SDA)
GPIOEX_P0_0: R25.8 (R1.2), U34.2 (P0)
GPIOEX_P0_1: R25.7 (R2.2), U34.3 (P1)
GPIOEX_P0_2: R25.6 (R3.2), U34.4 (P2)
GPIOEX_P0_3: R25.5 (R4.2), U34.5 (P3)
GPIOEX_P0_4: R195.8 (R1.2), U34.7 (P4)
GPIOEX_P0_5: R195.7 (R2.2), U34.8 (P5)
GPIOEX_P0_6: R195.6 (R3.2), U34.9 (P6)
GPIOEX_P0_7: R195.5 (R4.2), U34.10 (P7)
GPIOEX_RESET: R217.2, U34.1 (~RESET)
I2C1_SCL: D56.2 (A), J14.4
I2C1_SDA: D57.2 (A), J14.3
I2C2_SCL: R121.2, U30.5, U30.6
I2C2_SDA: R120.2, U30.4, U30.7
I2C_CONN_3V3: J14.2, R191.2, U35.1 (OUT)
I2C_CONN_PEN: R189.1, R192.2, U35.4 (EN)
I2S0_LRCK: R54.6 (R3.2)
I2S0_LRCK_CONN: J11.47, R54.3 (R3.1)
I2S0_SCLK: R100.5 (R4.2)
I2S0_SCLK_CONN: J11.46, R100.4 (R4.1)
I2S0_SDIN: R54.5 (R4.2)
I2S0_SDIN_CONN: J11.45, R54.4 (R4.1)
I2S0_SDOUT: R101.8 (R1.2)
I2S0_SDOUT_CONN: J11.48, R101.1 (R1.1)
MISO: J9.6, R112.2 (R2.1), R204.4 (R4.1)
MOSI: J9.8, R112.3 (R3.1), R204.2 (R2.1)
unnamed: D26.1 (C), Q9.3 (D)
unnamed: D26.2 (A), R223.1
unnamed: D27.1 (C), Q10.3 (D)
unnamed: D27.2 (A), R231.1
unnamed: D54.2 (A), R191.1
unnamed: D63.2 (A), R112.1 (R1.1)
unnamed: J11.63, R55.2
unnamed: J11.64, R120.1
unnamed: J11.65, R62.2
unnamed: J11.66, R121.1
unnamed: J11.68, R335.2
unnamed: J11.70, R336.2
unnamed: R190.2, U35.2 (ISET)
PCIE2_CLKREQ*: R26.6 (R3.2)
PCIE2_CLKREQ_CONN*: J11.29, R26.3 (R3.1)
PCIE2_CLK_N: D43.1 (C), J11.15
PCIE2_CLK_P: D44.1 (C), J11.17
PCIE2_RST*: R26.5 (R4.2)
PCIE2_RST_CONN*: J11.27, R26.4 (R4.1)
PCIE2_RX0_N: D39.1 (C), J11.12
PCIE2_RX0_P: D40.1 (C), J11.14
PCIE2_RX1_N: D45.1 (C), J11.6
PCIE2_RX1_P: D46.1 (C), J11.8
PCIE2_TX0_CONN_N: C108.1, D41.1 (C), J11.9
PCIE2_TX0_CONN_P: C109.1, D42.1 (C), J11.11
PCIE2_TX0_N: C108.2
PCIE2_TX0_P: C109.2
PCIE2_TX1_CONN_N: C112.1, D47.1 (C), J11.3
PCIE2_TX1_CONN_P: C110.1, D48.1 (C), J11.5
PCIE2_TX1_N: C112.2
PCIE2_TX1_P: C110.2
PCIE3_CLKREQ*: R64.7 (R2.2)
PCIE3_CLKREQ_CONN*: J11.32, R64.2 (R2.1)
PCIE3_CLK_N: D49.1 (C), J11.18
PCIE3_CLK_P: D50.1 (C), J11.20
PCIE3_RST*: R64.8 (R1.2)
PCIE3_RST_CONN*: J11.30, R64.1 (R1.1)
PCIE_WAKE_SEL_EXT: R64.6 (R3.2)
PCIE_WAKE_SEL_EXT_CONN: J11.34, R64.3 (R3.1)
PDC_MISO: R204.5 (R4.2)
PDC_MOSI: R204.7 (R2.2)
PDC_SCLK: R204.6 (R3.2)
SCK: D63.1 (C), J9.4, R204.3 (R3.1)
SPI1_MISO: R101.5 (R4.2)
SPI1_MISO_CONN: J11.56, R101.4 (R4.1)
SPI1_MOSI: R101.6 (R3.2)
SPI1_MOSI_CONN: J11.54, R101.3 (R3.1)
SPI1_SCK: R101.7 (R2.2)
SPI1_SCK_CONN: J11.52, R101.2 (R2.1)
SPIO_MISO: R63.6 (R3.2)
SPIO_MISO_CONN: J11.55, R63.3 (R3.1)
SPIO_MOSI: R54.8 (R1.2)
SPIO_MOSI_CONN: J11.53, R54.1 (R1.1)
SPIO_SCK: R54.7 (R2.2)
SPIO_SCK_CONN: J11.51, R54.2 (R2.1)
SYS_SCL: R62.1, R112.8 (R1.2), R216.1, U30.2, U30.9
SYS_SDA: R55.1, R112.6 (R3.2), R112.7 (R2.2), R215.1, U30.1, U30.10
UART1_RXD: R53.8 (R1.2)
UART1_RXD_CONN: J11.39, R53.1 (R1.1)
UART1_TXD: R100.6 (R3.2)
UART1_TXD_CONN: J11.44, R100.3 (R3.1)
USB1_D_N: D22.1 (C), R134.2
USB1_D_P: D23.1 (C), R141.2
USBC0_FLG: R195.4 (R4.1)
USBC1_FLG: R195.3 (R3.1)
USBC1_PEN: R25.3 (R3.1)
USBSS1_RX_N: D16.1 (C), J11.24
USBSS1_RX_P: D17.1 (C), J11.26
USBSS1_TX_N: C113.2
USBSS1_TX_P: C111.2
USBSS2_TX_CONN_N: C113.1, D19.1 (C), J11.21
USBSS2_TX_CONN_P: C111.1, D21.1 (C), J11.23
USB_CONN_N: J11.41, R134.1
USB_CONN_P: J11.43, R141.1
USER_BTN0: D58.2 (A), R232.1, S2.1, S2.2
USER_BTN1: D59.2 (A), R242.1, S3.1, S3.2
USER_LED0: Q9.1 (G), R222.2
USER_LED1: Q10.1 (G), R230.2
VCC: R248.1
VCC_CONN: C115.1, J11.78, J11.80, R248.2
~CS: J9.2, R204.1 (R1.1)
~GPIO_INT: R219.1, U34.11 (~INT)
~PDC_CS: R204.8 (R1.2)
~SPI0_CS0_CONN: J11.57, R63.2 (R2.1)
~SPI0_CS0: R63.7 (R2.2)
~SPI0_CS1_CONN: J11.59, R63.1 (R1.1)
~SPI0_CS1: R63.8 (R1.2)
~SPI1_CS0_CONN: J11.58, R102.3 (R3.1)
~SPI1_CS0: R102.6 (R3.2)
~SPI1_CS1_CONN: J11.60, R102.4 (R4.1)
~SPI1_CS1: R102.5 (R4.2)

Notes on the sheet:
pinout compatible with www.github.com/antmicro/ftdi-toolkit
Fan connector
Expansion connector
LED indicators
Expansion connector resistors
VCC depends on the power source PoE will supply 12 V USB PD will supply 9 V or 15 V For the Nano Fit DC IN we specify 9-20 V
Sustitute Chinese: HCZZ0032-4
GPIO expander
Debug connector
1V8 LOW POWER ONLY FOR LEVEL SHIFTERS
Buttons
I2C connector
