HW-Lab-Hardware-Design-Agency/jetson-orin-baseboard/som.kicad_sch

## KiCad design som.kicad_sch (2025-10-24)

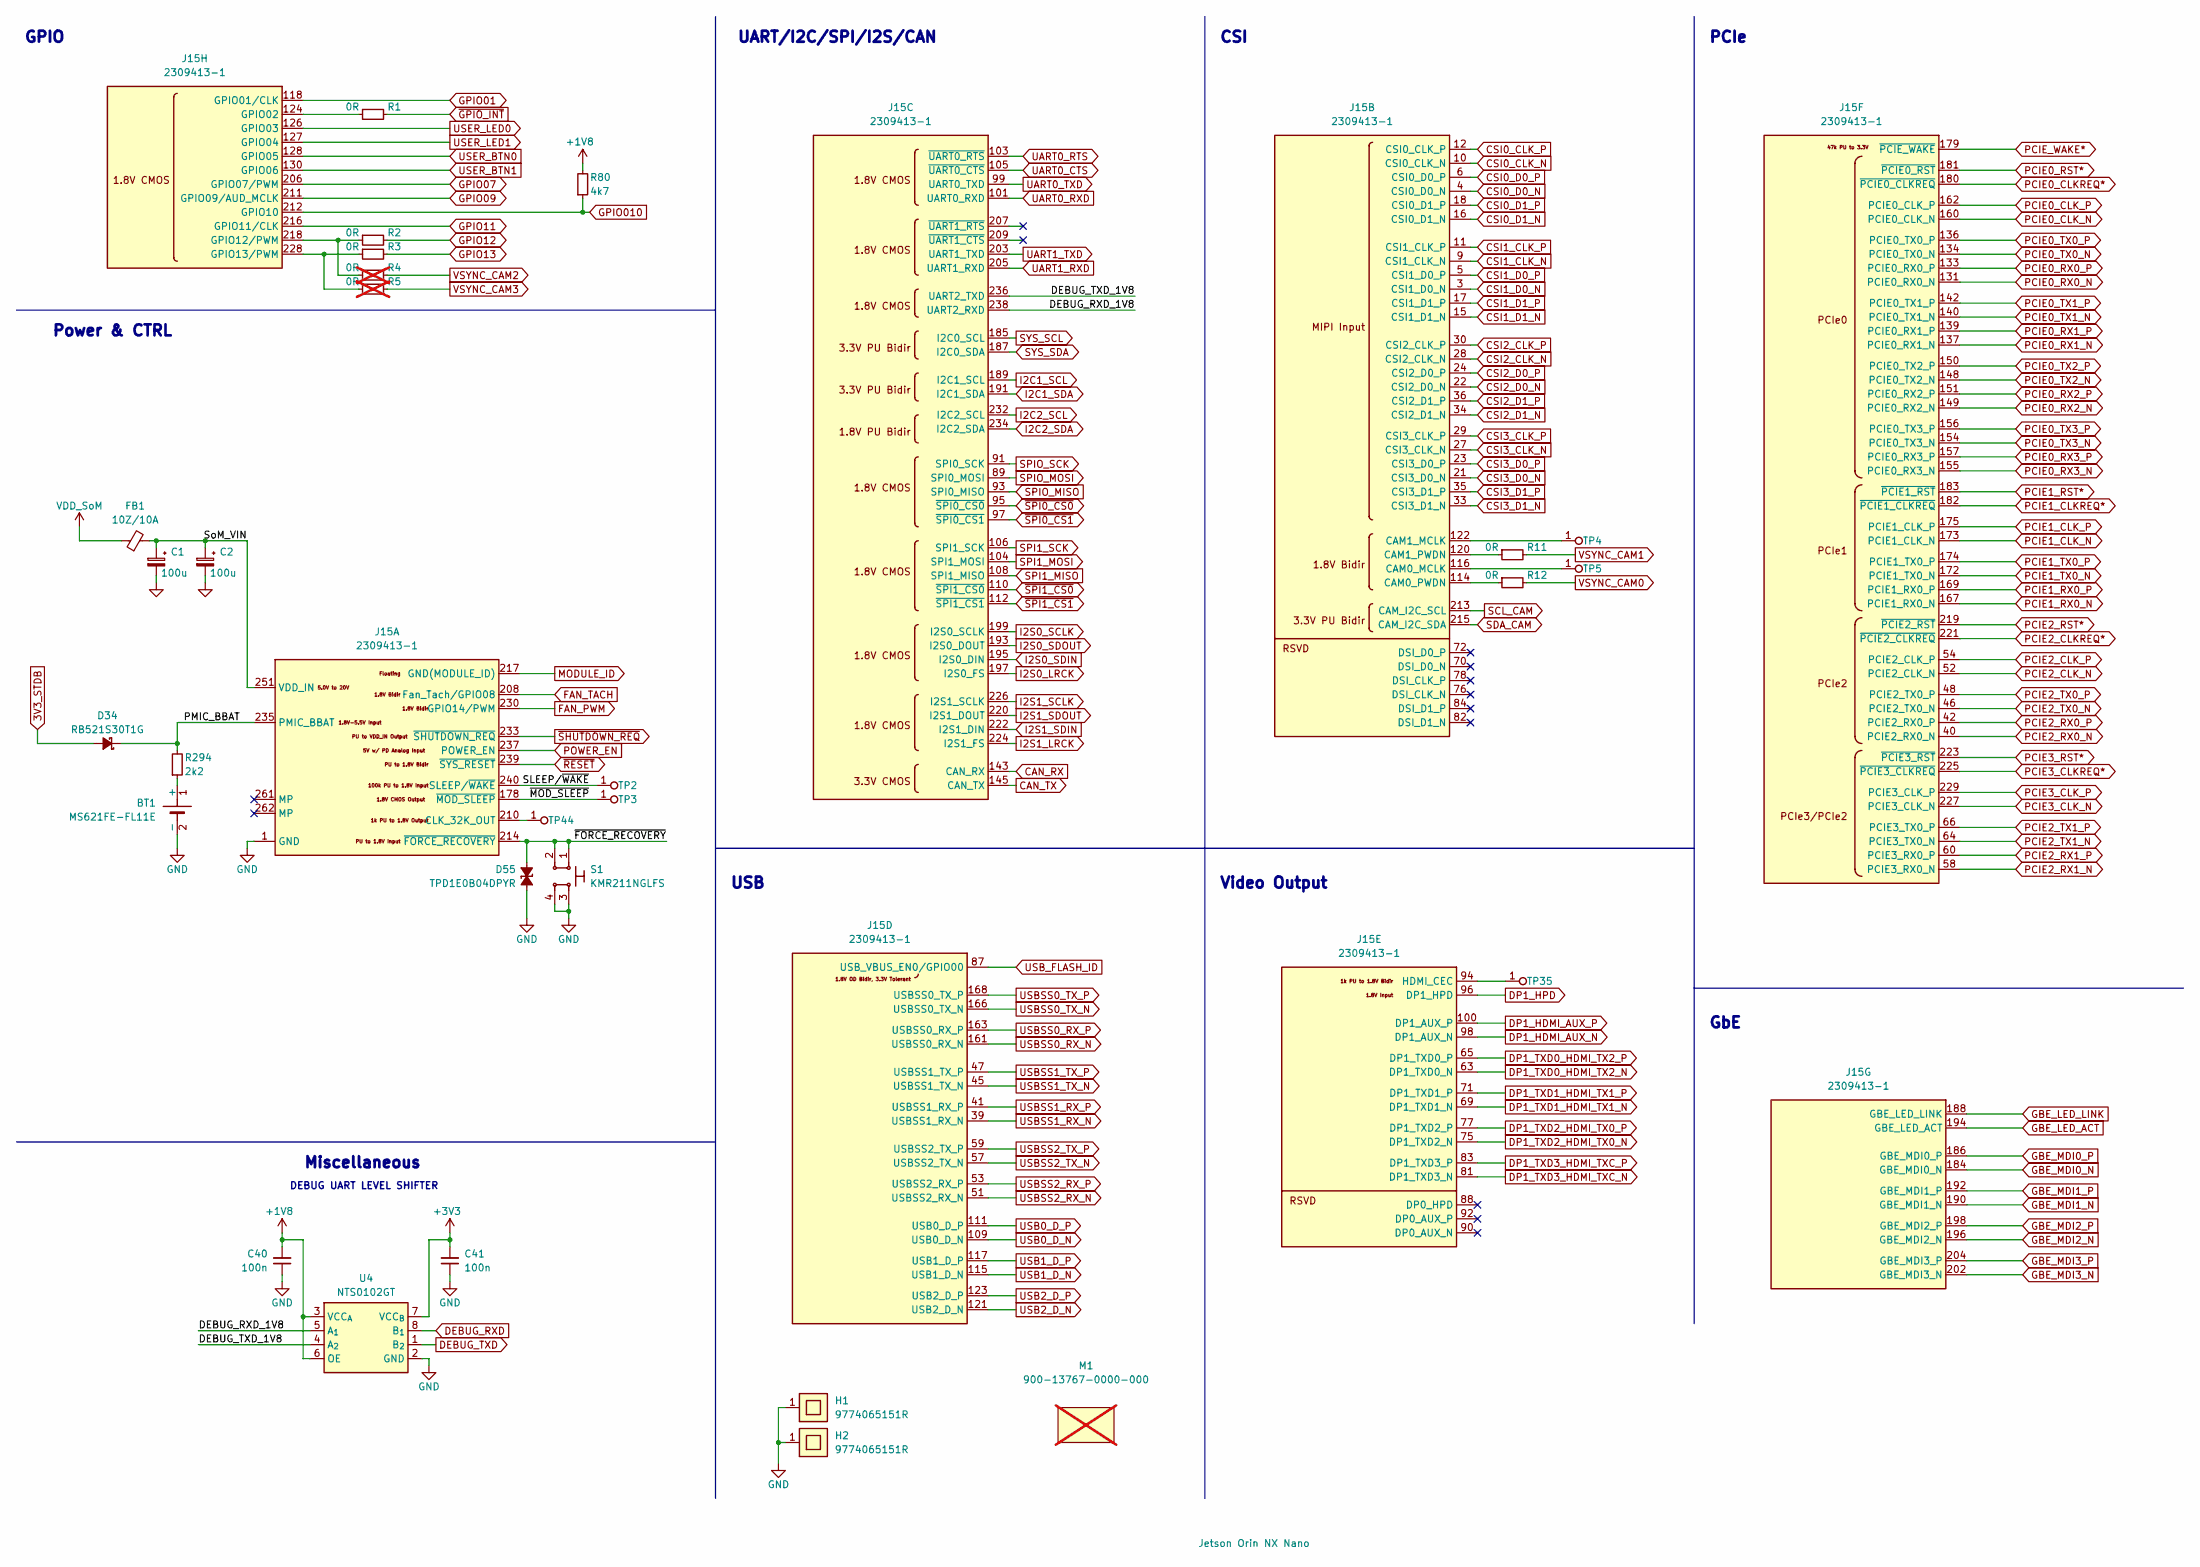
[picture p53: schematic som.kicad_sch]

Parts:
BT1: Battery_Holder_MS621FE-FL11E; MS621FE-FL11E; MPN MS621FE-FL11E; Digikey Part # 728-1057-ND
C1, C2: C_Pol_100u_25V_KEMET-T521-D-107; C_Pol_EIA-X; Voltage 25V; MPN T521D107M025ATE040; LCSC Part # C696814
C40, C41: C_100n_0402; C_0402_1005Metric; Voltage 50V; MPN GRM155R61H104KE14D; LCSC Part # C85960
D34: RB521S30T1G; SOD-523; MPN RB521S30T1G; LCSC Part # C145179
D55: TPD1E0B04_XDFN-2; XDFN-2_1x0.60mm; MPN TPD1E0B04DPYR; LCSC Part # C5182093
FB1: FB_10Z_10A_WE-MPSB_1206; FB_1206_3216Metric; MPN 74279221100; Digikey Part # 732-6128-1-ND
H1, H2: Spacer_Drill3.7mm_H6.5mm_9774065151R; MPN 9774065151R; Digikey Part # 732-9774065151RCT-ND
J15: Bus_DDR4_SODIMM_CUSTOM_Jetson-Orin-H9.2mm-socket; TE_2309413; MPN 2309413-1; LCSC Part # C2766246
M1: Jetson-Orin-NX-Nano; Module_Jetson-Orin-NX-Nano; MPN 900-13767-0000-000; not fitted
R1, R2, R3, R11, R12: R_0R_0402; R_0402_1005Metric; MPN ERJ2GE0R00X; LCSC Part # C242160
R4, R5: R_0R_0402; R_0402_1005Metric; MPN ERJ2GE0R00X; LCSC Part # C242160; not fitted
R80: R_4k7_0402; R_0402_1005Metric; Tolerance 1%; MPN CR0402-FX-4701GLF; LCSC Part # C2076851
R294: R_2k2_0402; R_0402_1005Metric; Tolerance 1%; MPN CR0402-FX-2201GLF; LCSC Part # C2076845
S1: SW_KMR211NGLFS_SMD; MPN KMR211NGLFS; LCSC Part # C221676
TP2, TP3, TP4, TP5, TP35, TP44: TP_0.75mm_SMD; TP_SMD_0.75mm
U4: NTS0102_XSON; XSON-8_1x1.95mm_P0.5mm; MPN NTS0102GT; LCSC Part # C2687851

Connections:
3V3_STDB: D34.2 (A)
+1V8: C40.2, R80.2, U4.3 (VCC_{A}), U4.6 (OE)
+3V3: C41.2, U4.7 (VCC_{B})
CAN_RX: J15.143 (CAN_RX)
CAN_TX: J15.145 (CAN_TX)
CSI0_CLK_N: J15.10 (CSI0_CLK_N)
CSI0_CLK_P: J15.12 (CSI0_CLK_P)
CSI0_D0_N: J15.4 (CSI0_D0_N)
CSI0_D0_P: J15.6 (CSI0_D0_P)
CSI0_D1_N: J15.16 (CSI0_D1_N)
CSI0_D1_P: J15.18 (CSI0_D1_P)
CSI1_CLK_N: J15.9 (CSI1_CLK_N)
CSI1_CLK_P: J15.11 (CSI1_CLK_P)
CSI1_D0_N: J15.3 (CSI1_D0_N)
CSI1_D0_P: J15.5 (CSI1_D0_P)
CSI1_D1_N: J15.15 (CSI1_D1_N)
CSI1_D1_P: J15.17 (CSI1_D1_P)
CSI2_CLK_N: J15.28 (CSI2_CLK_N)
CSI2_CLK_P: J15.30 (CSI2_CLK_P)
CSI2_D0_N: J15.22 (CSI2_D0_N)
CSI2_D0_P: J15.24 (CSI2_D0_P)
CSI2_D1_N: J15.34 (CSI2_D1_N)
CSI2_D1_P: J15.36 (CSI2_D1_P)
CSI3_CLK_N: J15.27 (CSI3_CLK_N)
CSI3_CLK_P: J15.29 (CSI3_CLK_P)
CSI3_D0_N: J15.21 (CSI3_D0_N)
CSI3_D0_P: J15.23 (CSI3_D0_P)
CSI3_D1_N: J15.33 (CSI3_D1_N)
CSI3_D1_P: J15.35 (CSI3_D1_P)
DEBUG_RXD: U4.8 (B_{1})
DEBUG_RXD_1V8: J15.238 (UART2_RXD), U4.5 (A_{1})
DEBUG_TXD: U4.1 (B_{2})
DEBUG_TXD_1V8: J15.236 (UART2_TXD), U4.4 (A_{2})
DP1_HDMI_AUX_N: J15.98 (DP1_AUX_N)
DP1_HDMI_AUX_P: J15.100 (DP1_AUX_P)
DP1_HPD: J15.96 (DP1_HPD)
DP1_TXD0_HDMI_TX2_N: J15.63 (DP1_TXD0_N)
DP1_TXD0_HDMI_TX2_P: J15.65 (DP1_TXD0_P)
DP1_TXD1_HDMI_TX1_N: J15.69 (DP1_TXD1_N)
DP1_TXD1_HDMI_TX1_P: J15.71 (DP1_TXD1_P)
DP1_TXD2_HDMI_TX0_N: J15.75 (DP1_TXD2_N)
DP1_TXD2_HDMI_TX0_P: J15.77 (DP1_TXD2_P)
DP1_TXD3_HDMI_TXC_N: J15.81 (DP1_TXD3_N)
DP1_TXD3_HDMI_TXC_P: J15.83 (DP1_TXD3_P)
FAN_PWM: J15.230 (GPIO14/PWM)
FAN_TACH: J15.208 (Fan_Tach/GPIO08)
GBE_LED_ACT: J15.194 (GBE_LED_ACT)
GBE_LED_LINK: J15.188 (GBE_LED_LINK)
GBE_MDI0_N: J15.184 (GBE_MDI0_N)
GBE_MDI0_P: J15.186 (GBE_MDI0_P)
GBE_MDI1_N: J15.190 (GBE_MDI1_N)
GBE_MDI1_P: J15.192 (GBE_MDI1_P)
GBE_MDI2_N: J15.196 (GBE_MDI2_N)
GBE_MDI2_P: J15.198 (GBE_MDI2_P)
GBE_MDI3_N: J15.202 (GBE_MDI3_N)
GBE_MDI3_P: J15.204 (GBE_MDI3_P)
GND: BT1.2 (-), C1.2, C2.2, C40.1, C41.1, D55.1 (C), H1.1, H2.1, J15.1 (GND), J15.2 (GND), J15.7 (GND), J15.8 (GND), J15.13 (GND), J15.14 (GND), J15.19 (GND), J15.20 (GND), J15.25 (GND), J15.26 (GND), J15.31 (GND), J15.32 (GND), J15.37 (GND), J15.38 (GND), J15.43 (GND), J15.44 (GND), J15.49 (GND), J15.50 (GND), J15.55 (GND), J15.56 (GND), J15.61 (GND), J15.62 (GND), J15.67 (GND), J15.68 (GND), J15.73 (GND), J15.74 (GND), J15.79 (GND), J15.80 (GND), J15.85 (GND), J15.86 (GND), J15.102 (GND), J15.107 (GND), J15.113 (GND), J15.119 (GND), J15.125 (GND), J15.129 (GND), J15.132 (GND), J15.135 (GND), J15.138 (GND), J15.141 (GND), J15.144 (GND), J15.146 (GND), J15.147 (GND), J15.152 (GND), J15.153 (GND), J15.158 (GND), J15.159 (GND), J15.164 (GND), J15.165 (GND), J15.170 (GND), J15.171 (GND), J15.176 (GND), J15.177 (GND), J15.200 (GND), J15.201 (GND), J15.231 (GND), J15.241 (GND), J15.242 (GND), J15.243 (GND), J15.244 (GND), J15.245 (GND), J15.246 (GND), J15.247 (GND), J15.248 (GND), J15.249 (GND), J15.250 (GND), S1.3, S1.4, U4.2 (GND)
GPIO01: J15.118 (GPIO01/CLK)
GPIO07: J15.206 (GPIO07/PWM)
GPIO09: J15.211 (GPIO09/AUD_MCLK)
GPIO010: J15.212 (GPIO10), R80.1
GPIO11: J15.216 (GPIO11/CLK)
GPIO12: R2.2
GPIO13: R3.2
I2C1_SCL: J15.189 (I2C1_SCL)
I2C1_SDA: J15.191 (I2C1_SDA)
I2C2_SCL: J15.232 (I2C2_SCL)
I2C2_SDA: J15.234 (I2C2_SDA)
I2S0_LRCK: J15.197 (I2S0_FS)
I2S0_SCLK: J15.199 (I2S0_SCLK)
I2S0_SDIN: J15.195 (I2S0_DIN)
I2S0_SDOUT: J15.193 (I2S0_DOUT)
I2S1_LRCK: J15.224 (I2S1_FS)
I2S1_SCLK: J15.226 (I2S1_SCLK)
I2S1_SDIN: J15.222 (I2S1_DIN)
I2S1_SDOUT: J15.220 (I2S1_DOUT)
MODULE_ID: J15.217 (GND(MODULE_ID))
unnamed: BT1.1 (+), R294.1
unnamed: J15.94 (HDMI_CEC), TP35.1
unnamed: J15.114 (CAM0_PWDN), R12.1
unnamed: J15.116 (CAM0_MCLK), TP5.1
unnamed: J15.120 (CAM1_PWDN), R11.1
unnamed: J15.122 (CAM1_MCLK), TP4.1
unnamed: J15.124 (GPIO02), R1.1
unnamed: J15.210 (CLK_32K_OUT), TP44.1
unnamed: J15.218 (GPIO12/PWM), R2.1, R4.1
unnamed: J15.228 (GPIO13/PWM), R3.1, R5.1
PCIE0_CLKREQ*: J15.180 (~PCIE0_CLKREQ)
PCIE0_CLK_N: J15.160 (PCIE0_CLK_N)
PCIE0_CLK_P: J15.162 (PCIE0_CLK_P)
PCIE0_RST*: J15.181 (~PCIE0_RST)
PCIE0_RX0_N: J15.131 (PCIE0_RX0_N)
PCIE0_RX0_P: J15.133 (PCIE0_RX0_P)
PCIE0_RX1_N: J15.137 (PCIE0_RX1_N)
PCIE0_RX1_P: J15.139 (PCIE0_RX1_P)
PCIE0_RX2_N: J15.149 (PCIE0_RX2_N)
PCIE0_RX2_P: J15.151 (PCIE0_RX2_P)
PCIE0_RX3_N: J15.155 (PCIE0_RX3_N)
PCIE0_RX3_P: J15.157 (PCIE0_RX3_P)
PCIE0_TX0_N: J15.134 (PCIE0_TX0_N)
PCIE0_TX0_P: J15.136 (PCIE0_TX0_P)
PCIE0_TX1_N: J15.140 (PCIE0_TX1_N)
PCIE0_TX1_P: J15.142 (PCIE0_TX1_P)
PCIE0_TX2_N: J15.148 (PCIE0_TX2_N)
PCIE0_TX2_P: J15.150 (PCIE0_TX2_P)
PCIE0_TX3_N: J15.154 (PCIE0_TX3_N)
PCIE0_TX3_P: J15.156 (PCIE0_TX3_P)
PCIE1_CLKREQ*: J15.182 (~PCIE1_CLKREQ)
PCIE1_CLK_N: J15.173 (PCIE1_CLK_N)
PCIE1_CLK_P: J15.175 (PCIE1_CLK_P)
PCIE1_RST*: J15.183 (~PCIE1_RST)
PCIE1_RX0_N: J15.167 (PCIE1_RX0_N)
PCIE1_RX0_P: J15.169 (PCIE1_RX0_P)
PCIE1_TX0_N: J15.172 (PCIE1_TX0_N)
PCIE1_TX0_P: J15.174 (PCIE1_TX0_P)
PCIE2_CLKREQ*: J15.221 (~PCIE2_CLKREQ)
PCIE2_CLK_N: J15.52 (PCIE2_CLK_N)
PCIE2_CLK_P: J15.54 (PCIE2_CLK_P)
PCIE2_RST*: J15.219 (~PCIE2_RST)
PCIE2_RX0_N: J15.40 (PCIE2_RX0_N)
PCIE2_RX0_P: J15.42 (PCIE2_RX0_P)
PCIE2_RX1_N: J15.58 (PCIE3_RX0_N)
PCIE2_RX1_P: J15.60 (PCIE3_RX0_P)
PCIE2_TX0_N: J15.46 (PCIE2_TX0_N)
PCIE2_TX0_P: J15.48 (PCIE2_TX0_P)
PCIE2_TX1_N: J15.64 (PCIE3_TX0_N)
PCIE2_TX1_P: J15.66 (PCIE3_TX0_P)
PCIE3_CLKREQ*: J15.225 (~PCIE3_CLKREQ)
PCIE3_CLK_N: J15.227 (PCIE3_CLK_N)
PCIE3_CLK_P: J15.229 (PCIE3_CLK_P)
PCIE3_RST*: J15.223 (~PCIE3_RST)
PCIE_WAKE*: J15.179 (~PCIE_WAKE)
PMIC_BBAT: D34.1 (C), J15.235 (PMIC_BBAT), R294.2
POWER_EN: J15.237 (POWER_EN)
SCL_CAM: J15.213 (CAM_I2C_SCL)
SDA_CAM: J15.215 (CAM_I2C_SDA)
SLEEP/~WAKE: J15.240 (SLEEP/~WAKE), TP2.1
SPI1_MISO: J15.108 (SPI1_MISO)
SPI1_MOSI: J15.104 (SPI1_MOSI)
SPI1_SCK: J15.106 (SPI1_SCK)
SPIO_MISO: J15.93 (SPI0_MISO)
SPIO_MOSI: J15.89 (SPI0_MOSI)
SPIO_SCK: J15.91 (SPI0_SCK)
SYS_SCL: J15.185 (I2C0_SCL)
SYS_SDA: J15.187 (I2C0_SDA)
SoM_VIN: C1.1, C2.1, FB1.2, J15.251 (VDD_IN), J15.252 (VDD_IN), J15.253 (VDD_IN), J15.254 (VDD_IN), J15.255 (VDD_IN), J15.256 (VDD_IN), J15.257 (VDD_IN), J15.258 (VDD_IN), J15.259 (VDD_IN), J15.260 (VDD_IN)
UART0_CTS: J15.105 (~UART0_CTS)
UART0_RTS: J15.103 (~UART0_RTS)
UART0_RXD: J15.101 (UART0_RXD)
UART0_TXD: J15.99 (UART0_TXD)
UART1_RXD: J15.205 (UART1_RXD)
UART1_TXD: J15.203 (UART1_TXD)
USB0_D_N: J15.109 (USB0_D_N)
USB0_D_P: J15.111 (USB0_D_P)
USB1_D_N: J15.115 (USB1_D_N)
USB1_D_P: J15.117 (USB1_D_P)
USB2_D_N: J15.121 (USB2_D_N)
USB2_D_P: J15.123 (USB2_D_P)
USBSS0_RX_N: J15.161 (USBSS0_RX_N)
USBSS0_RX_P: J15.163 (USBSS0_RX_P)
USBSS0_TX_N: J15.166 (USBSS0_TX_N)
USBSS0_TX_P: J15.168 (USBSS0_TX_P)
USBSS1_RX_N: J15.39 (USBSS1_RX_N)
USBSS1_RX_P: J15.41 (USBSS1_RX_P)
USBSS1_TX_N: J15.45 (USBSS1_TX_N)
USBSS1_TX_P: J15.47 (USBSS1_TX_P)
USBSS2_RX_N: J15.51 (USBSS2_RX_N)
USBSS2_RX_P: J15.53 (USBSS2_RX_P)
USBSS2_TX_N: J15.57 (USBSS2_TX_N)
USBSS2_TX_P: J15.59 (USBSS2_TX_P)
USB_FLASH_ID: J15.87 (USB_VBUS_EN0/GPIO00)
USER_BTN0: J15.128 (GPIO05)
USER_BTN1: J15.130 (GPIO06)
USER_LED0: J15.126 (GPIO03)
USER_LED1: J15.127 (GPIO04)
VDD_SoM: FB1.1
VSYNC_CAM0: R12.2
VSYNC_CAM1: R11.2
VSYNC_CAM2: R4.2
VSYNC_CAM3: R5.2
~FORCE_RECOVERY: D55.2 (A), J15.214 (~FORCE_RECOVERY), S1.1, S1.2
~GPIO_INT: R1.2
~MOD_SLEEP: J15.178 (~MOD_SLEEP), TP3.1
~RESET: J15.239 (~SYS_RESET)
~SHUTDOWN_REQ: J15.233 (~SHUTDOWN_REQ)
~SPI0_CS0: J15.95 (~SPI0_CS0)
~SPI0_CS1: J15.97 (~SPI0_CS1)
~SPI1_CS0: J15.110 (~SPI1_CS0)
~SPI1_CS1: J15.112 (~SPI1_CS1)

Notes on the sheet:
DEBUG UART LEVEL SHIFTER
CSI
Video Output
Power & CTRL
UART/I2C/SPI/I2S/CAN
PCIe
GbE
USB
GPIO
Miscellaneous
