HW-Lab-Hardware-Design-Agency/jetson-orin-baseboard/supply.kicad_sch

## KiCad design supply.kicad_sch (2025-10-24)

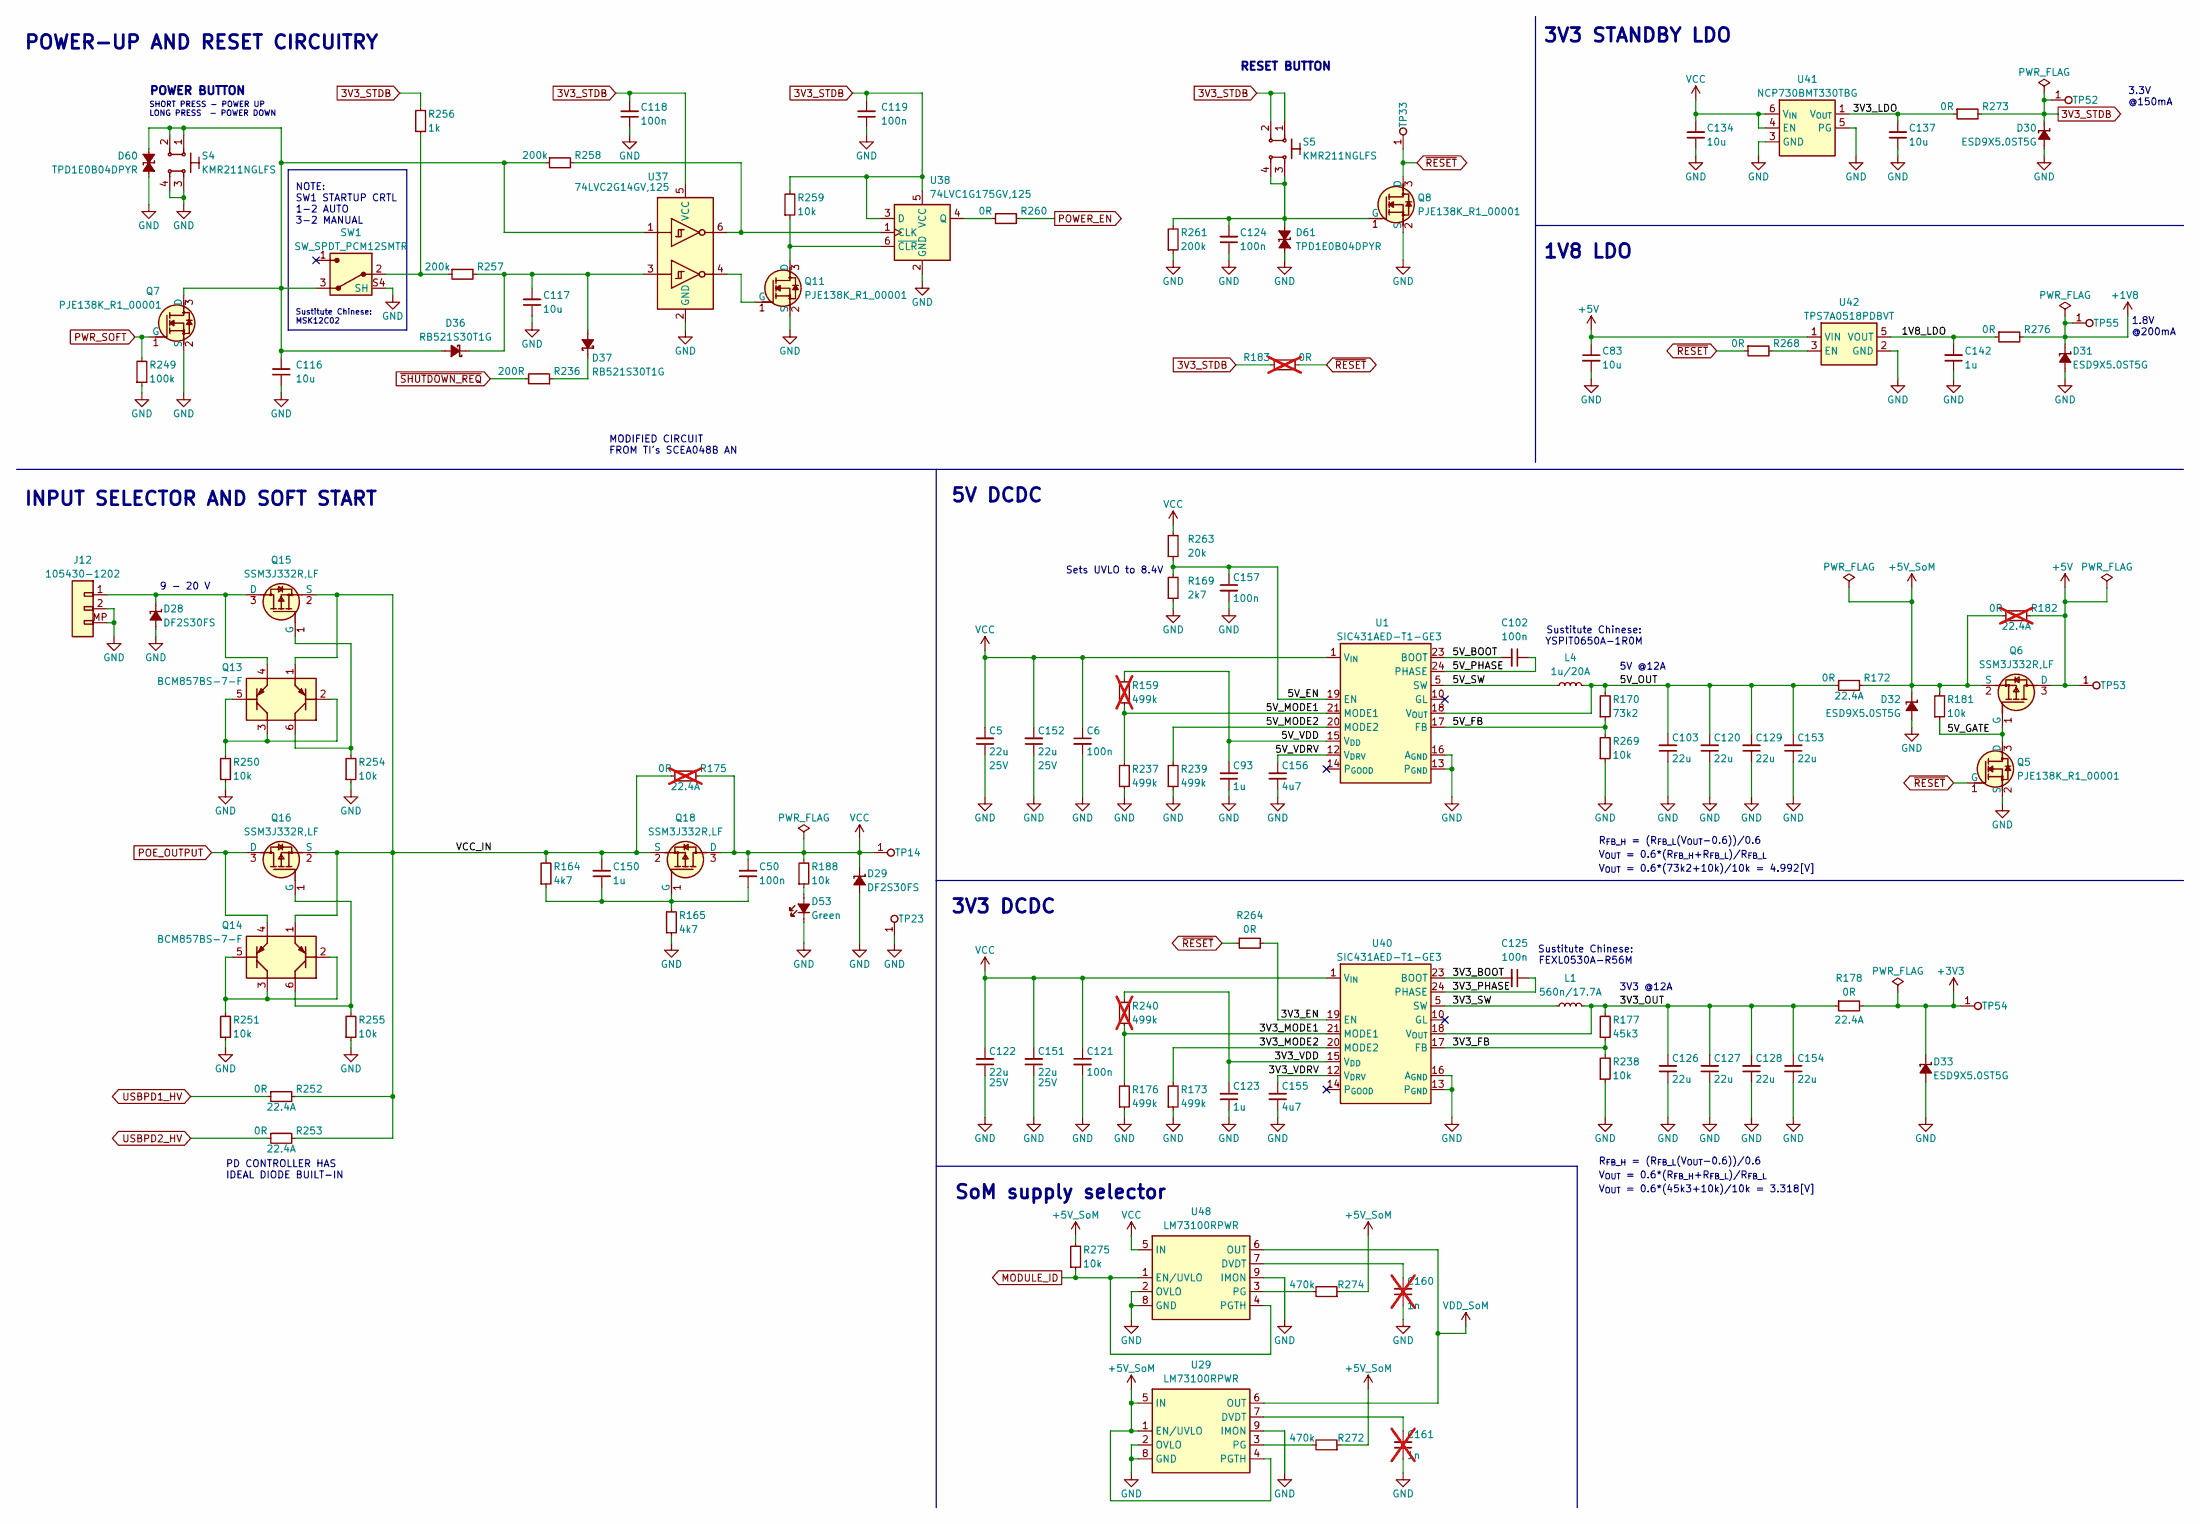
[picture p54: schematic supply.kicad_sch]

Parts:
C5, C122, C151, C152: C_22u_25V_0805; C_0805_2012Metric; Voltage 25V; MPN CL21A226MAYNNNE; LCSC Part # C602037
C6, C50, C102, C118, C119, C121, C124, C125, C157: C_100n_0402; C_0402_1005Metric; Voltage 50V; MPN GRM155R61H104KE14D; LCSC Part # C85960
C83, C116, C117, C137: C_10u_0402; C_0402_1005Metric; MPN CC0402MRX5R5BB106; LCSC Part # C105884
C93, C123, C142: C_1u_0402; C_0402_1005Metric; MPN C1005X6S1A105K050BC; LCSC Part # C2182694
C103, C120, C126, C127, C128, C129, C153, C154: C_22u_16V_0603; C_0603_1608Metric_EIA; Voltage 16V; MPN CL10A226MO7JZNC; LCSC Part # C2762594
C134: C_10u_25V_0603; C_0603_1608Metric; Voltage 25V; MPN C1608X5R1E106M080AC; LCSC Part # C2168289
C150: C_1u_25V_0402; C_0402_1005Metric; Voltage 25V; MPN GRM155R61E105KE11J; LCSC Part # C3898487
C155, C156: C_4u7_25V_0402; C_0402_1005Metric; Voltage 25V; MPN GRM155C61E475ME15J; LCSC Part # C5846150
C160: C_1n_0402; C_0402_1005Metric; Voltage 50V; MPN GRM1555C1H102JA01D; LCSC Part # C76947; not fitted
C161: C_1n_16V_X7R_0402; C_0402_1005Metric; Voltage 16V; MPN C0402C102J4RACTU; LCSC Part # C2168471; not fitted
D28, D29: DF2S30FS_SOD; SOD-923; MPN DF2S30FS; LCSC Part # C1973663
D30, D31, D32, D33: ESD9X5.0ST5G; SOD-923; MPN ESD9X5.0ST5G; LCSC Part # C41364466
D36, D37: RB521S30T1G; SOD-523; MPN RB521S30T1G; LCSC Part # C145179
D53: LED_G_0603_LTST-C190GKT; LED_0603_1608Metric_G; MPN LTST-C190GKT; LCSC Part # C125093
D60, D61: TPD1E0B04_XDFN-2; XDFN-2_1x0.60mm; MPN TPD1E0B04DPYR; LCSC Part # C5182093
J12: Molex_Nano-Fit_1x2_SMD_1054301202; Conn_Molex_Nano-Fit_1x2_SMD_1054301202; MPN 105430-1202; LCSC Part # C7436819
L1: L_560n_17.7A_Bourns-SRP5030CA; L_Bourns-SRP5030CA; MPN SRP5030CA-R56M; LCSC Part # C2049215
L4: L_1u_20A_Bourns-SRP6050CA; L_Bourns-SRP6050CA; MPN SRP6050CA-1R0M; LCSC Part # C2047688
Q5, Q7, Q8, Q11: PJE138K; SOT-523; MPN PJE138K_R1_00001; LCSC Part # C391643
Q6, Q15, Q16, Q18: SSM3J332R; SOT-23-3; MPN SSM3J332R,LF; LCSC Part # C146367
Q13, Q14: BCM857BS-7-F; SOT-363; MPN BCM857BS-7-F; LCSC Part # C105896
R159, R240: R_499k_0402; R_0402_1005Metric; Tolerance 1%; MPN CR0402-FX-4993GLF; LCSC Part # C2085386; not fitted
R164, R165: R_4k7_0402; R_0402_1005Metric; Tolerance 1%; MPN CR0402-FX-4701GLF; LCSC Part # C2076851
R169: R_2k7_0402; R_0402_1005Metric; Tolerance 1%; MPN CR0402-FX-2701GLF; LCSC Part # C19946434
R170: R_73k2_0402; R_0402_1005Metric; Tolerance 1%; MPN CR0402-FX-7322GLF; Digikey Part # 118-CR0402-FX-7322GLFCT-ND
R172, R178, R252, R253: R_0R_22.4A_0603; R_0603_1608Metric; Tolerance template_tolerance; MPN PMR03EZPJ000; LCSC Part # C253507
R173, R176, R237, R239: R_499k_0402; R_0402_1005Metric; Tolerance 1%; MPN CR0402-FX-4993GLF; LCSC Part # C2085386
R175, R182: R_0R_22.4A_0603; R_0603_1608Metric; Tolerance template_tolerance; MPN PMR03EZPJ000; LCSC Part # C253507; not fitted
R177: R_45k3_0402; R_0402_1005Metric; Tolerance 1%; MPN CR0402-FX-4532GLF; LCSC Part # C2085419
R181, R188, R238, R250, R251, R254, R255, R259, R269, R275: R_10k_0402; R_0402_1005Metric; Tolerance 1%; MPN CR0402-FX-1002GLF; LCSC Part # C202396
R183: R_0R_0402; R_0402_1005Metric; MPN ERJ2GE0R00X; LCSC Part # C242160; not fitted
R236: R_200R_0402; R_0402_1005Metric; Tolerance 1%; MPN CR0402-FX-2000GLF; LCSC Part # C19946422
R249: R_100k_0402; R_0402_1005Metric; Tolerance 1%; MPN CR0402-FX-1003GLF; LCSC Part # C2077080
R256: R_1k_0402; R_0402_1005Metric; Tolerance 1%; MPN CR0402-FX-1001GLF; LCSC Part # C202394
R257, R258, R261: R_200k_0402; R_0402_1005Metric; Tolerance 1%; MPN CR0402-FX-2003GLF; LCSC Part # C2077217
R260, R264, R268: R_0R_0402; R_0402_1005Metric; MPN ERJ2GE0R00X; LCSC Part # C242160
R263: R_20k_0402; R_0402_1005Metric; Tolerance 1%; MPN CR0402-FX-2002GLF; LCSC Part # C2077214
R272, R274: R_470k_0402; R_0402_1005Metric; Tolerance 1%; MPN CR0402-FX-4703GLF; LCSC Part # C2085488
R273, R276: R_0R_0603; R_0603_1608Metric; MPN CR0603-J/-000ELF; LCSC Part # C512908
S4, S5: SW_KMR211NGLFS_SMD; MPN KMR211NGLFS; LCSC Part # C221676
SW1: SW_SPDT_PCM12SMTR; PCM12SMTR; MPN PCM12SMTR; LCSC Part # C221841
TP14, TP23, TP33, TP52, TP53, TP54, TP55: TP_0.75mm_SMD; TP_SMD_0.75mm
U1, U40: SIC431AED-T1-GE3; MLP44-24L_4x4x0.75mm; MPN SIC431AED-T1-GE3; LCSC Part # C2071422
U29, U48: LM73100; VQFN-HR-10_2x2mm; MPN LM73100RPWR; LCSC Part # C3210761
U37: 74LVC2G14_SOT457; SOT-23-6; MPN 74LVC2G14GV,125; LCSC Part # C426708
U38: 74LVC1G175_SOT457; SOT-23-6; MPN 74LVC1G175GV,125; LCSC Part # C548290
U41: NCP730BMT330_WSON; WSON-6-1EP_2x2mm_P0.65mm; MPN NCP730BMT330TBG; LCSC Part # C892821
U42: TPS7A0518P_SOT23-5; SOT-23-5; MPN TPS7A0518PDBVT; LCSC Part # C3752282

Connections:
1V8_LDO: C142.2, R276.1, U42.5 (VOUT)
3V3_BOOT: C125.2, U40.23 (BOOT)
3V3_EN: R264.2, U40.19 (EN)
3V3_FB: R177.1, R238.2, U40.17 (FB)
3V3_LDO: C137.2, R273.1, U41.1 (V_{OUT})
3V3_MODE1: R176.2, R240.1, U40.21 (MODE1)
3V3_MODE2: R173.2, U40.20 (MODE2)
3V3_OUT: C126.2, C127.2, C128.2, C154.2, L1.2, R177.2, R178.1, U40.18 (V_{OUT})
3V3_PHASE: C125.1, U40.24 (PHASE)
3V3_STDB: C118.2, C119.2, D30.1 (C), R183.2, R256.2, R259.2, R273.2, S5.1, S5.2, TP52.1, U37.5 (VCC), U38.3 (D), U38.5 (VCC)
3V3_SW: L1.1, U40.5 (SW), U40.6 (SW), U40.7 (SW), U40.8 (SW), U40.9 (SW)
3V3_VDD: C123.2, R240.2, U40.15 (V_{DD})
3V3_VDRV: C155.2, U40.12 (V_{DRV})
5V_BOOT: C102.2, U1.23 (BOOT)
5V_EN: C157.1, R169.2, R263.1, U1.19 (EN)
5V_FB: R170.1, R269.2, U1.17 (FB)
5V_GATE: Q5.3 (D), Q6.1 (G), R181.1
5V_MODE1: R159.1, R237.2, U1.21 (MODE1)
5V_MODE2: R239.2, U1.20 (MODE2)
5V_OUT: C103.2, C120.2, C129.2, C153.2, L4.2, R170.2, R172.1, U1.18 (V_{OUT})
5V_PHASE: C102.1, U1.24 (PHASE)
5V_SW: L4.1, U1.5 (SW), U1.6 (SW), U1.7 (SW), U1.8 (SW), U1.9 (SW)
5V_VDD: C93.2, R159.2, U1.15 (V_{DD})
5V_VDRV: C156.2, U1.12 (V_{DRV})
+1V8: D31.1 (C), R276.2, TP55.1
+3V3: D33.1 (C), R178.2, TP54.1
+5V: C83.1, Q6.3 (D), R182.2, TP53.1, U42.1 (VIN)
+5V_SoM: D32.1 (C), Q6.2 (S), R172.2, R181.2, R182.1, R272.1, R274.1, R275.2, U29.1 (EN/UVLO), U29.4 (PGTH), U29.5 (IN)
GND: C5.1, C6.2, C83.2, C93.1, C103.1, C116.1, C117.1, C118.1, C119.1, C120.1, C121.2, C122.1, C123.1, C124.1, C126.1, C127.1, C128.1, C129.1, C134.1, C137.1, C142.1, C151.1, C152.1, C153.1, C154.1, C155.1, C156.1, C157.2, C160.1, C161.1, D28.2 (A), D29.2 (A), D30.2 (A), D31.2 (A), D32.2 (A), D33.2 (A), D53.1 (C), D60.1 (C), D61.1 (C), J12.2, J12.MP, Q5.2 (S), Q7.2 (S), Q8.2 (S), Q11.2 (S), R165.1, R169.1, R173.1, R176.1, R237.1, R238.1, R239.1, R249.1, R250.1, R251.1, R254.1, R255.1, R261.1, R269.1, S4.3, S4.4, SW1.S1 (SH), SW1.S2 (SH), SW1.S3 (SH), SW1.S4 (SH), TP23.1, U1.3 (P_{GND}), U1.4 (P_{GND}), U1.13 (P_{GND}), U1.16 (A_{GND}), U1.25 (A_{GND}), U1.27 (P_{GND}), U29.2 (OVLO), U29.8 (GND), U29.9 (IMON), U37.2 (GND), U38.2 (GND), U40.3 (P_{GND}), U40.4 (P_{GND}), U40.13 (P_{GND}), U40.16 (A_{GND}), U40.25 (A_{GND}), U40.27 (P_{GND}), U41.3 (GND), U41.5 (PG), U41.7 (GND), U42.2 (GND), U48.2 (OVLO), U48.8 (GND), U48.9 (IMON)
MODULE_ID: R275.1, U48.1 (EN/UVLO), U48.4 (PGTH)
unnamed: C116.2, D36.2 (A), D60.2 (A), Q7.3 (D), R258.1, S4.1, S4.2, SW1.3, U37.1
unnamed: C117.2, D36.1 (C), D37.2 (A), R257.2, U37.3
unnamed: C124.2, D61.2 (A), Q8.1 (G), R261.2, S5.3, S5.4
unnamed: C50.1, C150.1, Q18.1 (G), R164.1, R165.2
unnamed: C160.2, U48.7 (DVDT)
unnamed: C161.2, U29.7 (DVDT)
unnamed: D28.1 (C), J12.1, Q13.4, Q15.3 (D)
unnamed: D37.1 (C), R236.1
unnamed: D53.2 (A), R188.1
unnamed: Q11.1 (G), U37.4
unnamed: Q11.3 (D), R259.1, U38.6 (~CLR)
unnamed: Q13.2, Q13.3, Q13.5, R250.2
unnamed: Q13.6, Q15.1 (G), R254.2
unnamed: Q14.2, Q14.3, Q14.5, R251.2
unnamed: Q14.6, Q16.1 (G), R255.2
unnamed: R256.1, R257.1, SW1.2
unnamed: R258.2, U37.6, U38.1 (CLK)
unnamed: R260.1, U38.4 (Q)
unnamed: R268.2, U42.3 (EN)
unnamed: R272.2, U29.3 (PG)
unnamed: R274.2, U48.3 (PG)
unnamed: U1.10 (GL), U1.11 (GL), U1.28 (GL)
unnamed: U40.10 (GL), U40.11 (GL), U40.28 (GL)
POE_OUTPUT: Q14.4, Q16.3 (D)
POWER_EN: R260.2
PWR_SOFT: Q7.1 (G), R249.2
USBPD1_HV: R252.1
USBPD2_HV: R253.1
VCC: C5.2, C6.1, C50.2, C121.1, C122.2, C134.2, C151.2, C152.2, D29.1 (C), Q18.3 (D), R175.2, R188.2, R263.2, TP14.1, U1.1 (V_{IN}), U1.2 (V_{IN}), U1.22 (V_{IN}), U1.26 (V_{IN}), U40.1 (V_{IN}), U40.2 (V_{IN}), U40.22 (V_{IN}), U40.26 (V_{IN}), U41.4 (EN), U41.6 (V_{IN}), U48.5 (IN)
VCC_IN: C150.2, Q13.1, Q14.1, Q15.2 (S), Q16.2 (S), Q18.2 (S), R164.2, R175.1, R252.2, R253.2
VDD_SoM: U29.6 (OUT), U48.6 (OUT)
~RESET: Q5.1 (G), Q8.3 (D), R183.1, R264.1, R268.1, TP33.1
~SHUTDOWN_REQ: R236.2

Notes on the sheet:
5V @12A
Sustitute Chinese: FEXL0530A-R56M
Sets UVLO to 8.4V
V_{OUT} = 0.6*(R_{FB_H}+R_{FB_L})/R_{FB_L}
3V3 STANDBY LDO
3.3V @150mA
MODIFIED CIRCUIT FROM TI's SCEA048B AN
1V8 LDO
R_{FB_H} = (R_{FB_L}(V_{OUT}-0.6))/0.6
SHORT PRESS - POWER UP LONG PRESS - POWER DOWN
5V DCDC
Sustitute Chinese: YSPIT0650A-1R0M
NOTE: SW1 STARTUP CRTL 1-2 AUTO 3-2 MANUAL
V_{OUT} = 0.6*(73k2+10k)/10k = 4.992[V]
V_{OUT} = 0.6*(45k3+10k)/10k = 3.318[V]
POWER BUTTON
POWER-UP AND RESET CIRCUITRY
3V3 @12A
9 - 20 V
3V3 DCDC
PD CONTROLLER HAS IDEAL DIODE BUILT-IN
INPUT SELECTOR AND SOFT START
Sustitute Chinese: MSK12C02
1.8V @200mA
SoM supply selector
RESET BUTTON
