HW-Lab-Hardware-Design-Agency/jetson-orin-baseboard/usb3.kicad_sch

## KiCad design usb3.kicad_sch (2025-10-24)

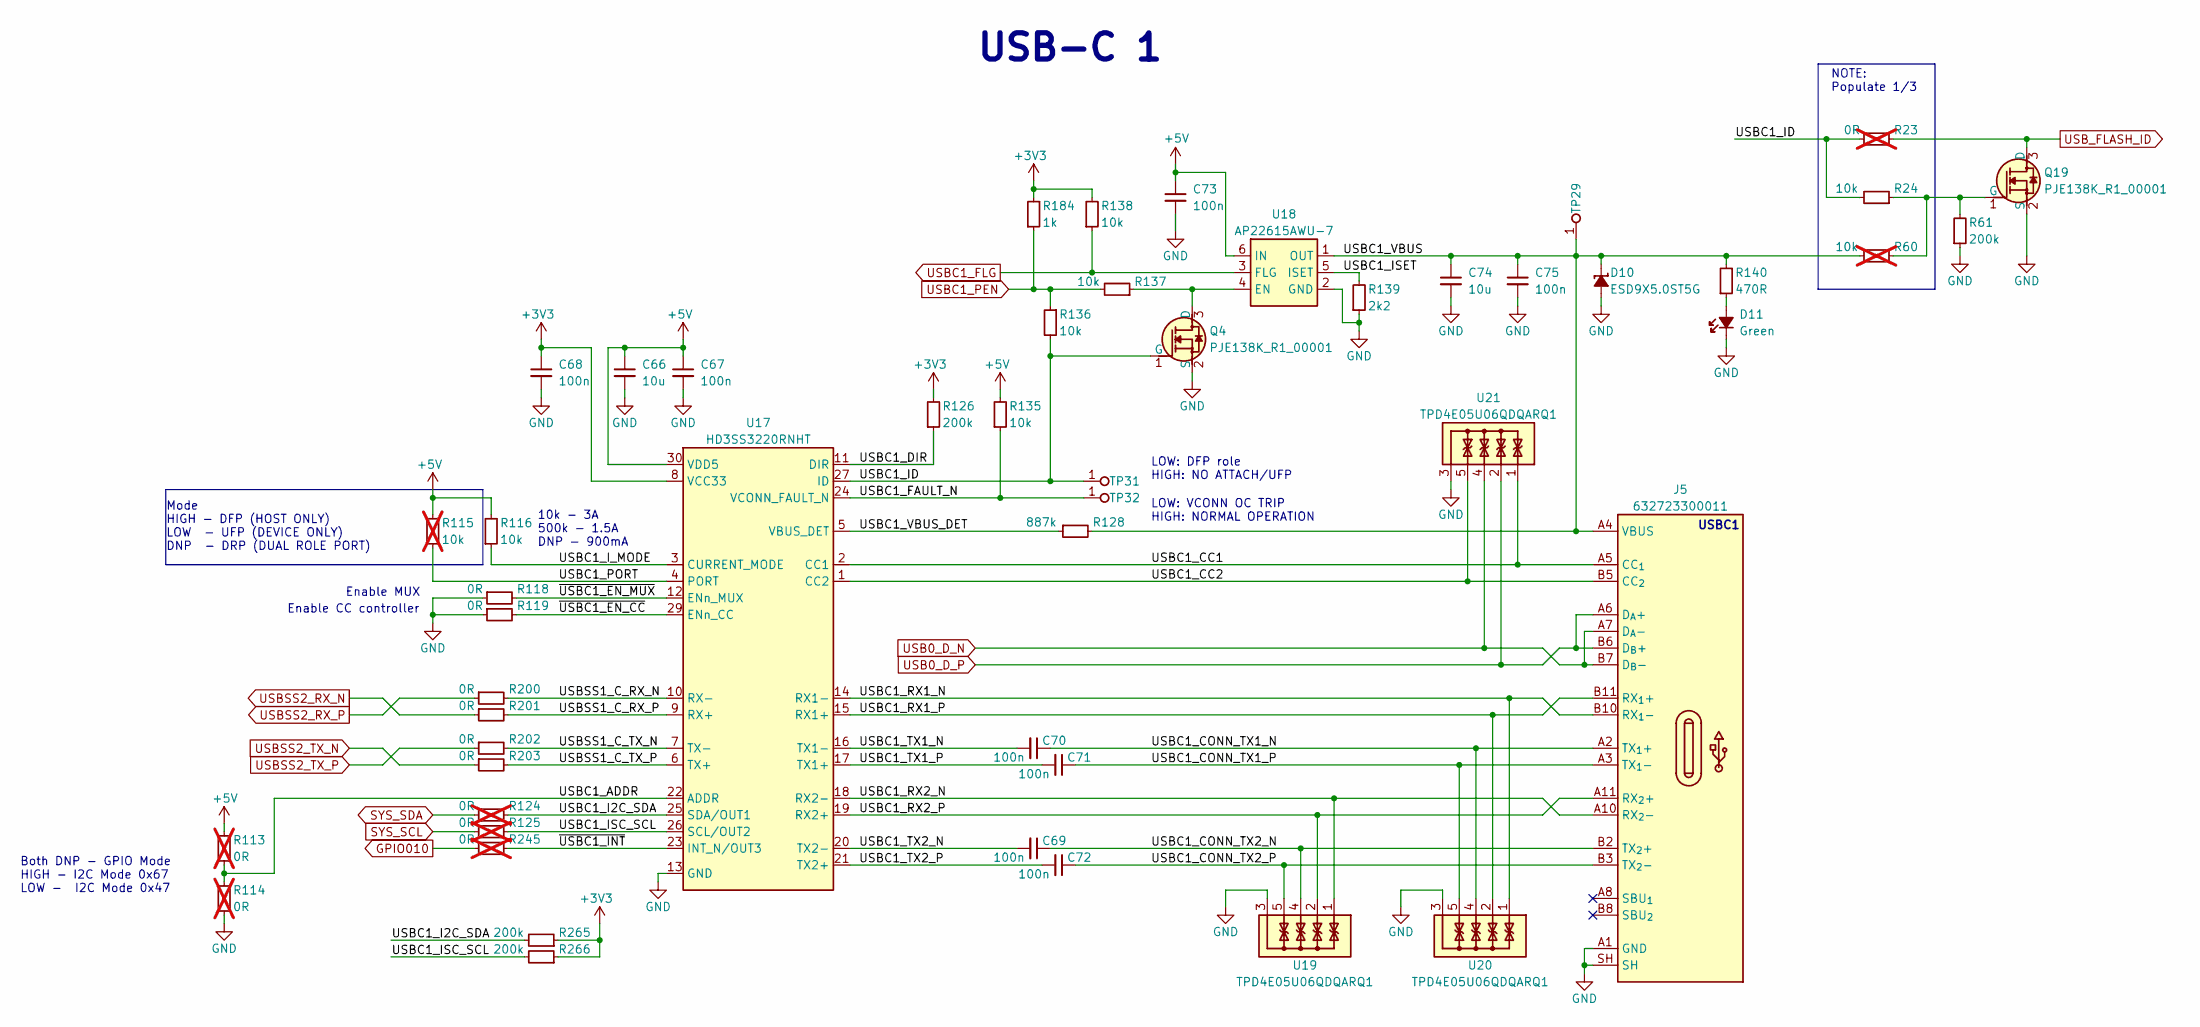
[picture p55: schematic usb3.kicad_sch]

Parts:
C66, C74: C_10u_0603; C_0603_1608Metric; MPN GRM188R61A106KE69D; LCSC Part # C77044
C67, C68, C69, C70, C71, C72, C73, C75: C_100n_0402; C_0402_1005Metric; Voltage 50V; MPN GRM155R61H104KE14D; LCSC Part # C85960
D10: ESD9X5.0ST5G; SOD-923; MPN ESD9X5.0ST5G; LCSC Part # C41364466
D11: LED_G_0603_LTST-C190GKT; LED_0603_1608Metric_G; MPN LTST-C190GKT; LCSC Part # C125093
J5: USB-C_WE_632723300011; USB-C_Receptacle_WE_632723300011; MPN 632723300011; Digikey Part # 732-9618-1-ND
Q4, Q19: PJE138K; SOT-523; MPN PJE138K_R1_00001; LCSC Part # C391643
R23, R113, R114, R124, R125, R245: R_0R_0402; R_0402_1005Metric; MPN ERJ2GE0R00X; LCSC Part # C242160; not fitted
R24, R116, R135, R136, R137, R138: R_10k_0402; R_0402_1005Metric; Tolerance 1%; MPN CR0402-FX-1002GLF; LCSC Part # C202396
R60, R115: R_10k_0402; R_0402_1005Metric; Tolerance 1%; MPN CR0402-FX-1002GLF; LCSC Part # C202396; not fitted
R61, R126, R265, R266: R_200k_0402; R_0402_1005Metric; Tolerance 1%; MPN CR0402-FX-2003GLF; LCSC Part # C2077217
R118, R119, R200, R201, R202, R203: R_0R_0402; R_0402_1005Metric; MPN ERJ2GE0R00X; LCSC Part # C242160
R128: R_887k_0402; R_0402_1005Metric; Tolerance 1%; MPN ERJ-2RKF8873X; LCSC Part # C409935
R139: R_2k2_0402; R_0402_1005Metric; Tolerance 1%; MPN CR0402-FX-2201GLF; LCSC Part # C2076845
R140: R_470R_0402; R_0402_1005Metric; Tolerance 1%; MPN CR0402-FX-4700GLF; LCSC Part # C2077077
R184: R_1k_0402; R_0402_1005Metric; Tolerance 1%; MPN CR0402-FX-1001GLF; LCSC Part # C202394
TP29, TP31, TP32: TP_0.75mm_SMD; TP_SMD_0.75mm
U17: HD3SS3220RNH; WQFN-30-1EP_4.6x2.6mm_P0.4mm; MPN HD3SS3220RNHT; LCSC Part # C2155924
U18: AP22615A_TSOT26; TSOT23-6; MPN AP22615AWU-7; LCSC Part # C2680357
U19, U20, U21: TPD4E05U06QDQARQ1; USON-10_2.5x1mm_P0.5mm; MPN TPD4E05U06QDQARQ1; LCSC Part # C81353

Connections:
+3V3: C68.1, R126.2, R138.2, R184.2, R265.1, R266.1, U17.8 (VCC33)
+5V: C66.1, C67.1, C73.1, R113.2, R115.1, R116.2, R135.2, U17.30 (VDD5), U18.6 (IN)
GND: C66.2, C67.2, C68.2, C73.2, C74.2, C75.2, D10.2 (A), D11.1 (C), J5.A1 (GND), J5.A12 (GND), J5.B1 (GND), J5.B12 (GND), J5.SH, Q4.2 (S), Q19.2 (S), R61.1, R114.1, R118.1, R119.1, R139.1, U17.13 (GND), U17.28 (GND), U17.31 (GND), U18.2 (GND), U19.3, U19.8, U20.3, U20.8, U21.3, U21.8
GPIO010: R245.1
unnamed: D11.2 (A), R140.1
unnamed: Q4.3 (D), R137.1, U18.4 (EN)
unnamed: Q19.1 (G), R24.1, R60.1, R61.2
SYS_SCL: R125.1
SYS_SDA: R124.1
USB0_D_N: J5.A7 (D_{A}-), J5.B7 (D_{B}-), U21.4, U21.7
USB0_D_P: J5.A6 (D_{A}+), J5.B6 (D_{B}+), U21.2, U21.9
USBC1_ADDR: R113.1, R114.2, U17.22 (ADDR)
USBC1_CC1: J5.A5 (CC_{1}), U17.2 (CC1), U21.1, U21.10
USBC1_CC2: J5.B5 (CC_{2}), U17.1 (CC2), U21.5, U21.6
USBC1_CONN_TX1_N: C70.1, J5.A2 (TX_{1}+), U20.4, U20.7
USBC1_CONN_TX1_P: C71.1, J5.A3 (TX_{1}-), U20.5, U20.6
USBC1_CONN_TX2_N: C69.1, J5.B2 (TX_{2}+), U19.4, U19.7
USBC1_CONN_TX2_P: C72.1, J5.B3 (TX_{2}-), U19.5, U19.6
USBC1_DIR: R126.1, U17.11 (DIR)
USBC1_FAULT_N: R135.1, TP32.1, U17.24 (VCONN_FAULT_N)
USBC1_FLG: R138.1, U18.3 (FLG)
USBC1_I2C_SDA: R124.2, R265.2, U17.25 (SDA/OUT1)
USBC1_ID: Q4.1 (G), R23.1, R24.2, R136.2, TP31.1, U17.27 (ID)
USBC1_ISC_SCL: R125.2, R266.2, U17.26 (SCL/OUT2)
USBC1_ISET: R139.2, U18.5 (ISET)
USBC1_I_MODE: R116.1, U17.3 (CURRENT_MODE)
USBC1_PEN: R136.1, R137.2, R184.1
USBC1_PORT: R115.2, U17.4 (PORT)
USBC1_RX1_N: J5.B10 (RX_{1}-), U17.14 (RX1-), U20.1, U20.10
USBC1_RX1_P: J5.B11 (RX_{1}+), U17.15 (RX1+), U20.2, U20.9
USBC1_RX2_N: J5.A10 (RX_{2}-), U17.18 (RX2-), U19.1, U19.10
USBC1_RX2_P: J5.A11 (RX_{2}+), U17.19 (RX2+), U19.2, U19.9
USBC1_TX1_N: C70.2, U17.16 (TX1-)
USBC1_TX1_P: C71.2, U17.17 (TX1+)
USBC1_TX2_N: C69.2, U17.20 (TX2-)
USBC1_TX2_P: C72.2, U17.21 (TX2+)
USBC1_VBUS: C74.1, C75.1, D10.1 (C), J5.A4 (VBUS), J5.A9 (VBUS), J5.B4 (VBUS), J5.B9 (VBUS), R60.2, R128.2, R140.2, TP29.1, U18.1 (OUT)
USBC1_VBUS_DET: R128.1, U17.5 (VBUS_DET)
USBSS1_C_RX_N: R200.2, U17.10 (RX-)
USBSS1_C_RX_P: R201.2, U17.9 (RX+)
USBSS1_C_TX_N: R202.2, U17.7 (TX-)
USBSS1_C_TX_P: R203.2, U17.6 (TX+)
USBSS2_RX_N: R201.1
USBSS2_RX_P: R200.1
USBSS2_TX_N: R203.1
USBSS2_TX_P: R202.1
USB_FLASH_ID: Q19.3 (D), R23.2
~USBC1_EN_CC: R119.2, U17.29 (ENn_CC)
~USBC1_EN_MUX: R118.2, U17.12 (ENn_MUX)
~USBC1_INT: R245.2, U17.23 (INT_N/OUT3)

Notes on the sheet:
Mode HIGH - DFP (HOST ONLY) LOW - UFP (DEVICE ONLY) DNP - DRP (DUAL ROLE PORT)
Enable MUX
Both DNP - GPIO Mode HIGH - I2C Mode 0x67 LOW - I2C Mode 0x47
USB-C 1
10k - 3A 500k - 1.5A DNP - 900mA
LOW: DFP role HIGH: NO ATTACH/UFP
NOTE: Populate 1/3
USBC1
LOW: VCONN OC TRIP HIGH: NORMAL OPERATION
Enable CC controller
