HW-Lab-Hardware-Design-Agency/jetson-orin-baseboard/usb.kicad_sch

## KiCad design usb.kicad_sch (2025-10-24)

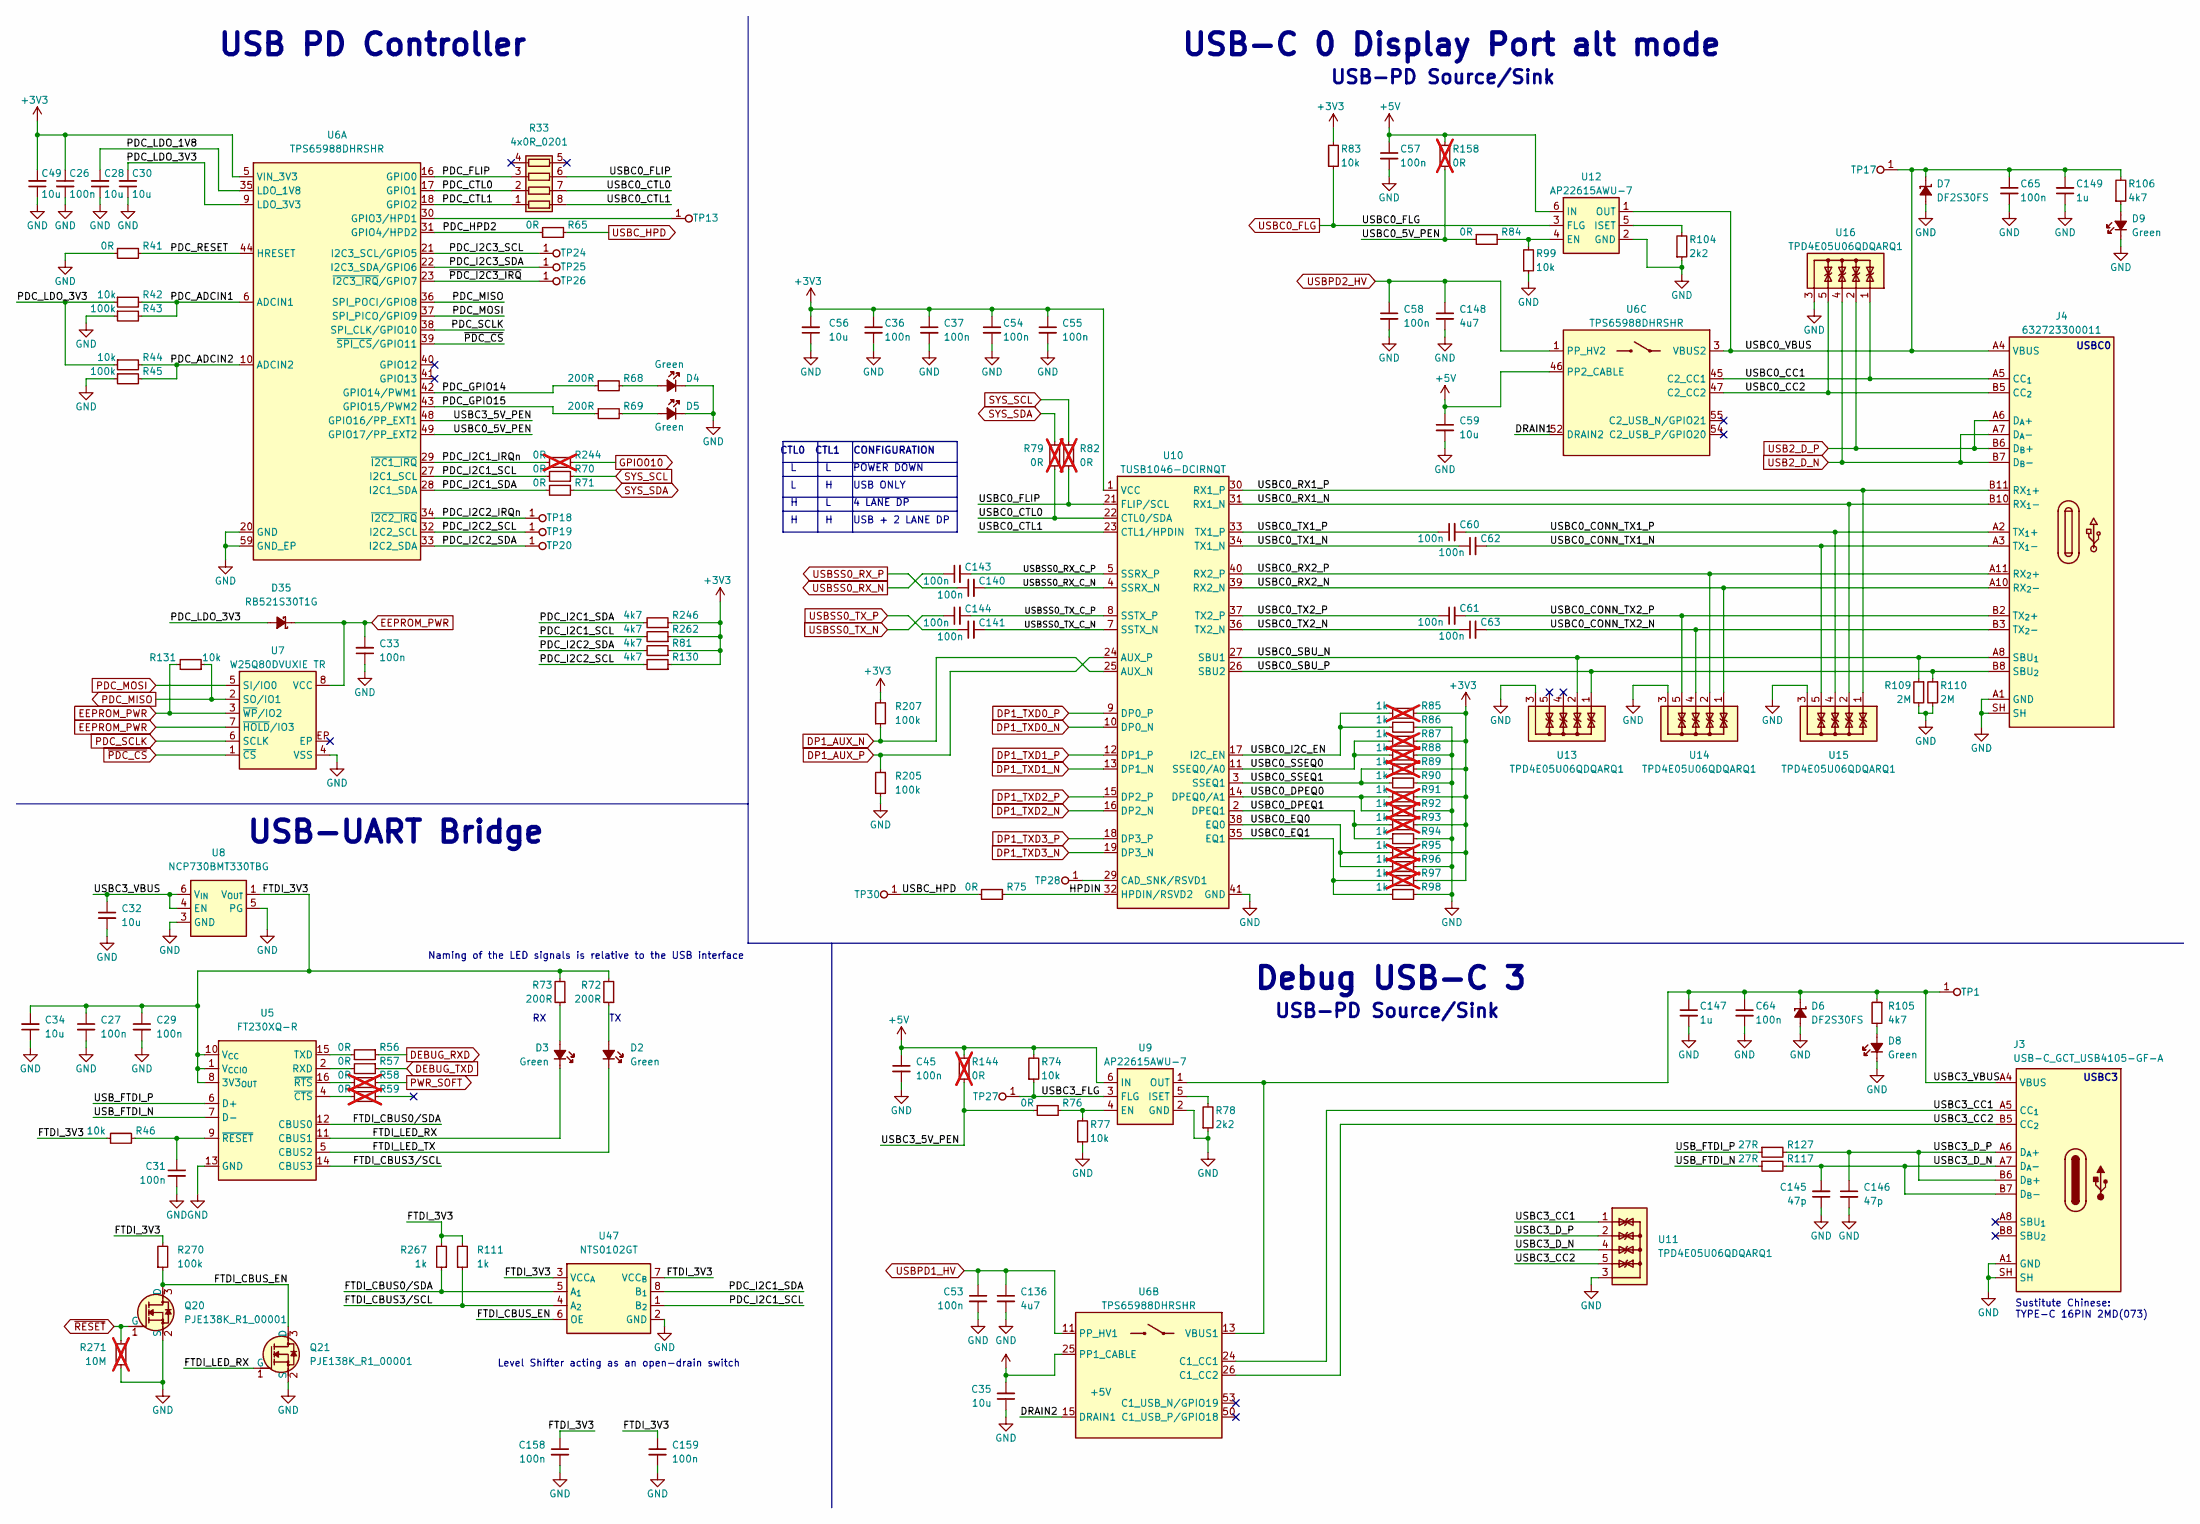
[picture p56: schematic usb.kicad_sch]

Parts:
C26, C27, C29, C31, C33, C36, C37, C45, C53, C54, C55, C57, C58, C60, C61, C62, C63, C64, C65, C140, C141, C143, C144, C158, C159: C_100n_0402; C_0402_1005Metric; Voltage 50V; MPN GRM155R61H104KE14D; LCSC Part # C85960
C28, C30, C34, C35, C49, C56, C59: C_10u_0402; C_0402_1005Metric; MPN CC0402MRX5R5BB106; LCSC Part # C105884
C32: C_10u_25V_0603; C_0603_1608Metric; Voltage 25V; MPN C1608X5R1E106M080AC; LCSC Part # C2168289
C136, C148: C_4u7_25V_0402; C_0402_1005Metric; Voltage 25V; MPN GRM155C61E475ME15J; LCSC Part # C5846150
C145, C146: C_47p_0402; C_0402_1005Metric; MPN C0402C470J5GACTU; LCSC Part # C2169042
C147, C149: C_1u_25V_0402; C_0402_1005Metric; Voltage 25V; MPN GRM155R61E105KE11J; LCSC Part # C3898487
D2, D3, D4, D5, D8, D9: LED_G_0603_LTST-C190GKT; LED_0603_1608Metric_G; MPN LTST-C190GKT; LCSC Part # C125093
D6, D7: DF2S30FS_SOD; SOD-923; MPN DF2S30FS; LCSC Part # C1973663
D35: RB521S30T1G; SOD-523; MPN RB521S30T1G; LCSC Part # C145179
J3: USB-C_GCT_USB4105-GF-A; USB-C_Receptacle_GCT_USB4105-GF-A; MPN USB4105-GF-A; LCSC Part # C3025063
J4: USB-C_WE_632723300011; USB-C_Receptacle_WE_632723300011; MPN 632723300011; Digikey Part # 732-9618-1-ND
Q20, Q21: PJE138K; SOT-523; MPN PJE138K_R1_00001; LCSC Part # C391643
R33: R_4x0R_0201_array; R_Array_4x0201_Panasonic_EXB18V; MPN EXB-18VR000X; LCSC Part # C1731295
R41, R56, R57, R65, R70, R71, R75, R76, R84: R_0R_0402; R_0402_1005Metric; MPN ERJ2GE0R00X; LCSC Part # C242160
R42, R44, R46, R74, R77, R83, R99, R131: R_10k_0402; R_0402_1005Metric; Tolerance 1%; MPN CR0402-FX-1002GLF; LCSC Part # C202396
R43, R45, R205, R207, R270: R_100k_0402; R_0402_1005Metric; Tolerance 1%; MPN CR0402-FX-1003GLF; LCSC Part # C2077080
R58, R59, R79, R82, R144, R158, R244: R_0R_0402; R_0402_1005Metric; MPN ERJ2GE0R00X; LCSC Part # C242160; not fitted
R68, R69, R72, R73: R_200R_0402; R_0402_1005Metric; Tolerance 1%; MPN CR0402-FX-2000GLF; LCSC Part # C19946422
R78, R104: R_2k2_0402; R_0402_1005Metric; Tolerance 1%; MPN CR0402-FX-2201GLF; LCSC Part # C2076845
R81, R105, R106, R130, R246, R262: R_4k7_0402; R_0402_1005Metric; Tolerance 1%; MPN CR0402-FX-4701GLF; LCSC Part # C2076851
R85, R87, R88, R89, R91, R92, R93, R95, R96, R97: R_1k_0402; R_0402_1005Metric; Tolerance 1%; MPN CR0402-FX-1001GLF; LCSC Part # C202394; not fitted
R86, R90, R94, R98, R111, R267: R_1k_0402; R_0402_1005Metric; Tolerance 1%; MPN CR0402-FX-1001GLF; LCSC Part # C202394
R109, R110: R_2M_0402; R_0402_1005Metric; Tolerance 1%; MPN RC0402FR-072ML; LCSC Part # C138014
R117, R127: R_27R_0402; R_0402_1005Metric; Tolerance 1%; MPN CR0402-FX-27R0GLF; LCSC Part # C19946387
R271: R_10M_0402; R_0402_1005Metric; Tolerance 1%; MPN CR0402-FX-1005GLF; LCSC Part # C5628762; not fitted
TP1, TP13, TP17, TP18, TP19, TP20, TP24, TP25, TP26, TP27, TP28, TP30: TP_0.75mm_SMD; TP_SMD_0.75mm
U5: FT230X_QFN; QFN-16-1EP_4x4mm_P0.65mm; MPN FT230XQ-R; Digikey Part # 768-1130-1-ND
U6: TPS65988DHRSHR; IC_TPS65987DDHRSHR; MPN TPS65988DHRSHR; LCSC Part # C2156209
U7: W25Q80DV_USON; USON-8_2x3mm_P0.5mm; MPN W25Q80DVUXIE TR; LCSC Part # C401667
U8: NCP730BMT330_WSON; WSON-6-1EP_2x2mm_P0.65mm; MPN NCP730BMT330TBG; LCSC Part # C892821
U9, U12: AP22615A_TSOT26; TSOT23-6; MPN AP22615AWU-7; LCSC Part # C2680357
U10: TUSB1046-DCIRNQ; WQFN-40_1EP_6x3mm_Pitch0.4mm_EP4.7x2.7mm; MPN TUSB1046-DCIRNQT; LCSC Part # C2652434
U11, U13, U14, U15, U16: TPD4E05U06QDQARQ1; USON-10_2.5x1mm_P0.5mm; MPN TPD4E05U06QDQARQ1; LCSC Part # C81353
U47: NTS0102_XSON; XSON-8_1x1.95mm_P0.5mm; MPN NTS0102GT; LCSC Part # C2687851

Connections:
+3V3: C26.1, C36.1, C37.1, C49.2, C54.1, C55.1, C56.2, R81.1, R83.2, R85.2, R87.2, R89.2, R91.2, R93.2, R95.2, R97.2, R130.1, R207.2, R246.1, R262.1, U6.5 (VIN_3V3), U10.1 (VCC), U10.6 (VCC), U10.20 (VCC), U10.28 (VCC)
+5V: C35.2, C45.1, C57.1, C59.1, R74.2, R144.2, R158.2, U6.25 (PP1_CABLE), U6.46 (PP2_CABLE), U9.6 (IN), U12.6 (IN)
DEBUG_RXD: R56.1
DEBUG_TXD: R57.1
DP1_AUX_N: R207.1, U10.25 (AUX_N)
DP1_AUX_P: R205.1, U10.24 (AUX_P)
DP1_TXD0_N: U10.10 (DP0_N)
DP1_TXD0_P: U10.9 (DP0_P)
DP1_TXD1_N: U10.13 (DP1_N)
DP1_TXD1_P: U10.12 (DP1_P)
DP1_TXD2_N: U10.16 (DP2_N)
DP1_TXD2_P: U10.15 (DP2_P)
DP1_TXD3_N: U10.19 (DP3_N)
DP1_TXD3_P: U10.18 (DP3_P)
DRAIN1: U6.7 (DRAIN2), U6.52 (DRAIN2), U6.56 (DRAIN2), U6.57 (DRAIN2)
DRAIN2: U6.8 (DRAIN1), U6.15 (DRAIN1), U6.19 (DRAIN1), U6.58 (DRAIN1)
EEPROM_PWR: C33.2, D35.1 (C), R131.2, U7.3 (~WP/IO2), U7.7 (~HOLD/IO3), U7.8 (VCC)
FTDI_3V3: C27.1, C29.1, C34.2, C158.1, C159.1, R46.1, R72.2, R73.2, R111.2, R267.2, R270.2, U5.1 (V_{CCIO}), U5.8 (3V3_{OUT}), U5.10 (V_{CC}), U8.1 (V_{OUT}), U47.3 (VCC_{A}), U47.7 (VCC_{B})
FTDI_CBUS0/SDA: R267.1, U5.12 (CBUS0), U47.5 (A_{1})
FTDI_CBUS3/SCL: R111.1, U5.14 (CBUS3), U47.4 (A_{2})
FTDI_CBUS_EN: Q20.3 (D), Q21.3 (D), R270.1, U47.6 (OE)
FTDI_LED_RX: D3.1 (C), Q21.1 (G), U5.11 (CBUS1)
FTDI_LED_TX: D2.1 (C), U5.5 (CBUS2)
GND: C26.2, C27.2, C28.1, C29.2, C30.1, C31.2, C32.2, C33.1, C34.1, C35.1, C36.2, C37.2, C45.2, C49.1, C53.2, C54.2, C55.2, C56.1, C57.2, C58.2, C59.2, C64.2, C65.2, C136.2, C145.1, C146.2, C147.2, C148.2, C149.1, C158.2, C159.2, D4.1 (C), D5.1 (C), D6.2 (A), D7.2 (A), D8.1 (C), D9.1 (C), J3.A1 (GND), J3.A12 (GND), J3.B1 (GND), J3.B12 (GND), J3.SH, J4.A1 (GND), J4.A12 (GND), J4.B1 (GND), J4.B12 (GND), J4.SH, Q20.2 (S), Q21.2 (S), R41.1, R43.1, R45.1, R77.1, R78.1, R86.2, R88.2, R90.2, R92.2, R94.2, R96.2, R98.2, R99.1, R104.1, R109.2, R110.2, R205.2, R271.1, U5.3 (GND), U5.13 (GND), U5.17 (GND), U6.20 (GND), U6.51 (GND), U6.59 (GND_EP), U7.4 (VSS), U8.3 (GND), U8.5 (PG), U8.7 (GND), U9.2 (GND), U10.41 (GND), U11.3, U11.8, U12.2 (GND), U13.3, U13.8, U14.3, U14.8, U15.3, U15.8, U16.3, U16.8, U47.2 (GND)
GPIO010: R244.1
HPDIN: R75.2, U10.32 (HPDIN/RSVD2)
unnamed: C31.1, R46.2, U5.9 (~RESET)
unnamed: D2.2 (A), R72.1
unnamed: D3.2 (A), R73.1
unnamed: D4.2 (A), R68.2
unnamed: D5.2 (A), R69.2
unnamed: D8.2 (A), R105.2
unnamed: D9.2 (A), R106.1
unnamed: R56.2, U5.15 (TXD)
unnamed: R57.2, U5.2 (RXD)
unnamed: R58.2, U5.16 (~RTS)
unnamed: R59.2, U5.4 (~CTS)
unnamed: R76.2, R77.2, U9.4 (EN)
unnamed: R78.2, U9.5 (ISET)
unnamed: R84.2, R99.2, U12.4 (EN)
unnamed: R104.2, U12.5 (ISET)
unnamed: TP13.1, U6.30 (GPIO3/HPD1)
unnamed: TP28.1, U10.29 (CAD_SNK/RSVD1)
unnamed: U13.4, U13.7
unnamed: U13.5, U13.6
PDC_ADCIN1: R42.2, R43.2, U6.6 (ADCIN1)
PDC_ADCIN2: R44.2, R45.2, U6.10 (ADCIN2)
PDC_CTL0: R33.2 (R2.1), U6.17 (GPIO1)
PDC_CTL1: R33.1 (R1.1), U6.18 (GPIO2)
PDC_FLIP: R33.3 (R3.1), U6.16 (GPIO0)
PDC_GPIO14: R68.1, U6.42 (GPIO14/PWM1)
PDC_GPIO15: R69.1, U6.43 (GPIO15/PWM2)
PDC_HPD2: R65.2, U6.31 (GPIO4/HPD2)
PDC_I2C1_IRQn: R244.2, U6.29 (~I2C1_IRQ)
PDC_I2C1_SCL: R70.2, R262.2, U6.27 (I2C1_SCL), U47.1 (B_{2})
PDC_I2C1_SDA: R71.2, R246.2, U6.28 (I2C1_SDA), U47.8 (B_{1})
PDC_I2C2_IRQn: TP18.1, U6.34 (~I2C2_IRQ)
PDC_I2C2_SCL: R130.2, TP19.1, U6.32 (I2C2_SCL)
PDC_I2C2_SDA: R81.2, TP20.1, U6.33 (I2C2_SDA)
PDC_I2C3_SCL: TP24.1, U6.21 (I2C3_SCL/GPIO5)
PDC_I2C3_SDA: TP25.1, U6.22 (I2C3_SDA/GPIO6)
PDC_LDO_1V8: C28.2, U6.35 (LDO_1V8)
PDC_LDO_3V3: C30.2, D35.2 (A), R42.1, R44.1, U6.9 (LDO_3V3)
PDC_MISO: R131.1, U6.36 (SPI_POCI/GPIO8), U7.2 (SO/IO1)
PDC_MOSI: U6.37 (SPI_PICO/GPIO9), U7.5 (SI/IO0)
PDC_RESET: R41.2, U6.44 (HRESET)
PDC_SCLK: U6.38 (SPI_CLK/GPIO10), U7.6 (SCLK)
PWR_SOFT: R58.1
SYS_SCL: R70.1, R82.2
SYS_SDA: R71.1, R79.2
USB2_D_N: J4.A7 (D_{A}-), J4.B7 (D_{B}-), U16.4, U16.7
USB2_D_P: J4.A6 (D_{A}+), J4.B6 (D_{B}+), U16.2, U16.9
USBC0_5V_PEN: R84.1, R158.1, U6.49 (GPIO17/PP_EXT2)
USBC0_CC1: J4.A5 (CC_{1}), U6.45 (C2_CC1), U16.1, U16.10
USBC0_CC2: J4.B5 (CC_{2}), U6.47 (C2_CC2), U16.5, U16.6
USBC0_CONN_TX1_N: C62.2, J4.A3 (TX_{1}-), U15.5, U15.6
USBC0_CONN_TX1_P: C60.2, J4.A2 (TX_{1}+), U15.4, U15.7
USBC0_CONN_TX2_N: C63.2, J4.B3 (TX_{2}-), U14.4, U14.7
USBC0_CONN_TX2_P: C61.2, J4.B2 (TX_{2}+), U14.5, U14.6
USBC0_CTL0: R33.7 (R2.2), R79.1, U10.22 (CTL0/SDA)
USBC0_CTL1: R33.8 (R1.2), U10.23 (CTL1/HPDIN)
USBC0_DPEQ0: R91.1, R92.1, U10.14 (DPEQ0/A1)
USBC0_DPEQ1: R93.1, R94.1, U10.2 (DPEQ1)
USBC0_EQ0: R95.1, R96.1, U10.38 (EQ0)
USBC0_EQ1: R97.1, R98.1, U10.35 (EQ1)
USBC0_FLG: R83.1, U12.3 (FLG)
USBC0_FLIP: R33.6 (R3.2), R82.1, U10.21 (FLIP/SCL)
USBC0_I2C_EN: R85.1, R86.1, U10.17 (I2C_EN)
USBC0_RX1_N: J4.B10 (RX_{1}-), U10.31 (RX1_N), U15.2, U15.9
USBC0_RX1_P: J4.B11 (RX_{1}+), U10.30 (RX1_P), U15.1, U15.10
USBC0_RX2_N: J4.A10 (RX_{2}-), U10.39 (RX2_N), U14.1, U14.10
USBC0_RX2_P: J4.A11 (RX_{2}+), U10.40 (RX2_P), U14.2, U14.9
USBC0_SBU_N: J4.A8 (SBU_{1}), R109.1, U10.27 (SBU1), U13.2, U13.9
USBC0_SBU_P: J4.B8 (SBU_{2}), R110.1, U10.26 (SBU2), U13.1, U13.10
USBC0_SSEQ0: R87.1, R88.1, U10.11 (SSEQ0/A0)
USBC0_SSEQ1: R89.1, R90.1, U10.3 (SSEQ1)
USBC0_TX1_N: C62.1, U10.34 (TX1_N)
USBC0_TX1_P: C60.1, U10.33 (TX1_P)
USBC0_TX2_N: C63.1, U10.36 (TX2_N)
USBC0_TX2_P: C61.1, U10.37 (TX2_P)
USBC0_VBUS: C65.1, C149.2, D7.1 (C), J4.A4 (VBUS), J4.A9 (VBUS), J4.B4 (VBUS), J4.B9 (VBUS), R106.2, TP17.1, U6.3 (VBUS2), U12.1 (OUT)
USBC3_5V_PEN: R76.1, R144.1, U6.48 (GPIO16/PP_EXT1)
USBC3_CC1: J3.A5 (CC_{1}), U6.24 (C1_CC1), U11.1, U11.10
USBC3_CC2: J3.B5 (CC_{2}), U6.26 (C1_CC2), U11.5, U11.6
USBC3_D_N: C145.2, J3.A7 (D_{A}-), J3.B7 (D_{B}-), R117.2, U11.4, U11.7
USBC3_D_P: C146.1, J3.A6 (D_{A}+), J3.B6 (D_{B}+), R127.2, U11.2, U11.9
USBC3_FLG: R74.1, TP27.1, U9.3 (FLG)
USBC3_VBUS: C32.1, C64.1, C147.1, D6.1 (C), J3.A4 (VBUS), J3.A9 (VBUS), J3.B4 (VBUS), J3.B9 (VBUS), R105.1, TP1.1, U6.13 (VBUS1), U8.4 (EN), U8.6 (V_{IN}), U9.1 (OUT)
USBC_HPD: R65.1, R75.1, TP30.1
USBPD1_HV: C53.1, C136.1, U6.11 (PP_HV1)
USBPD2_HV: C58.1, C148.1, U6.1 (PP_HV2)
USBSS0_RX_C_N: C140.2, U10.4 (SSRX_N)
USBSS0_RX_C_P: C143.2, U10.5 (SSRX_P)
USBSS0_RX_N: C143.1
USBSS0_RX_P: C140.1
USBSS0_TX_C_N: C141.2, U10.7 (SSTX_N)
USBSS0_TX_C_P: C144.2, U10.8 (SSTX_P)
USBSS0_TX_N: C144.1
USBSS0_TX_P: C141.1
USB_FTDI_N: R117.1, U5.7 (D-)
USB_FTDI_P: R127.1, U5.6 (D+)
~PDC_CS: U6.39 (~SPI_CS/GPIO11), U7.1 (~CS)
~PDC_I2C3_IRQ: TP26.1, U6.23 (~I2C3_IRQ/GPIO7)
~RESET: Q20.1 (G), R271.2

Notes on the sheet:
USB-UART Bridge
POWER DOWN
USB PD Controller
Sustitute Chinese: TYPE-C 16PIN 2MD(073)
USB-PD Source/Sink
USB-C 0 Display Port alt mode
4 LANE DP
Naming of the LED signals is relative to the USB interface
CONFIGURATION
USBC0
Debug USB-C 3
USB + 2 LANE DP
Level Shifter acting as an open-drain switch
USBC3
CTL0
CTL1
USB ONLY
