HW-Lab-Hardware-Design-Agency/jetson-orin-baseboard/(commit log)

2025-02-21 Init commit
    [1054301202.stp, 33FXRH-SM1-GAN-TF.STEP, 5-2337992-8.stp, 533980471.stp, 632723300011.stp, 685119136923.stp, 68715014522.stp, 9774065151.stp]
2025-03-05 Add field Digikey Part Number. Add Chinese substitute components
    [BOM.xlsx, TUSB1046-DCIRNQT.STEP, USB4105-GF-A.STEP, bom.csv, csi.kicad_sch, designators.csv, ethernet.kicad_sch, hdmi.kicad_sch]
2025-03-19 Fix solder mask opening mismatch with circuit layer legends
    [PCM12SMTR.step]
2025-10-24 Update: reorganized schematic layout for Jetson Orin Baseboard
    [csi.kicad_sch, ethernet.kicad_sch, hdmi.kicad_sch, jetson-orin-baseboard.kicad_sch, m-2.kicad_sch, peripherals.kicad_sch, som.kicad_sch, supply.kicad_sch]
