HW-Lab-Hardware-Design-Agency/jetson-orin-baseboard/(notices)

Notices in the files:
3Dlib/D_SMA.step:
Copyright (C) 2017, kicad StepUp
This program is free software: you can redistribute it and/or modify
it under the terms of the GNU General Public License as published by
the Free Software Foundation, either version 3 of the License, or
any later version.
itself might be covered by the GNU General Public License.
3Dlib/L_0402_1005Metric.step:
This work is licensed under the [Creative Commons CC-BY-SA 4.0 License](https://creativecommons.org/licenses/by-sa/4.0/legalcode),
with the following exception:
To the extent that the creation of electronic designs that use 'Licensed Material' can be considered to be 'Adapted Material',
You are free to use the library data in your own projects without the obligation to share your project files under this or any other license agreement.
3Dlib/c_1210.step:
Copyright (C) 2018, kicad StepUp
3Dlib/led_0603.step:
Copyright (C) 2020, kicad StepUp
parts and their libraries:
License: Apache-2.0
License: MIT
